DIYLAB-DE/RetroRadio/docs/hardware/README.md

# Gehäuse, Druckdateien und Befestigung

[RetroRadio](../../README.md) > [Dokumentation](../../README.md#dokumentation) > [Aufbau](../Aufbau.md) > Gehäuse, Druckdateien und Befestigung

Die Konstruktion besteht aus Gehäuse, Lautsprecherabdeckung, Lautsprechereinsätzen, einer Grundplatte für die Baugruppen und einem Aufsteller. Die Rev.2 verwendet Visaton BF 37 mit 4 Ohm. Für die frühere Rev.1 ist zusätzlich der Einsatz für Visaton SC 4.9 FL enthalten. Die Aufbauversion ist unabhängig von der Flashgröße des Displayboards.

## Dateien

| Bauteil | Druckprojekt | Bearbeitbares Austauschformat |
| --- | --- | --- |
| Gehäuse | [3MF](3d-druck/H2C_PETG_Case.3mf) | [STEP](cad/H2C_PETG_Case.step) |
| Lautsprecherabdeckung | [3MF](3d-druck/H2C_PETG_Speaker_Grille.3mf) | [STEP](cad/H2C_PETG_Speaker_Grille.step) |
| Lautsprechereinsatz BF 37, Rev.2 | [3MF](3d-druck/H2C_PETG_Speaker_Mounting_Insert_BF37.3mf) | [STEP](cad/H2C_PETG_Speaker_Mounting_Insert_BF37.step) |
| Lautsprechereinsatz SC 4.9 FL, Rev.1 | [3MF](3d-druck/H2C_PETG_Speaker_Mounting_Insert_SC_49_20FL.3mf) | [STEP](cad/H2C_PETG_Speaker_Mounting_Insert_SC_49_20FL.step) |
| Grundplatte für die Baugruppen | [3MF](3d-druck/H2C_PETG_Base_Plate.3mf) | [STEP](cad/H2C_PETG_Base_Plate.step) |
| Aufsteller | [3MF](3d-druck/H2C_PETG_Stand.3mf) | [STEP](cad/H2C_PETG_Stand.step) |

Die Lautsprechergitter hat **Frank alias Tubefan aus dem RBF (Radio-Bastler-Forum)** im CAD erstellt. Herzlichen Dank für diesen Beitrag!

## CAD-Dateien anpassen

Für eigene konstruktive Anpassungen an Gehäuse, Grundplatte oder Befestigungspunkten verwendest Du die bereitgestellten STEP-Dateien. CAD-Programme mit STEP-Import sind beispielsweise [SolidCraft](https://docs.solidcraft.io/guide/files.html) und [FreeCAD](https://github.com/FreeCAD/FreeCAD-documentation/blob/main/wiki/Part_Import.md). Nach dem Import arbeitest Du mit der vorhandenen Bauteilgeometrie weiter. Der ursprüngliche Konstruktionsverlauf ist in den STEP-Dateien nicht enthalten. Die 3MF-Dateien sind die vorbereiteten Druckprojekte für die gezeigten Teile.

Die Grundplatte und die zugehörigen 3MF- und STEP-Dateien sind für die Bestückung mit Adafruit-Audio-Modulen ausgelegt. Für das [alternative PCM5102A-Modul](../Aufbau.md#alternatives-pcm5102a-modul) müssen Befestigung und gegebenenfalls der Zugang zur Klinkenbuchse individuell angepasst werden. Eine dafür angepasste Druck- oder CAD-Datei ist noch nicht enthalten.

## Lizenz

Alle bereitgestellten 3MF-Druckprojekte und STEP-CAD-Dateien stehen unter **CC BY-NC-SA 4.0**. Teilen und Bearbeiten sind für nichtkommerzielle Zwecke erlaubt. Die Urheber müssen genannt und Bearbeitungen unter gleichen Lizenzbedingungen weitergegeben werden. Kommerzielle Nutzung ist nicht gestattet. Die [Zuordnung zu den Dateien und Urhebern](LIZENZ.txt) und der [vollständige Lizenztext](../lizenzen/CC-BY-NC-SA-4.0.txt) liegen bei. Diese Lizenz betrifft ausschließlich die CAD- und Druckdateien.

## Druckmaterial

Die Bauteile werden mit **funkelndem TINMORRY PETG Filament von Amazon** gedruckt. Die Druckprofile der 3MF-Projekte verwenden teilweise andere Materialbezeichnungen. Passe Temperatur und Kühlung an Dein Filament an und prüfe die Druckvorschau.

## Druckprojekte verwenden

Die 3MF-Dateien sind vollständige Druckprojekte mit Profilen für einen Bambu Lab H2C mit 0,4-mm-Düse. In den bereitgestellten Projekten sind 0,2 mm Schichthöhe eingestellt. Die Materialprofile umfassen PETG und bei den Lautsprechereinsätzen auch PETG-CF. Übernimm für Deinen Drucker dessen eigenes Drucker- und Materialprofil und prüfe die Druckvorschau. Die gespeicherten Profile sind kein universeller Druckauftrag für andere Maschinen.

Das Gehäuse benötigt den Bauraum eines H2C oder eines ähnlich großen Bambu-Druckers. Alle übrigen Teile passen auch auf kleinere Drucker. Alle sechs bereitgestellten Druckprojekte wurden für die gezeigten Bauteile verwendet.

| Bauteil | Wandlinien | Fülldichte | Stützmaterial im Projekt |
| --- | --- | --- | --- |
| Gehäuse | 3 | 15 % | aus |
| Lautsprecherabdeckung | 5 | 15 % | aus |
| Beide Lautsprechereinsätze | 4 | 20 % | aus |
| Grundplatte und Aufsteller | 2 | 15 % | aus |

Die Vorschauen stammen unmittelbar aus den mitgelieferten Druckprojekten:

| Gehäuse | Grundplatte | Aufsteller |
| --- | --- | --- |
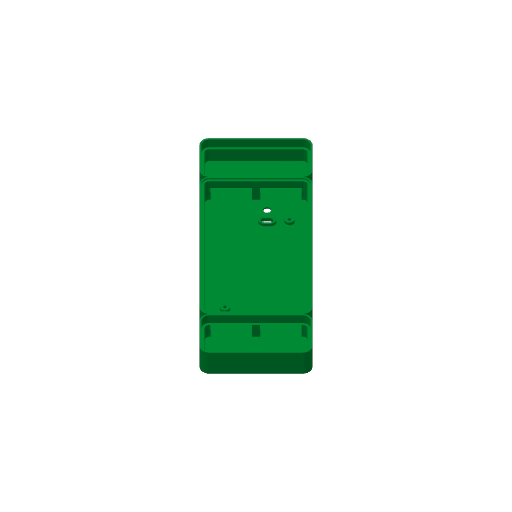
[picture p5: docs/bilder/aufbau/H2C_PETG_Case.png]
Gehäuse
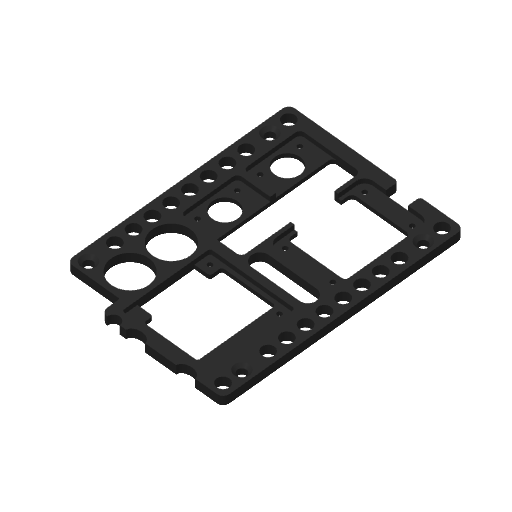
[picture p6: docs/bilder/aufbau/H2C_PETG_Base_Plate.png]
Grundplatte
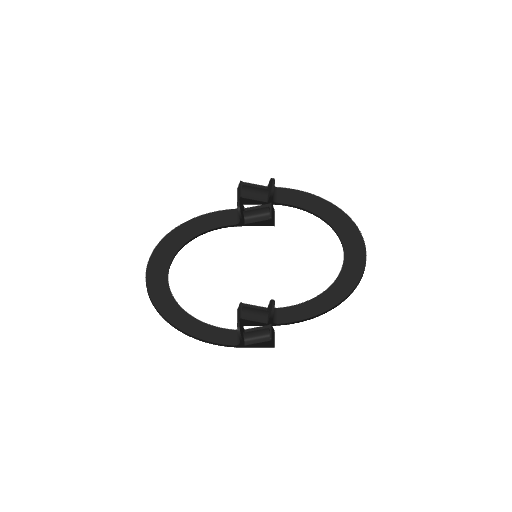
[picture p7: docs/bilder/aufbau/H2C_PETG_Stand.png]
Aufsteller
|  |  |  |

| Abdeckung | Einsatz BF 37 | Einsatz SC 4.9 FL |
| --- | --- | --- |
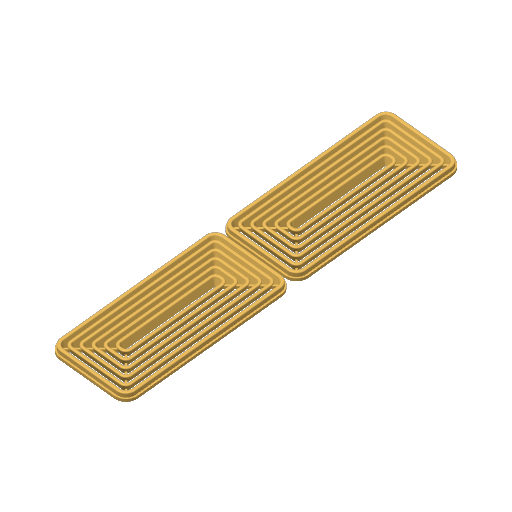
[picture p8: docs/bilder/aufbau/H2C_PETG_Speaker_Grille.png]
Abdeckung
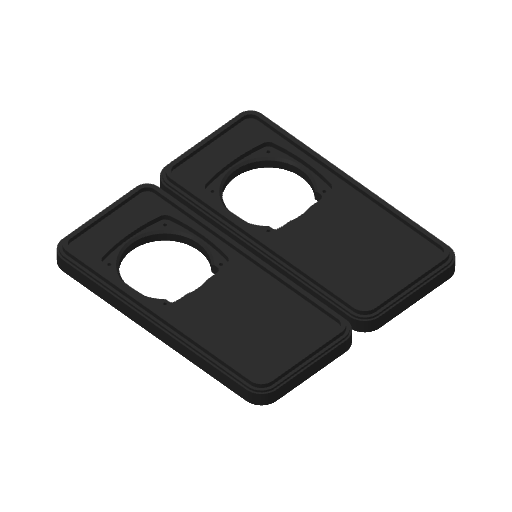
[picture p9: docs/bilder/aufbau/H2C_PETG_Speaker_Mounting_Insert_BF37.png]
Einsatz BF 37
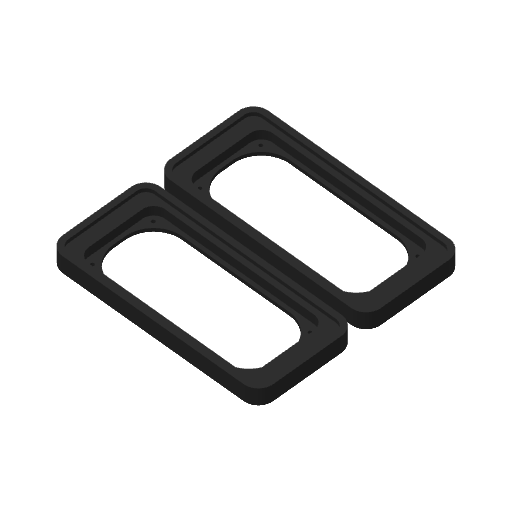
[picture p10: docs/bilder/aufbau/H2C_PETG_Speaker_Mounting_Insert_SC_49_20FL.png]
Einsatz SC 4.9 FL
|  |  |  |

## Befestigungsmittel

> **Display ohne Verklebung montieren:** Die beiden Befestigungsschrauben reichen zum sicheren Halt im Gehäuse aus. Die Abdeckfolie auf der Glasrückseite bleibt angebracht, nur ihre Abziehlasche wird abgeschnitten. Die beiden Schutzfolien der Vorderseite werden entfernt. Die genaue Zuordnung der Folien steht in der [Aufbauanleitung](../Aufbau.md#display-und-befestigungsbolzen).

Die kleinen Schrauben zur Befestigung von Verstärkern, RTC und DAC auf der Grundplatte stammen aus einem Sortiment mit der Bezeichnung **Black Zinc-Plated Carbon Steel Pan Flat Head Self Tapping Screws Metric**. Im Sortiment heißen sie **M2*5**. Es sind selbstschneidende Schrauben und keine metrischen M2-Maschinenschrauben. Die Sortimentsbezeichnung allein ist daher keine Gewindeangabe nach metrischer Norm.

Für die übrigen Verbindungen werden Schrauben in M2,5 und M3 aus dem Sortiment **Alloy Steel Grade 10.9 Button Flat Socket Head Screws** verwendet. Wähle Länge und Ausführung passend zum jeweiligen Bauteil und zur tatsächlich verfügbaren Einschraubtiefe. Die Sortimentskästen sind in den Aufbaufotos zu sehen und dienen der Zuordnung der verwendeten Teile.

Für die Befestigung brauchst Du außerdem **vier Bolzen mit M2,5-Gewinde und 4 mm langem Körper** sowie **zwei Bolzen mit M3-Gewinde und 15 mm langem Körper**.

> **Nur die außenliegenden Gewinde kürzen.** Die Bolzenkörper bleiben 4 mm beziehungsweise 15 mm lang. Zu lange Gewinde können bis an das Display reichen und es beschädigen. Prüfe die verfügbare Einschraubtiefe vor der Montage und gleiche die Gewindelänge mit der gezeigten gekürzten Ausführung ab. Die kurzen Bolzen halten die Grundplatte. Die zwei langen M3-Bolzen sitzen diagonal am Display an den konstruktiv vorgesehenen Punkten.

Die bearbeiteten Bolzen sind im Montagefoto links als Ausgangsteile und rechts mit gekürzten Außengewinden dargestellt. Die kurzen Bolzen können bei Bedarf direkt an der Platine festgelötet werden, falls die Gewinde im Display sie nicht halten.

| Selbstschneidende Schrauben | Metrische Schrauben | Bolzen mit gekürzten Außengewinden |
| --- | --- | --- |
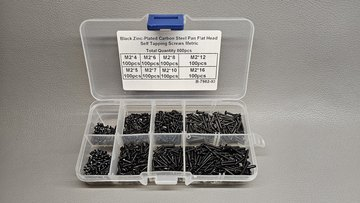
[picture p11: docs/bilder/aufbau/20260822_193423-klein.jpg]
Schraubensortiment
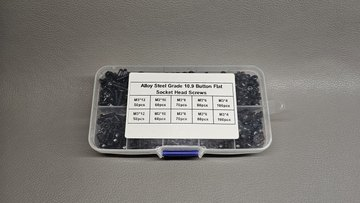
[picture p12: docs/bilder/aufbau/20260822_193522-klein.jpg]
Metrisches Sortiment
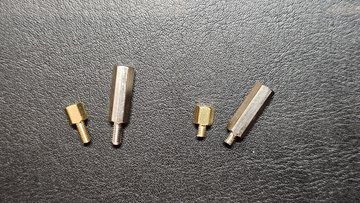
[picture p13: docs/bilder/aufbau/20261028_213523-klein.jpg]
Befestigungsbolzen
|  |  |  |

Weiter mit der [Aufbauanleitung](../Aufbau.md) oder der vollständigen [Fotogalerie](../Fotogalerie.md).

[RetroRadio](../../README.md) > [Dokumentation](../../README.md#dokumentation) > [Aufbau](../Aufbau.md) > Gehäuse, Druckdateien und Befestigung
