DIYLAB-DE/RetroRadio/docs/werkstatt/README.md

# Werkstatt

[RetroRadio](../../README.md) > [Dokumentation](../../README.md#dokumentation) > Werkstatt

38 Werkzeuge in sieben Kategorien. Im linken Menü nach oben oder unten wischen und das gewünschte Werkzeug antippen. Rechts stehen Inhalt und Eingaben, die Tasten am unteren Rand gehören zum gewählten Werkzeug. Die Taste ganz rechts verlässt die Werkstatt.

Die kleinen Vorschaubilder öffnen die vollständigen Screenshots mit 800 x 480 Pixeln. Jede Werkzeugseite erklärt Zweck und Bedienung. Die früheren Website-Links und ihre QR-Code-Tasten in den Werkzeugüberschriften entfallen seit v26.11.7. Ältere Werkzeugaufnahmen können diese Tasten noch zeigen.

## Werkzeuge

| Werkzeug | Vorschau |
| --- | --- |
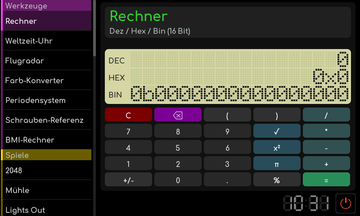
[picture p14: docs/bilder/werkstatt/werkstatt-calculator-klein.png]
Rechner
| [Rechner](calculator.md) | [](calculator.md) |
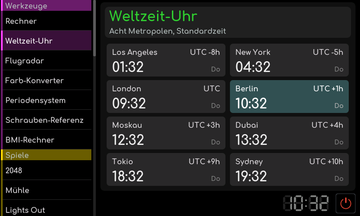
[picture p15: docs/bilder/werkstatt/werkstatt-world-clock-klein.png]
Weltzeit-Uhr
| [Weltzeit-Uhr](world-clock.md) | [](world-clock.md) |
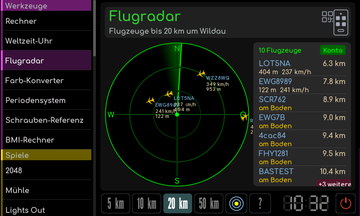
[picture p16: docs/bilder/werkstatt/werkstatt-flight-radar-klein.png]
Flugradar
| [Flugradar](flight-radar.md) | [](flight-radar.md) |
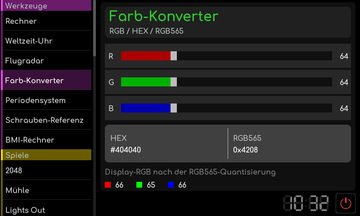
[picture p17: docs/bilder/werkstatt/werkstatt-color-converter-klein.png]
Farb-Konverter
| [Farb-Konverter](color-converter.md) | [](color-converter.md) |
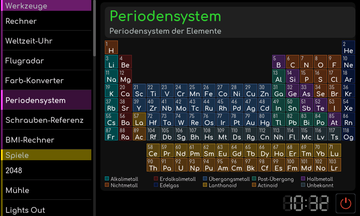
[picture p18: docs/bilder/werkstatt/werkstatt-periodic-table-klein.png]
Periodensystem
| [Periodensystem](periodic-table.md) | [](periodic-table.md) |
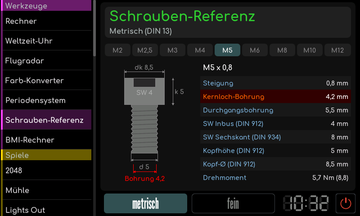
[picture p19: docs/bilder/werkstatt/werkstatt-screw-reference-klein.png]
Schrauben-Referenz
| [Schrauben-Referenz](screw-reference.md) | [](screw-reference.md) |
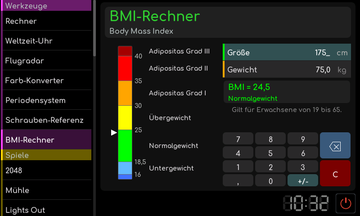
[picture p20: docs/bilder/werkstatt/werkstatt-bmi-calculator-klein.png]
BMI-Rechner
| [BMI-Rechner](bmi-calculator.md) | [](bmi-calculator.md) |

## Spiele

| Werkzeug | Vorschau |
| --- | --- |
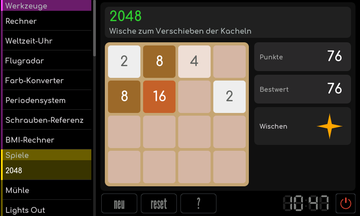
[picture p21: docs/bilder/werkstatt/werkstatt-game-2048-klein.png]
| [2048](game-2048.md) | [](game-2048.md) |
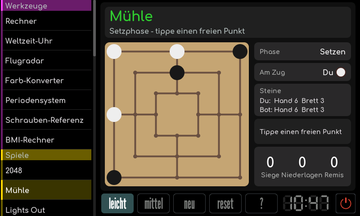
[picture p22: docs/bilder/werkstatt/werkstatt-mill-game-klein.png]
Mühle
| [Mühle](mill-game.md) | [](mill-game.md) |
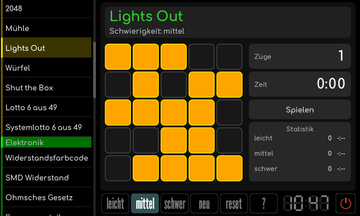
[picture p23: docs/bilder/werkstatt/werkstatt-lights-out-klein.png]
Lights Out
| [Lights Out](lights-out.md) | [](lights-out.md) |
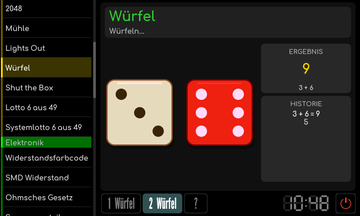
[picture p24: docs/bilder/werkstatt/werkstatt-dice-klein.png]
Würfel
| [Würfel](dice.md) | [](dice.md) |
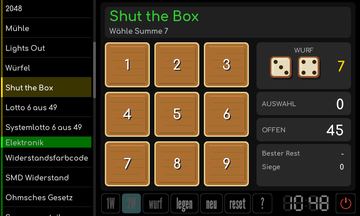
[picture p25: docs/bilder/werkstatt/werkstatt-shut-the-box-klein.png]
Shut the Box
| [Shut the Box](shut-the-box.md) | [](shut-the-box.md) |
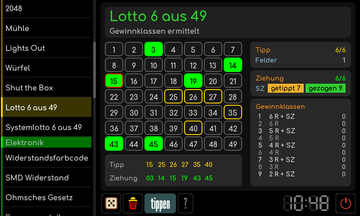
[picture p26: docs/bilder/werkstatt/werkstatt-lotto-normal-klein.png]
Lotto 6 aus 49
| [Lotto 6 aus 49](lotto-normal.md) | [](lotto-normal.md) |
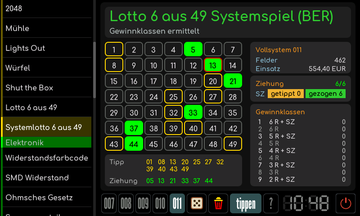
[picture p27: docs/bilder/werkstatt/werkstatt-lotto-system-klein.png]
Lotto-System
| [Lotto-System](lotto-system.md) | [](lotto-system.md) |

## Elektronik

| Werkzeug | Vorschau |
| --- | --- |
| [Widerstandsfarbcode](resistor-color-code.md) | [Widerstandsfarbcode](resistor-color-code.md) |
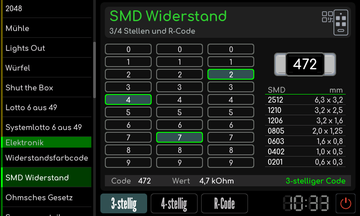
[picture p28: docs/bilder/werkstatt/werkstatt-smd-resistor-code-klein.png]
SMD-Widerstandscode
| [SMD-Widerstandscode](smd-resistor-code.md) | [](smd-resistor-code.md) |
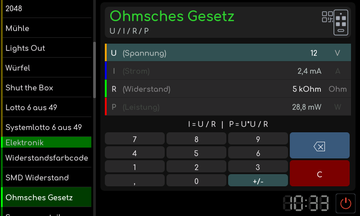
[picture p29: docs/bilder/werkstatt/werkstatt-ohm-calculator-klein.png]
Ohmsches Gesetz
| [Ohmsches Gesetz](ohm-calculator.md) | [](ohm-calculator.md) |
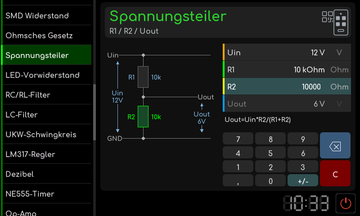
[picture p30: docs/bilder/werkstatt/werkstatt-voltage-divider-klein.png]
Spannungsteiler
| [Spannungsteiler](voltage-divider.md) | [](voltage-divider.md) |
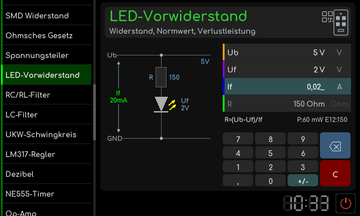
[picture p31: docs/bilder/werkstatt/werkstatt-led-resistor-calculator-klein.png]
LED-Vorwiderstand
| [LED-Vorwiderstand](led-resistor-calculator.md) | [](led-resistor-calculator.md) |
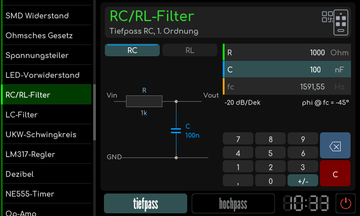
[picture p32: docs/bilder/werkstatt/werkstatt-rc-rl-filter-calculator-klein.png]
RC/RL-Filter
| [RC/RL-Filter](rc-rl-filter-calculator.md) | [](rc-rl-filter-calculator.md) |
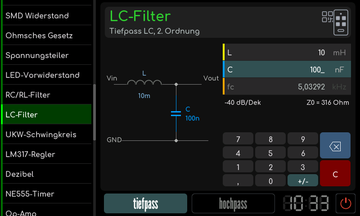
[picture p33: docs/bilder/werkstatt/werkstatt-lc-filter-calculator-klein.png]
LC-Filter
| [LC-Filter](lc-filter-calculator.md) | [](lc-filter-calculator.md) |
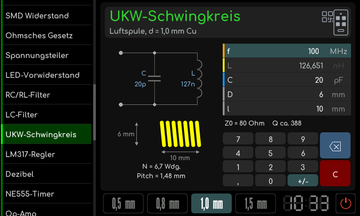
[picture p34: docs/bilder/werkstatt/werkstatt-ukw-resonator-klein.png]
UKW-Schwingkreis
| [UKW-Schwingkreis](ukw-resonator.md) | [](ukw-resonator.md) |
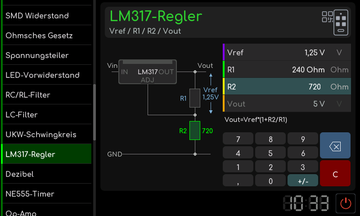
[picture p35: docs/bilder/werkstatt/werkstatt-lm317-calculator-klein.png]
LM317-Regler
| [LM317-Regler](lm317-calculator.md) | [](lm317-calculator.md) |
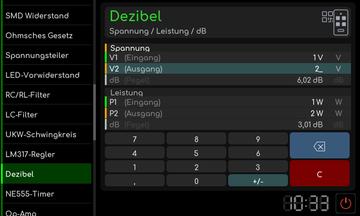
[picture p36: docs/bilder/werkstatt/werkstatt-decibel-calculator-klein.png]
Dezibel
| [Dezibel](decibel-calculator.md) | [](decibel-calculator.md) |
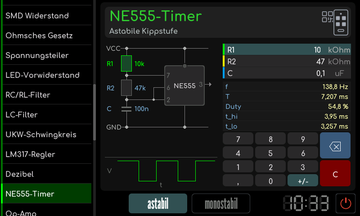
[picture p37: docs/bilder/werkstatt/werkstatt-ne555-calculator-klein.png]
NE555-Timer
| [NE555-Timer](ne555-calculator.md) | [](ne555-calculator.md) |
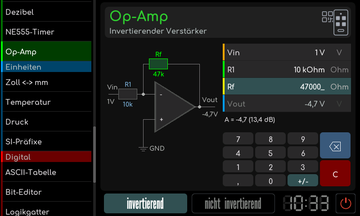
[picture p38: docs/bilder/werkstatt/werkstatt-opamp-calculator-klein.png]
Op-Amp
| [Op-Amp](opamp-calculator.md) | [](opamp-calculator.md) |

## Einheiten

| Werkzeug | Vorschau |
| --- | --- |
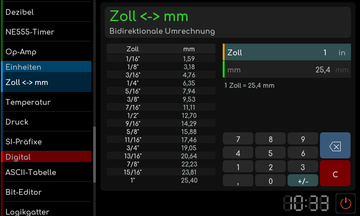
[picture p39: docs/bilder/werkstatt/werkstatt-inch-mm-calculator-klein.png]
Zoll und Millimeter
| [Zoll und Millimeter](inch-mm-calculator.md) | [](inch-mm-calculator.md) |
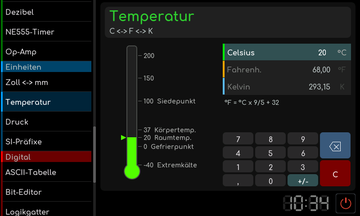
[picture p40: docs/bilder/werkstatt/werkstatt-temp-calculator-klein.png]
Temperatur
| [Temperatur](temp-calculator.md) | [](temp-calculator.md) |
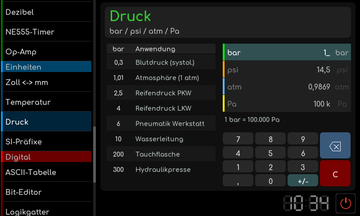
[picture p41: docs/bilder/werkstatt/werkstatt-pressure-calculator-klein.png]
Druck
| [Druck](pressure-calculator.md) | [](pressure-calculator.md) |
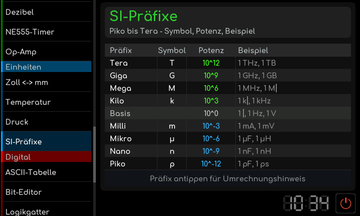
[picture p42: docs/bilder/werkstatt/werkstatt-si-prefixes-klein.png]
SI-Präfixe
| [SI-Präfixe](si-prefixes.md) | [](si-prefixes.md) |

## Digital

| Werkzeug | Vorschau |
| --- | --- |
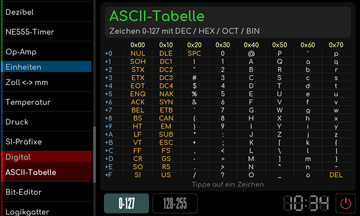
[picture p43: docs/bilder/werkstatt/werkstatt-ascii-table-klein.png]
ASCII-Tabelle
| [ASCII-Tabelle](ascii-table.md) | [](ascii-table.md) |
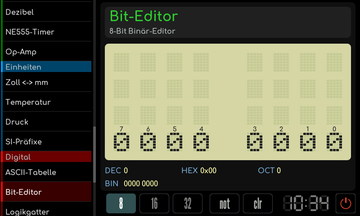
[picture p44: docs/bilder/werkstatt/werkstatt-bit-editor-klein.png]
Bit-Editor
| [Bit-Editor](bit-editor.md) | [](bit-editor.md) |
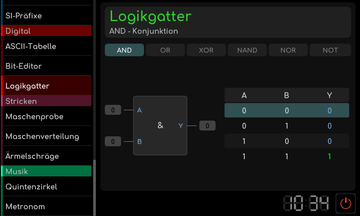
[picture p45: docs/bilder/werkstatt/werkstatt-logic-gate-sim-klein.png]
Logikgatter
| [Logikgatter](logic-gate-sim.md) | [](logic-gate-sim.md) |

## Stricken

| Werkzeug | Vorschau |
| --- | --- |
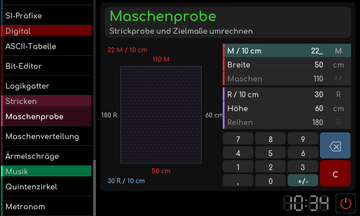
[picture p46: docs/bilder/werkstatt/werkstatt-stitch-gauge-klein.png]
Maschenprobe
| [Maschenprobe](stitch-gauge.md) | [](stitch-gauge.md) |
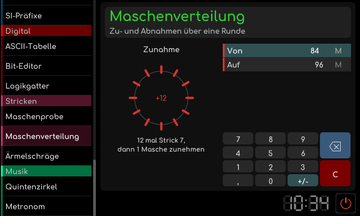
[picture p47: docs/bilder/werkstatt/werkstatt-stitch-distributor-klein.png]
Maschenverteilung
| [Maschenverteilung](stitch-distributor.md) | [](stitch-distributor.md) |
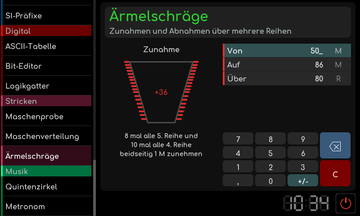
[picture p48: docs/bilder/werkstatt/werkstatt-sleeve-taper-klein.png]
Ärmelschräge
| [Ärmelschräge](sleeve-taper.md) | [](sleeve-taper.md) |

## Musik

| Werkzeug | Vorschau |
| --- | --- |
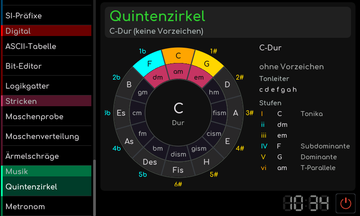
[picture p49: docs/bilder/werkstatt/werkstatt-circle-of-fifths-klein.png]
Quintenzirkel
| [Quintenzirkel](circle-of-fifths.md) | [](circle-of-fifths.md) |
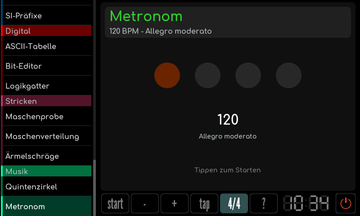
[picture p50: docs/bilder/werkstatt/werkstatt-metronome-klein.png]
Metronom
| [Metronom](metronome.md) | [](metronome.md) |

[Zur allgemeinen Bedienung](../Bedienung.md)

[RetroRadio](../../README.md) > [Dokumentation](../../README.md#dokumentation) > Werkstatt
