DIYLAB-DE/RetroRadio/docs/werkstatt/inch-mm-calculator.md

# Zoll und Millimeter

[RetroRadio](../../README.md) > [Dokumentation](../../README.md#dokumentation) > [Werkstatt](README.md) > [Einheiten](README.md#einheiten) > Zoll und Millimeter

Tippe das Zoll- oder Millimeterfeld an und gib einen Wert ein. Der andere Wert wird mit 1 Zoll = 25,4 mm umgerechnet. Die Bruchauswahl hilft bei üblichen Zollmaßen. Beispiel: 1/2 Zoll entspricht 12,7 mm.

Zoll und Millimeter

[RetroRadio](../../README.md) > [Dokumentation](../../README.md#dokumentation) > [Werkstatt](README.md) > [Einheiten](README.md#einheiten) > Zoll und Millimeter
