DIYLAB-DE/RetroRadio/docs/werkstatt/mill-game.md

# Mühle

[RetroRadio](../../README.md) > [Dokumentation](../../README.md#dokumentation) > [Werkstatt](README.md) > [Spiele](README.md#spiele) > Mühle

Du spielst mit neun Steinen gegen den Bot. Zunächst freie Punkte antippen und die Steine setzen. Danach einen eigenen Stein und ein freies Nachbarfeld wählen. Mit nur drei Steinen ist Springen erlaubt. Eine geschlossene Mühle erlaubt das Schlagen eines gegnerischen Steins. Unten Schwierigkeit und neue Partie wählen, Reset löscht nach Bestätigung die gespeicherte Bilanz.

Mühle

[RetroRadio](../../README.md) > [Dokumentation](../../README.md#dokumentation) > [Werkstatt](README.md) > [Spiele](README.md#spiele) > Mühle
