DIYLAB-DE/RetroRadio/docs/werkstatt/ohm-calculator.md

# Ohmsches Gesetz

[RetroRadio](../../README.md) > [Dokumentation](../../README.md#dokumentation) > [Werkstatt](README.md) > [Elektronik](README.md#elektronik) > Ohmsches Gesetz

Wähle zwei bekannte Größen aus Spannung U, Strom I, Widerstand R und Leistung P und gib sie mit passender Einheit ein. Die übrigen Werte werden daraus berechnet. Beispiel: 12 V und 5 kOhm ergeben 2,4 mA und 28,8 mW. Das Werkzeug zeigt die zusammengehörigen Größen gemeinsam an.

Ohmsches Gesetz

[RetroRadio](../../README.md) > [Dokumentation](../../README.md#dokumentation) > [Werkstatt](README.md) > [Elektronik](README.md#elektronik) > Ohmsches Gesetz
