DIYLAB-DE/RetroRadio/docs/werkstatt/pressure-calculator.md

# Druck

[RetroRadio](../../README.md) > [Dokumentation](../../README.md#dokumentation) > [Werkstatt](README.md) > [Einheiten](README.md#einheiten) > Druck

Wähle bar, psi, atm oder Pa und gib den Druck ein. Die Anzeige rechnet die übrigen Einheiten um. Die Tabelle daneben enthält typische Größenordnungen zur Einordnung. Beispiel: 1 bar entspricht 100.000 Pa. Die Einheit atm bezeichnet die Standardatmosphäre.

Druck

[RetroRadio](../../README.md) > [Dokumentation](../../README.md#dokumentation) > [Werkstatt](README.md) > [Einheiten](README.md#einheiten) > Druck
