DIYLAB-DE/RetroRadio/docs/werkstatt/rc-rl-filter-calculator.md

# RC/RL-Filter

[RetroRadio](../../README.md) > [Dokumentation](../../README.md#dokumentation) > [Werkstatt](README.md) > [Elektronik](README.md#elektronik) > RC/RL-Filter

Wähle RC oder RL sowie tiefpass oder hochpass. Gib die angezeigten Bauteilwerte ein. Das Werkzeug zeigt Grenzfrequenz, Schaltung und Frequenzgang eines Filters erster Ordnung. Bei einem Wechsel der Schaltung die Einheiten des Kondensators beziehungsweise der Spule beachten.

RC/RL-Filter

**RC-Hochpass**

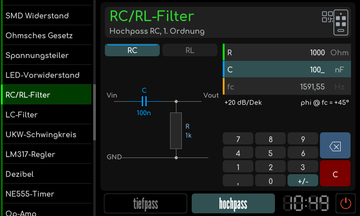
[picture p56: docs/bilder/werkstatt/werkstatt-rc-rl-filter-calculator-rc-hochpass-klein.png]
RC-Hochpass


**RL-Hochpass**

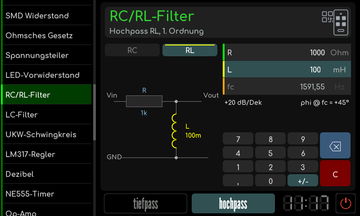
[picture p57: docs/bilder/werkstatt/werkstatt-rc-rl-filter-calculator-rl-hochpass-klein.png]
RL-Hochpass


**RL-Tiefpass**

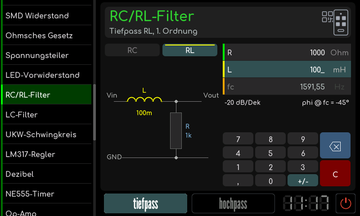
[picture p58: docs/bilder/werkstatt/werkstatt-rc-rl-filter-calculator-rl-tiefpass-klein.png]
RL-Tiefpass


[RetroRadio](../../README.md) > [Dokumentation](../../README.md#dokumentation) > [Werkstatt](README.md) > [Elektronik](README.md#elektronik) > RC/RL-Filter
