DIYLAB-DE/RetroRadio/docs/werkstatt/screw-reference.md

# Schrauben-Referenz

[RetroRadio](../../README.md) > [Dokumentation](../../README.md#dokumentation) > [Werkstatt](README.md) > [Werkzeuge](README.md#werkzeuge) > Schrauben-Referenz

Wähle einen metrischen Gewindedurchmesser. Die Referenz zeigt Steigung, Kernloch- und Durchgangsbohrung sowie Kopf- und Schlüsselmaße. Die Tasten unten wechseln zwischen metrischem Regelgewinde und Feingewinde. Die angezeigten DIN-Bezüge und die jeweilige Schraubenart gehören zur Angabe, Werte nicht auf beliebige andere Schraubenköpfe übertragen.

Schrauben-Referenz

**Feingewinde**

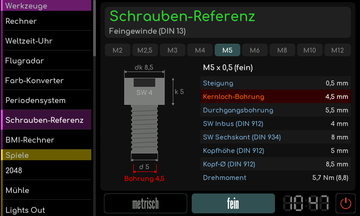
[picture p60: docs/bilder/werkstatt/werkstatt-screw-reference-feingewinde-klein.png]
Feingewinde


[RetroRadio](../../README.md) > [Dokumentation](../../README.md#dokumentation) > [Werkstatt](README.md) > [Werkzeuge](README.md#werkzeuge) > Schrauben-Referenz
