DIYLAB-DE/RetroRadio/docs/werkstatt/stitch-distributor.md

# Maschenverteilung

[RetroRadio](../../README.md) > [Dokumentation](../../README.md#dokumentation) > [Werkstatt](README.md) > [Stricken](README.md#stricken) > Maschenverteilung

Trage die bisherige Maschenzahl unter Von und die gewünschte Zahl unter Auf ein. Das Werkzeug verteilt Zu- oder Abnahmen auf eine Runde und formuliert die einzelnen Strickabschnitte. Bei gleichen Werten wird keine Änderung benötigt, eine für eine Runde zu große Differenz wird angezeigt.

Maschenverteilung

[RetroRadio](../../README.md) > [Dokumentation](../../README.md#dokumentation) > [Werkstatt](README.md) > [Stricken](README.md#stricken) > Maschenverteilung
