DIYLAB-DE/RetroRadio/docs/werkstatt/temp-calculator.md

# Temperatur

[RetroRadio](../../README.md) > [Dokumentation](../../README.md#dokumentation) > [Werkstatt](README.md) > [Einheiten](README.md#einheiten) > Temperatur

Wähle Celsius, Fahrenheit oder Kelvin als Eingabefeld und gib den Wert ein. Die übrigen Einheiten werden umgerechnet. Beispiel: 20 °C entsprechen 68 °F und 293,15 K. Die Referenzwerte und Formeln stehen daneben.

Temperatur

[RetroRadio](../../README.md) > [Dokumentation](../../README.md#dokumentation) > [Werkstatt](README.md) > [Einheiten](README.md#einheiten) > Temperatur
