DIYLAB-DE/RetroRadio/docs/werkstatt/ukw-resonator.md

# UKW-Schwingkreis

[RetroRadio](../../README.md) > [Dokumentation](../../README.md#dokumentation) > [Werkstatt](README.md) > [Elektronik](README.md#elektronik) > UKW-Schwingkreis

Gib die im Werkzeug angebotenen Spulen- und Kondensatorwerte ein und wähle den Drahtdurchmesser. Die Anzeige berechnet den Schwingkreis und zeigt eine Skizze der Luftspule. Warnungen zu überlappenden Windungen oder Werten außerhalb des Bereichs beachten. Die angezeigte Güte ist als Näherung gekennzeichnet.

UKW-Schwingkreis

**Drahtdurchmesser 0,8 mm**

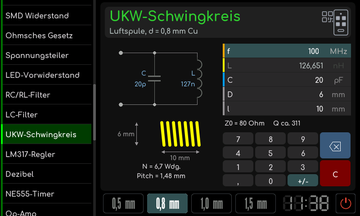
[picture p63: docs/bilder/werkstatt/werkstatt-ukw-resonator-draht-08-klein.png]
Drahtdurchmesser 0,8 mm


**Drahtdurchmesser 1,0 mm**

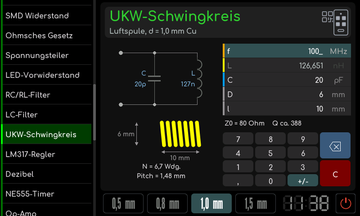
[picture p64: docs/bilder/werkstatt/werkstatt-ukw-resonator-draht-10-klein.png]
Drahtdurchmesser 1,0 mm


**Drahtdurchmesser 1,5 mm mit Überlappungswarnung**

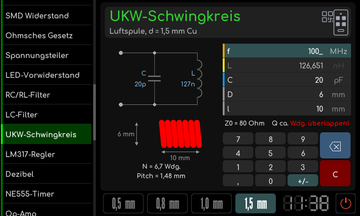
[picture p65: docs/bilder/werkstatt/werkstatt-ukw-resonator-draht-15-klein.png]
Drahtdurchmesser 1,5 mm mit Überlappungswarnung


[RetroRadio](../../README.md) > [Dokumentation](../../README.md#dokumentation) > [Werkstatt](README.md) > [Elektronik](README.md#elektronik) > UKW-Schwingkreis
