DIYLAB-DE/RetroRadio/docs/werkstatt/voltage-divider.md

# Spannungsteiler

[RetroRadio](../../README.md) > [Dokumentation](../../README.md#dokumentation) > [Werkstatt](README.md) > [Elektronik](README.md#elektronik) > Spannungsteiler

Gib die bekannten Werte des Spannungsteilers in die zugehörigen Felder ein und beachte die Einheitenauswahl. Die Schaltskizze ordnet R1, R2 sowie Ein- und Ausgangsspannung zu. Die Berechnung beschreibt den angezeigten Widerstandsteiler, eine angeschlossene Last ist bei der tatsächlichen Schaltung zusätzlich zu berücksichtigen.

Spannungsteiler

[RetroRadio](../../README.md) > [Dokumentation](../../README.md#dokumentation) > [Werkstatt](README.md) > [Elektronik](README.md#elektronik) > Spannungsteiler
