DIYLAB-DE/RetroRadio/docs/Bedienung.md

# RetroRadio bedienen

[RetroRadio](../README.md) > [Dokumentation](../README.md#dokumentation) > RetroRadio bedienen

Nach der [Erstinstallation](RetroRadio-Ersteinrichtung.md) öffnet das Hauptmenü die Anwendungen über die großen Symbole rechts. Die Uhr und die Netzwerkangaben stehen links. Das Haus unten rechts führt zurück ins Hauptmenü. Bei Radio und SD-Player öffnet es zuerst den Sleep-Timer: Tippe dort erneut auf das Haus, um die Wiedergabe sofort zu beenden und ins Hauptmenü zu wechseln.

Der Sekundenzeiger der großen Uhr läuft standardmäßig schleichend. Unter **Einstellungen -> Zeit & Zeitserver -> Sekundenzeiger** kannst Du auf **Sekundenschritte** umschalten. Die Wahl wirkt sofort, wird automatisch gespeichert und bleibt nach einem Neustart erhalten. Derselbe Schalter steht in der [Weboberfläche](Weboberfläche.md#systemeinstellungen). Nach Werkseinstellungen gilt wieder **schleichend**.

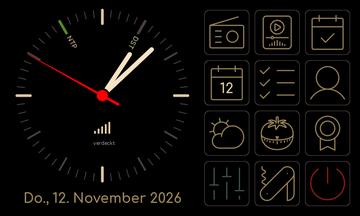
[picture p69: docs/bilder/bedienung/hauptmenue-klein.png]
Hauptmenü


| Zeile | Links | Mitte | Rechts |
| --- | --- | --- | --- |
| 1 | Internetradio | SD-Player | Tagesansicht |
| 2 | Kalender | Aufgaben | Kontakte |
| 3 | Wetter | Pomodoro / Timer | Auszeit |
| 4 | Einstellungen | Werkstatt | Ausschalten |

Ein kurzer Tipp wählt eine Taste oder ein Feld. Listen lassen sich mit dem Finger verschieben. Ein längerer Druck oder Wischen hat nur an den jeweils beschriebenen Stellen eine Zusatzfunktion. Eingabedialoge besitzen eigene Bestätigungs- und Abbruchmöglichkeiten. Beim Bearbeiten von Einstellungen auf die angezeigte Speichern-Taste achten, das Verlassen kann bei ungespeicherten Änderungen eine Rückfrage auslösen.

## Radio, SD-Player und Werkstatt

- [Radio und Musik](Radio-und-Musik.md): Sender, Favoriten, Klang, alle acht Visualisierungen, vier magische Augen, Dateiauswahl, Cover und Kassetten.
- [Werkstatt mit 38 Werkzeugen](werkstatt/README.md): nach Kategorien geordnete Übersicht mit einzelnen Werkzeugseiten und anklickbaren Vorschaubildern.
- [Weboberfläche](Weboberfläche.md): Bedienung und Verwaltung im Browser, einschließlich Senderpflege, Sortieren der 70 Senderplätze und SD-Dateien.

## Tagesansicht

Die Tagesansicht verbindet Uhr, Datum, Wetter, kommende Termine, Aufgaben und Geburtstage. Am unteren Rand liegen die Radio- und SD-Bedienelemente. Favoriten und Senderwechsel sind links angeordnet, daneben folgen die Lautstärke-Tasten und die SD-Aktionen. Die kleine Anzeige zwischen Minus und Plus zeigt die Lautstärke. Die Laufzeile darüber zeigt Nachrichten beziehungsweise Informationen zur Wiedergabe.

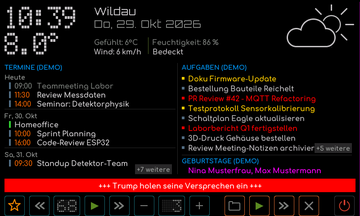
[picture p70: docs/bilder/bedienung/tagesansicht-demo-klein.png]
Tagesansicht mit Demodaten


Radio-Favoriten öffnen die Senderauswahl. Die Pfeile wechseln den Sender, die Wiedergabetaste startet beziehungsweise unterbricht die entsprechende Audioquelle. Über das Ordnersymbol lassen sich SD-Titel auswählen. Die SD-Gruppe bietet außerdem Wiedergabe, nächsten Titel und das Leeren der Liste. Die beiden Audioquellen werden nicht gleichzeitig abgespielt.

Kalender und Aufgaben verwenden die in der [Google-Anbindung](dienste/google/README.md) gespeicherten Adressen. Ohne die jeweilige Verbindung erscheint eine als **DEMO** gekennzeichnete Auswahl. Das Wetter verwendet den eingestellten Wetterstandort. Die Abbildung zeigt die eingebauten Demodaten.

## Kalender

Links steht die Liste der kommenden Termine, rechts stehen der aktuelle und der nächste Monat. Der heutige Tag ist hervorgehoben, Markierungen kennzeichnen Tage mit Terminen. Wische in der Terminliste, um weitere Einträge zu sehen. Ganztägige Einträge und Termine mit Uhrzeit werden unterschiedlich dargestellt.

| Übersicht | Weitere Termine |
| --- | --- |
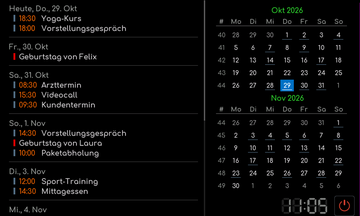
[picture p71: docs/bilder/bedienung/kalender-demo-klein.png]
Kalenderübersicht
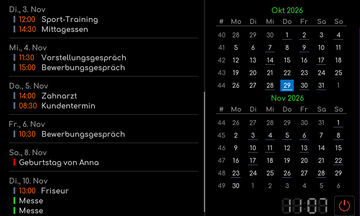
[picture p72: docs/bilder/bedienung/kalender-demo-termine-klein.png]
Terminliste
|  |  |

Termine werden in Google Kalender gepflegt. Die Geräteansicht zeigt sie an, sie ist kein Editor zum Anlegen neuer Termine. Die zugehörige Web-App und die eingebundenen Kalender werden in der [Google-Anleitung](dienste/google/README.md) eingerichtet. Die Abbildungen zeigen die eingebauten Demotermine.

## Aufgaben

Links stehen Aufgaben nach Listen gegliedert. Die Datumsfarbe kennzeichnet unter anderem heute fällige und überfällige Einträge. Rechts zeigt die Statistik die Gesamtzahl, offene, heute fällige und überfällige Aufgaben. Der Schalter **Erledigte** blendet abgeschlossene Einträge ein oder aus. **Aktualisieren** ruft die Liste erneut ab.

| Aufgabenliste | Nur offene Aufgaben | Bestätigung |
| --- | --- | --- |
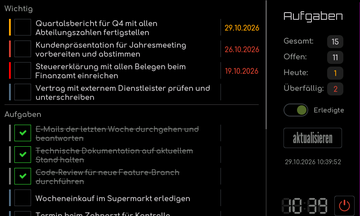
[picture p73: docs/bilder/bedienung/aufgaben-demo-klein.png]
Aufgaben
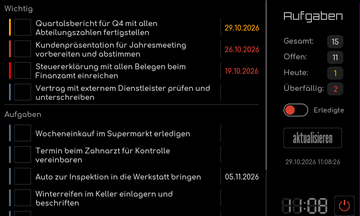
[picture p74: docs/bilder/bedienung/aufgaben-demo-offene-klein.png]
Offene Aufgaben
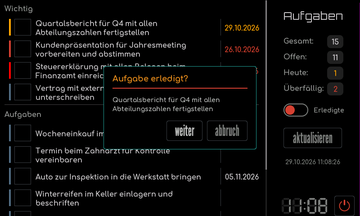
[picture p75: docs/bilder/bedienung/aufgaben-demo-bestaetigung-klein.png]
Aufgabe bestätigen
|  |  |  |

Tippe das Kästchen vor einer Aufgabe an. Der Dialog nennt die betroffene Aufgabe und fragt vor der Änderung nach. Bei eingerichteter Google-Verbindung wird die bestätigte Änderung auch in Google Tasks übernommen. Ein erledigter Eintrag kann entsprechend wieder geöffnet werden. Im Demomodus werden keine Google-Aufgaben geändert. Neue Aufgaben und Notizen pflegst Du in Google Tasks.

## Kontakte

Die linke Liste zeigt die Kontakte. Die Buchstabenleiste springt zum jeweiligen Anfangsbuchstaben, Wischen bewegt die Liste. Ein Tipp auf einen Namen zeigt rechts Telefonnummern, E-Mail, Adresse, Organisation und Geburtstag, soweit diese Angaben vorhanden sind.

| Kontakt und Details | Suche | Suchergebnis |
| --- | --- | --- |
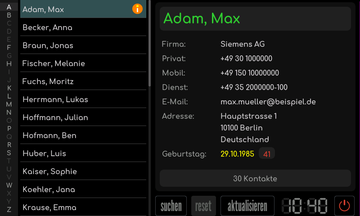
[picture p76: docs/bilder/bedienung/kontakte-demo-klein.png]
Kontaktdetails
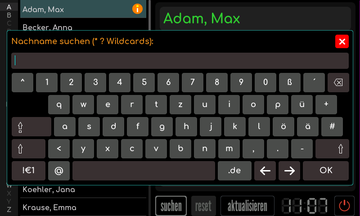
[picture p77: docs/bilder/bedienung/kontakte-demo-suche-klein.png]
Kontaktsuche
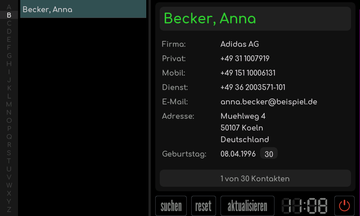
[picture p78: docs/bilder/bedienung/kontakte-demo-suchergebnis-klein.png]
Gefilterte Kontakte
|  |  |  |

**Suchen** öffnet die Bildschirmtastatur für die Nachnamensuche. Der Dialog unterstützt die angegebenen Platzhalter **\*** und **?**. **Reset** hebt die Suche auf, **Aktualisieren** lädt die Kontakte neu. Die Kontaktpflege erfolgt in Google Kontakte, nicht in der Geräteanzeige. Die Bilder zeigen ausschließlich eingebaute Demokontakte.

## Wetter

Die Wetterseite zeigt den Ort, den Zeitpunkt der Daten sowie Temperatur, gefühlte Temperatur, Wind und Luftfeuchtigkeit. Darunter steht die Vorhersage für fünf Tage mit Wetterbild, Temperaturbereich und Niederschlagswahrscheinlichkeit.

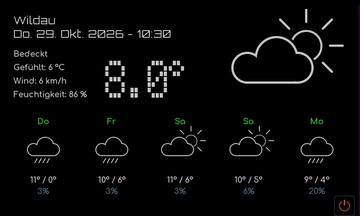
[picture p79: docs/bilder/bedienung/wetter-uebersicht-klein.png]
Wettervorhersage


Den Ort unter **Einstellungen -> Wetter** über die deutsche Postleitzahl einstellen. Die Ortssuche benötigt WLAN. Ein persönlicher Wetter-API-Schlüssel wird nicht eingetragen. Das Wettermodul und die Tagesansicht verwenden denselben gespeicherten Standort. Datenquelle: [Open-Meteo](https://open-meteo.com/).

## Pomodoro und Kurzzeitmesser

Im Pomodoro-Modus startet **Start** einen Arbeitsabschnitt. Während des Laufs wird daraus die Pausenfunktion, ein weiterer Druck setzt den Abschnitt fort. **Stop** bricht ihn ab. Der Kreis und die Restzeit zeigen den Fortschritt. Rechts stehen die Sitzung innerhalb des Viererblocks und die heute abgeschlossenen Pomodoros.

| Bereit | Laufend | Unterbrochen |
| --- | --- | --- |
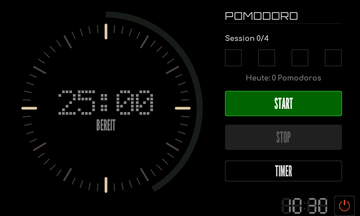
[picture p80: docs/bilder/bedienung/pomodoro-uebersicht-klein.png]
Pomodoro bereit
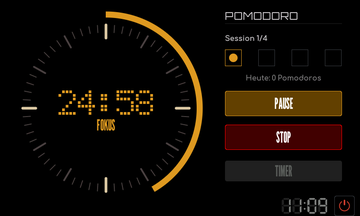
[picture p81: docs/bilder/bedienung/pomodoro-laufend-klein.png]
Pomodoro läuft
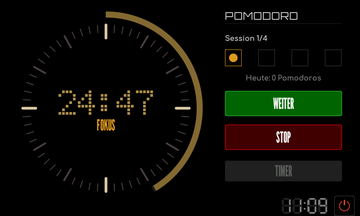
[picture p82: docs/bilder/bedienung/pomodoro-pausiert-klein.png]
Pomodoro pausiert
|  |  |  |

Die Taste **Timer** wechselt im angehaltenen Ausgangszustand zum einfachen Kurzzeitmesser. Dort mit Minus und Plus eine der angebotenen Dauern wählen und starten. Mit der Modustaste wieder zu Pomodoro zurückwechseln. Während eines laufenden Abschnitts ist der Moduswechsel gesperrt.

| Timer einstellen | Timer läuft |
| --- | --- |
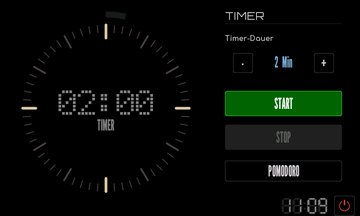
[picture p83: docs/bilder/bedienung/pomodoro-timer-klein.png]
Timer
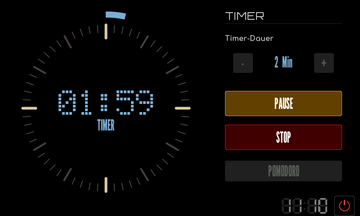
[picture p84: docs/bilder/bedienung/pomodoro-timer-laufend-klein.png]
Timer läuft
|  |  |

## Auszeit

Die Auswahl bietet sechs kurze Programme: **Bin angespannt**, **Bin müde**, **Bin zappelig**, **Augen-Pause**, **Quadratatmung** und **Atemberuhigung**. Tippe die passende Kachel an. Die jeweilige Dauer steht bereits in der Auswahl.

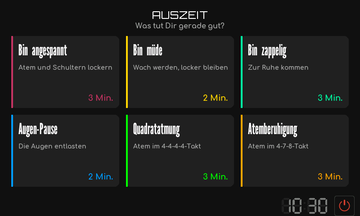
[picture p85: docs/bilder/bedienung/atempause-uebersicht-klein.png]
Auszeit auswählen


Folge den eingeblendeten Schritten beziehungsweise dem angezeigten Atemrhythmus. Unten führen **Zurück** zur Auswahl, **Pause/Weiter** zum Unterbrechen und Fortsetzen und die weitere Schritttaste zum nächsten Abschnitt. Die Taste ganz rechts verlässt die Anwendung.

| Anspannung | Müdigkeit | Unruhe |
| --- | --- | --- |
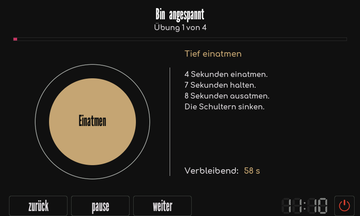
[picture p86: docs/bilder/bedienung/auszeit-angespannt-klein.png]
Anspannung
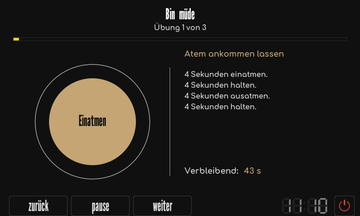
[picture p87: docs/bilder/bedienung/auszeit-muede-klein.png]
Müdigkeit
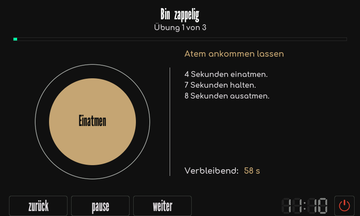
[picture p88: docs/bilder/bedienung/auszeit-zappelig-klein.png]
Unruhe
|  |  |  |

| Augen-Pause | Quadratatmung | Atemberuhigung |
| --- | --- | --- |
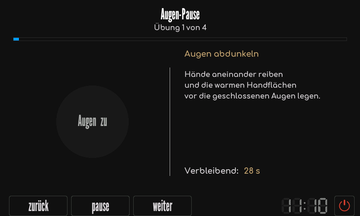
[picture p89: docs/bilder/bedienung/auszeit-augen-klein.png]
Augen-Pause
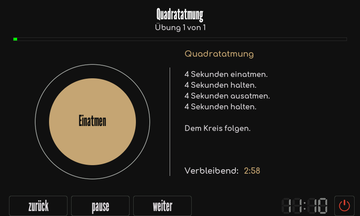
[picture p90: docs/bilder/bedienung/auszeit-quadratatmung-klein.png]
Quadratatmung
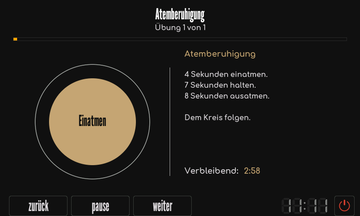
[picture p91: docs/bilder/bedienung/auszeit-atemberuhigung-klein.png]
Atemberuhigung
|  |  |  |

## Einstellungen

Links den Einstellbereich auswählen, rechts dessen Felder bearbeiten. Längere Texte werden über eine Bildschirmtastatur eingegeben, Zahlen über die angezeigten Zahlentasten. Persönliche Netzwerkangaben sind in den Beispielbildern absichtlich unscharf.

| Bereich | Bedienung | Beispiel |
| --- | --- | --- |
| WLAN | Profile einzeln aktivieren, Netze suchen, Passwort eingeben, Verbindung testen und Netzwerknamen ändern. | WLAN |
| Zeit & Zeitserver | Zeitzone, Zeitserver und Synchronisation einstellen, bei Bedarf Uhrzeit manuell setzen und die Gangart des Sekundenzeigers wählen. | Zeit |
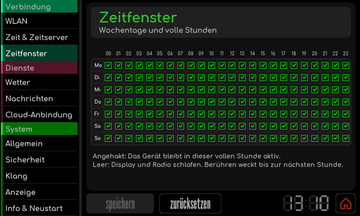
[picture p92: docs/bilder/bedienung/einstellungen-zeitfenster-klein.png]
Zeitfenster
| Zeitfenster | Betriebszeiten des Displays über die angebotene Wochenübersicht festlegen. |  |
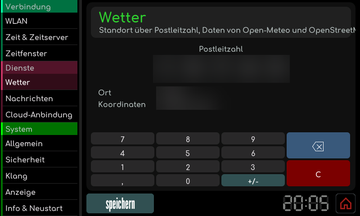
[picture p93: docs/bilder/bedienung/einstellungen-wetter-klein.png]
Wetter einstellen
| Wetter | Deutsche Postleitzahl eingeben, Ort und Koordinaten werden ermittelt. |  |
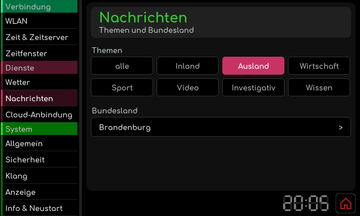
[picture p94: docs/bilder/bedienung/einstellungen-nachrichten-klein.png]
Nachrichten
| Nachrichten | Gewünschtes Nachrichtenressort für die Laufzeile auswählen. |  |
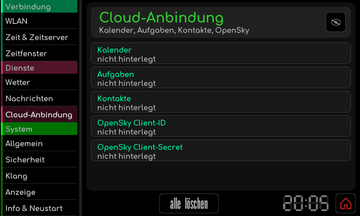
[picture p95: docs/bilder/bedienung/einstellungen-cloud-klein.png]
Cloud-Anbindung
| Cloud-Anbindung | Eigene Google-Web-App-Adressen und OpenSky-Zugang eintragen, [Dienste einrichten](dienste/README.md). |  |
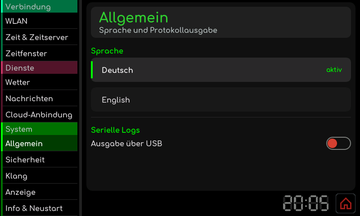
[picture p96: docs/bilder/bedienung/einstellungen-allgemein-klein.png]
Allgemein
| Allgemein | Deutsch oder Englisch auswählen und die serielle Protokollausgabe über USB ein- oder ausschalten. |  |
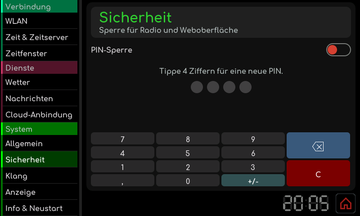
[picture p97: docs/bilder/bedienung/einstellungen-sicherheit-klein.png]
Sicherheit
| Sicherheit | PIN-Sperre für Radio und Weboberfläche ein- oder ausschalten und den vierstelligen Code ändern. |  |
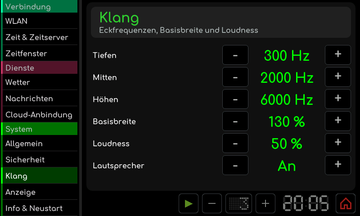
[picture p98: docs/bilder/bedienung/einstellungen-klang-klein.png]
Klang
| Klang | Lautstärke, Balance, Tiefen, Mitten, Höhen und Lautsprecherfreigabe einstellen. |  |
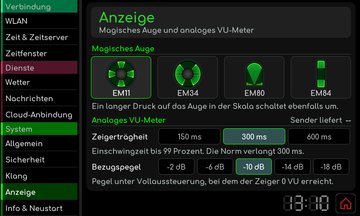
[picture p99: docs/bilder/bedienung/einstellungen-anzeige-klein.png]
Anzeige
| Anzeige | Die angebotenen Darstellungs- und Anzeigeoptionen wählen. |  |
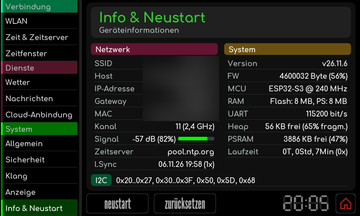
[picture p100: docs/bilder/bedienung/einstellungen-info-klein.png]
Informationen
| Info & Neustart | Netzwerk- und Geräteinformationen lesen, Neustart oder Zurücksetzen gezielt auslösen. |  |

Unter **Allgemein -> Serielle Logs** schaltet **Ausgabe über USB** die Diagnosemeldungen für den seriellen Monitor ein oder aus. Die Änderung wirkt sofort, wird automatisch gespeichert und bleibt nach einem Neustart erhalten. Ab Werk und nach dem Zurücksetzen auf Werkseinstellungen ist die Ausgabe ausgeschaltet. Die Sprachauswahl steht darüber im selben Bereich.

Unter **Klang -> Lautsprecher** schaltet Minus die beiden eingebauten Lautsprecher aus, Plus schaltet sie ein. Die Änderung wirkt sofort. **Speichern** übernimmt sie dauerhaft, beim Verwerfen wird der gespeicherte Zustand wiederhergestellt. Der Stereo-Line-Out bleibt bei abgeschalteten Lautsprechern aktiv. Diese Funktion ist unabhängig von Mute und von der gewählten Wiedergabelautstärke.

**Alle löschen** im Cloud-Bereich betrifft sämtliche dortigen Werte, einschließlich OpenSky. Für den Demomodus einzelner Google-Anwendungen nur die zugehörigen Adressen leeren. **Zurücksetzen** und **Werkseinstellungen** sind keine normalen Beenden-Tasten, sie verändern gespeicherte Einstellungen.

## Sperren und Ausschalten

Das Hauptmenü bietet den Ausschaltknopf unten rechts. QR-Code und Projektadresse im Ausschaltbildschirm führen zum [RetroRadio-Projekt auf GitHub](https://github.com/DIYLAB-DE/RetroRadio). Ab Werk ist die **PIN-Sperre** eingeschaltet, die Start-PIN lautet **`0000`**. Unter **Einstellungen -> Sicherheit** kannst Du den Code ändern oder die Sperre ausschalten. Tippe dafür auf den Schalter und gib einmal Deine aktuelle PIN ein. Das Radio öffnet beim Start und Aufwecken direkt das Hauptmenü. Auch die Weboberfläche öffnet sich ohne PIN. Der Schalter wirkt sofort. Beim Wiedereinschalten gilt wieder Deine bisherige PIN. Die Netzwerkverbindung des Geräts und die Weboberfläche sind getrennt vom sichtbaren Display zu betrachten, Details zu deren Zugriff stehen in der [Webanleitung](Weboberfläche.md).

| Gesperrt | Code eingeben |
| --- | --- |
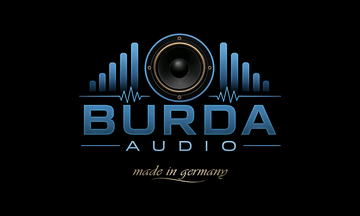
[picture p101: docs/bilder/bedienung/geraet-sperrbildschirm-klein.png]
Sperrbildschirm
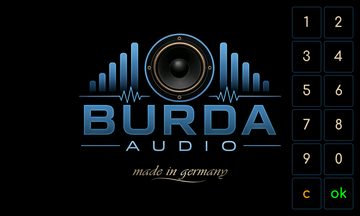
[picture p102: docs/bilder/bedienung/geraet-sperrcode-klein.png]
Sperrcode
|  |  |

Bei unerwartetem Verhalten hilft die [Fehlerhilfe](Fehlerhilfe.md). Aufbau und Firmwareauswahl stehen in der [Hardwareanleitung](Aufbau.md) und der [Erstinstallation](RetroRadio-Ersteinrichtung.md).

[RetroRadio](../README.md) > [Dokumentation](../README.md#dokumentation) > RetroRadio bedienen
