DIYLAB-DE/RetroRadio/docs/Fotogalerie.md

# Aufbaufotos

[RetroRadio](../README.md) > [Dokumentation](../README.md#dokumentation) > Aufbaufotos

Die Vorschaubilder öffnen beim Anklicken das große Foto. Hauptvariante ist Rev.2 mit Visaton BF 37, als Rev.1 bezeichnete Bilder zeigen den früheren Aufbau. Die Flashgrößen 8 und 16 MB sind davon unabhängig.

Die Originale bleiben privat erhalten. Diese Veröffentlichungskopien sind richtig ausgerichtet, auf höchstens 2400 Pixel verkleinert und ohne Standortdaten oder eingebettete Kommentare gespeichert. Sichtbare Netzwerkangaben sind unscharf gemacht. Bildinhalte wurden nicht ergänzt.

| Foto | Vorschau | Beschreibung |
| --- | --- | --- |
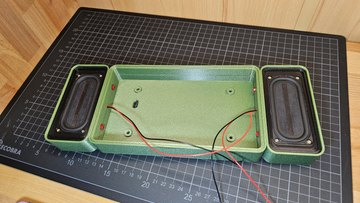
[picture p151: docs/bilder/aufbau/20260529_212016-klein.jpg]
Frühere Rev.1 mit Visaton SC 4.9 FL und 8 Ohm.
| F01 |  | Frühere Rev.1 mit Visaton SC 4.9 FL und 8 Ohm. |
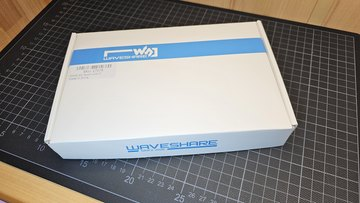
[picture p152: docs/bilder/aufbau/20260529_212156-klein.jpg]
Verpackung des Waveshare ESP32-S3-Touch-LCD-7.
| F02 |  | Verpackung des Waveshare ESP32-S3-Touch-LCD-7. |
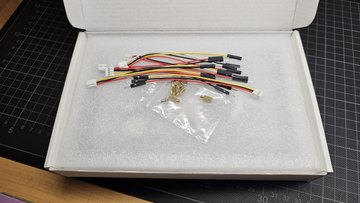
[picture p153: docs/bilder/aufbau/20260529_212209-klein.jpg]
Mitgelieferte Kabel und Abstandshalter.
| F03 |  | Mitgelieferte Kabel und Abstandshalter. |
| F04 | Displayeinheit mit Platine auf der Rückseite. | Displayeinheit mit Platine auf der Rückseite. |
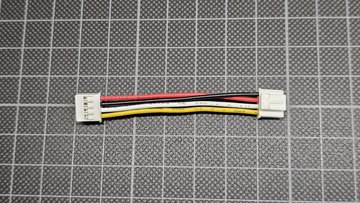
[picture p154: docs/bilder/aufbau/20260530_205745-klein.jpg]
I2C-Kabel zur RTC: Die Adern müssen wie gezeigt umgesetzt werden, damit Versorgung und Masse stimmen.
| F05 |  | I2C-Kabel zur RTC: Die Adern müssen wie gezeigt umgesetzt werden, damit Versorgung und Masse stimmen. |
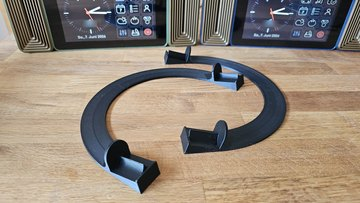
[picture p155: docs/bilder/aufbau/20260607_141526-klein.jpg]
Gedruckte Aufsteller.
| F06 |  | Gedruckte Aufsteller. |
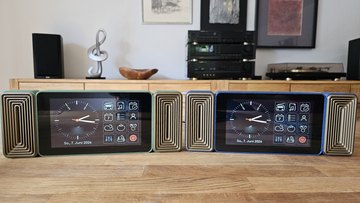
[picture p156: docs/bilder/gerät/20260607_141617-klein.jpg]
Zwei fertige RetroRadios. Beide Aufbauversionen haben dieselbe Frontansicht, fotografiert ist Rev.1.
| F07 |  | Zwei fertige RetroRadios. Beide Aufbauversionen haben dieselbe Frontansicht, fotografiert ist Rev.1. |
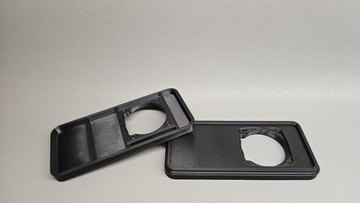
[picture p157: docs/bilder/aufbau/20260822_135305-klein.jpg]
Lautsprechereinsätze für Visaton BF 37 in Rev.2.
| F08 |  | Lautsprechereinsätze für Visaton BF 37 in Rev.2. |
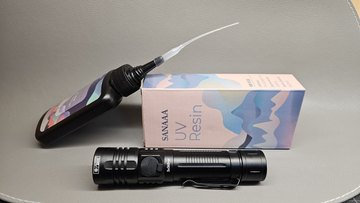
[picture p158: docs/bilder/aufbau/20260822_140909-klein.jpg]
UV-Resin und UV-Lampe für die Verklebung der Einsätze.
| F09 |  | UV-Resin und UV-Lampe für die Verklebung der Einsätze. |
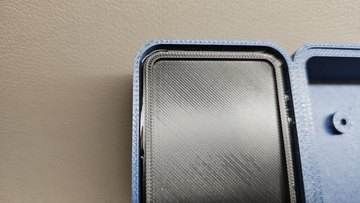
[picture p159: docs/bilder/aufbau/20260822_141135-klein.jpg]
Ausgehärtete Klebenaht am Lautsprechereinsatz.
| F10 |  | Ausgehärtete Klebenaht am Lautsprechereinsatz. |
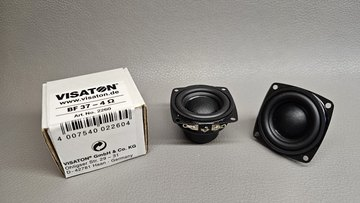
[picture p160: docs/bilder/aufbau/20260822_185122-klein.jpg]
Visaton BF 37 mit 4 Ohm für Rev.2.
| F11 |  | Visaton BF 37 mit 4 Ohm für Rev.2. |
| F12 | Sortiment mit selbstschneidenden Schrauben für die Baugruppen. | Sortiment mit selbstschneidenden Schrauben für die Baugruppen. |
| F13 | Sortiment mit metrischen Schrauben M2,5 und M3. | Sortiment mit metrischen Schrauben M2,5 und M3. |
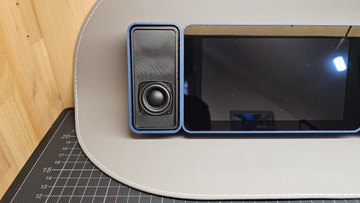
[picture p161: docs/bilder/aufbau/20260822_193828-klein.jpg]
Lautsprecher und Einsatz im Gehäuse der Rev.2.
| F14 |  | Lautsprecher und Einsatz im Gehäuse der Rev.2. |
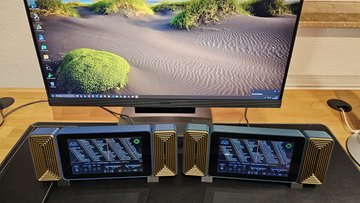
[picture p162: docs/bilder/gerät/20260822_211320-klein.jpg]
Frühere Rev.1 am Arbeitsplatz, Gehäuse aus PETG-CF.
| F15 |  | Frühere Rev.1 am Arbeitsplatz, Gehäuse aus PETG-CF. |
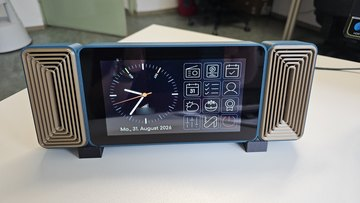
[picture p163: docs/bilder/gerät/20260831_093542-klein.jpg]
Frontansicht eines fertigen RetroRadios der Rev.1.
| F16 |  | Frontansicht eines fertigen RetroRadios der Rev.1. |
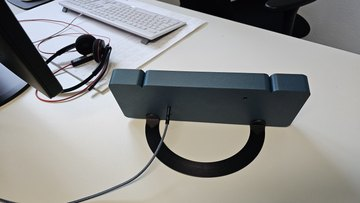
[picture p164: docs/bilder/gerät/20260831_093652-klein.jpg]
Rückansicht der früheren Rev.1 mit Aufsteller.
| F17 |  | Rückansicht der früheren Rev.1 mit Aufsteller. |
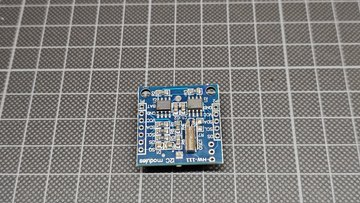
[picture p165: docs/bilder/aufbau/20260923_114835-klein.jpg]
Tiny-RTC-Modul HW-111 im Zwischenstand: D1 bereits entfernt, U3 noch bestückt.
| F18 |  | Tiny-RTC-Modul HW-111 im Zwischenstand: D1 bereits entfernt, U3 noch bestückt. |
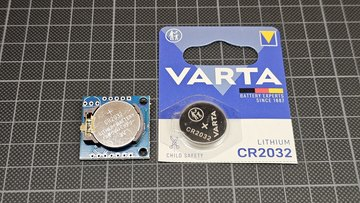
[picture p166: docs/bilder/aufbau/20260923_114943-klein.jpg]
CR2032 als Batterie für die RTC.
| F19 |  | CR2032 als Batterie für die RTC. |
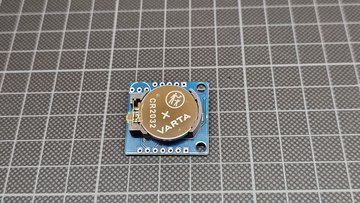
[picture p167: docs/bilder/aufbau/20260923_120530-klein.jpg]
Batterieseite der RTC mit eingesetzter CR2032.
| F20 |  | Batterieseite der RTC mit eingesetzter CR2032. |
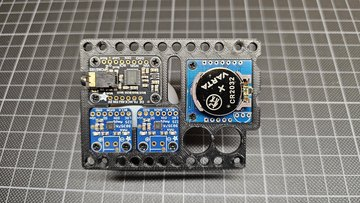
[picture p168: docs/bilder/aufbau/20260923_120917-klein.jpg]
Anordnung von DAC, zwei Verstärkern und RTC auf der Grundplatte.
| F21 |  | Anordnung von DAC, zwei Verstärkern und RTC auf der Grundplatte. |
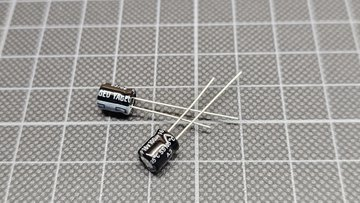
[picture p169: docs/bilder/aufbau/20260923_122918-klein.jpg]
Zwei Elkos mit 100 µF und 25 V für die Verstärkerversorgung.
| F22 |  | Zwei Elkos mit 100 µF und 25 V für die Verstärkerversorgung. |
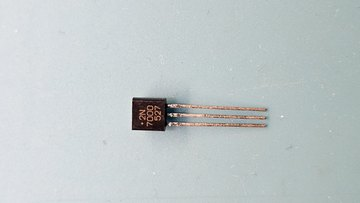
[picture p170: docs/bilder/aufbau/20260923_135827-klein.jpg]
2N7000 als fotografierte Variante der Lautsprecherabschaltung.
| F23 |  | 2N7000 als fotografierte Variante der Lautsprecherabschaltung. |
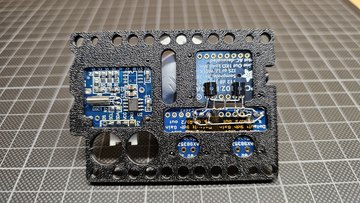
[picture p171: docs/bilder/aufbau/20260923_143153-klein.jpg]
Eingebaute FETs der Variante mit 2N7000.
| F24 |  | Eingebaute FETs der Variante mit 2N7000. |
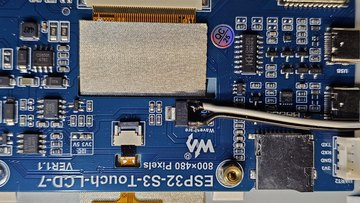
[picture p172: docs/bilder/aufbau/20260923_191638-klein.jpg]
Abgriff der 5-V-Versorgung am Spannungsregler der Displayplatine.
| F25 |  | Abgriff der 5-V-Versorgung am Spannungsregler der Displayplatine. |
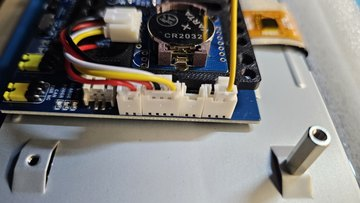
[picture p173: docs/bilder/aufbau/20260924_121947-klein.jpg]
Rechte Steckverbinder am bestückten Display.
| F26 |  | Rechte Steckverbinder am bestückten Display. |
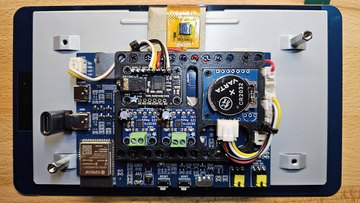
[picture p174: docs/bilder/aufbau/20260925_202741-klein.jpg]
Vollständige Verdrahtung der Rev.2.
| F27 |  | Vollständige Verdrahtung der Rev.2. |
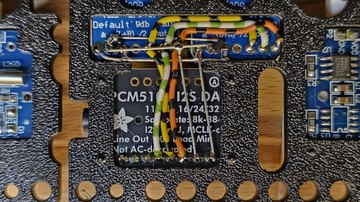
[picture p175: docs/bilder/aufbau/20260929_124701-klein.jpg]
Ausführung der Lautsprecherabschaltung mit AO3400.
| F28 |  | Ausführung der Lautsprecherabschaltung mit AO3400. |
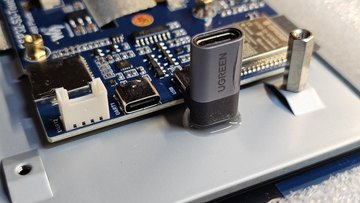
[picture p176: docs/bilder/aufbau/20261001_193314-klein.jpg]
USB-C-Adapter mit Abstützung aus UV-Resin.
| F29 |  | USB-C-Adapter mit Abstützung aus UV-Resin. |
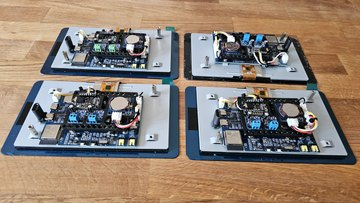
[picture p177: docs/bilder/aufbau/20261003_133322-klein.jpg]
Vier bestückte Displayeinheiten der Rev.2.
| F30 |  | Vier bestückte Displayeinheiten der Rev.2. |
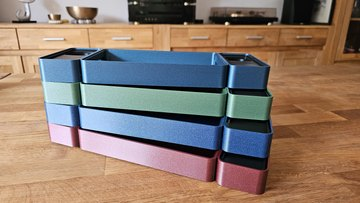
[picture p178: docs/bilder/aufbau/20261003_133907-klein.jpg]
Gehäusevarianten der Rev.2 von der Seite.
| F31 |  | Gehäusevarianten der Rev.2 von der Seite. |
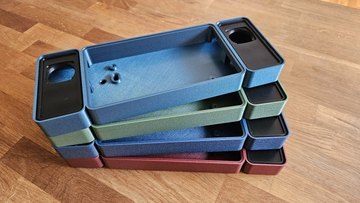
[picture p179: docs/bilder/aufbau/20261003_134104-klein.jpg]
Gehäusevarianten der Rev.2 von oben.
| F32 |  | Gehäusevarianten der Rev.2 von oben. |
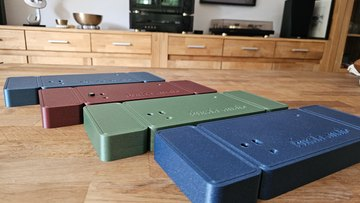
[picture p180: docs/bilder/aufbau/20261003_134301-klein.jpg]
Gehäusevarianten der Rev.2 von hinten.
| F33 |  | Gehäusevarianten der Rev.2 von hinten. |
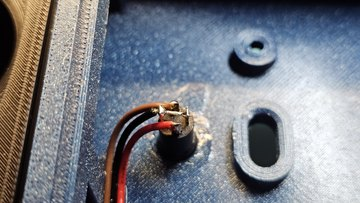
[picture p181: docs/bilder/aufbau/20261007_200803-klein.jpg]
Herausgeführte 3,5-mm-Buchse für den Line-Out.
| F34 |  | Herausgeführte 3,5-mm-Buchse für den Line-Out. |
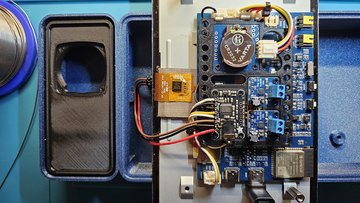
[picture p182: docs/bilder/aufbau/20261007_202331-klein.jpg]
Verdrahtung der Line-Out-Buchse im offenen Aufbau.
| F35 |  | Verdrahtung der Line-Out-Buchse im offenen Aufbau. |
| F36 | Befestigungsbolzen: links original, rechts gekürzte Außengewinde. Die Bolzenkörper bleiben 4 mm beziehungsweise 15 mm lang. | Befestigungsbolzen: links original, rechts gekürzte Außengewinde. Die Bolzenkörper bleiben 4 mm beziehungsweise 15 mm lang. |

[RetroRadio](../README.md) > [Dokumentation](../README.md#dokumentation) > Aufbaufotos
