DIYLAB-DE/RetroRadio/docs/werkstatt/ascii-table.md

# ASCII-Tabelle

[RetroRadio](../../README.md) > [Dokumentation](../../README.md#dokumentation) > [Werkstatt](README.md) > [Digital](README.md#digital) > ASCII-Tabelle

Tippe ein Zeichen an. Die Detailanzeige zeigt seine Zahlenwerte in Dezimal-, Hexadezimal-, Oktal- und Binärdarstellung. Zwischen dem Grundbereich und dem erweiterten Bereich 128 bis 255 wechseln. Die erweiterten Zeichen gehören zur dargestellten Zeichentabelle und sind keine allgemeine Unicode-Liste.

ASCII-Tabelle

**Erweiterte Zeichentabelle**

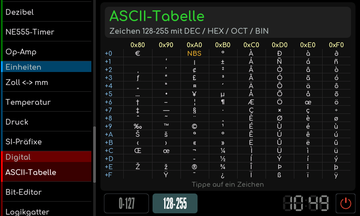
[picture p183: docs/bilder/werkstatt/werkstatt-ascii-table-erweitert-klein.png]
Erweiterte Zeichentabelle


**Zeichendetails**

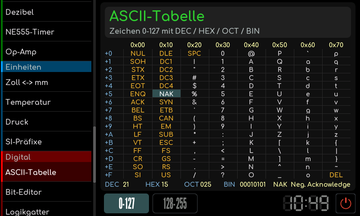
[picture p184: docs/bilder/werkstatt/werkstatt-ascii-table-zeichen-klein.png]
Zeichendetails


[RetroRadio](../../README.md) > [Dokumentation](../../README.md#dokumentation) > [Werkstatt](README.md) > [Digital](README.md#digital) > ASCII-Tabelle
