DIYLAB-DE/RetroRadio/docs/werkstatt/bit-editor.md

# Bit-Editor

[RetroRadio](../../README.md) > [Dokumentation](../../README.md#dokumentation) > [Werkstatt](README.md) > [Digital](README.md#digital) > Bit-Editor

Wähle 8, 16 oder 32 Bit. Tippe einzelne Bits an, um sie umzuschalten, und beobachte die zugehörigen Zahlendarstellungen. Das Werkzeug eignet sich zum Zusammensetzen und Prüfen von Bitmustern. Die gewählte Breite bestimmt, wie viele Bitpositionen angezeigt werden.

Bit-Editor

**16-Bit-Darstellung**

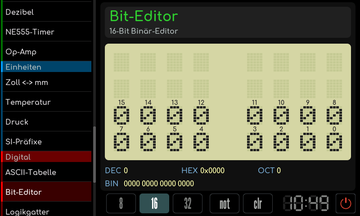
[picture p185: docs/bilder/werkstatt/werkstatt-bit-editor-16-bit-klein.png]
16-Bit-Darstellung


**32-Bit-Darstellung**

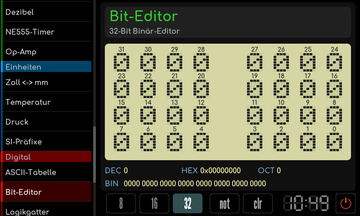
[picture p186: docs/bilder/werkstatt/werkstatt-bit-editor-32-bit-klein.png]
32-Bit-Darstellung


**Invertiertes Bitmuster**

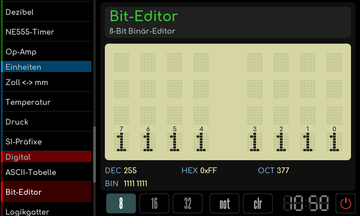
[picture p187: docs/bilder/werkstatt/werkstatt-bit-editor-invertiert-klein.png]
Invertiertes Bitmuster


[RetroRadio](../../README.md) > [Dokumentation](../../README.md#dokumentation) > [Werkstatt](README.md) > [Digital](README.md#digital) > Bit-Editor
