DIYLAB-DE/RetroRadio/docs/werkstatt/calculator.md

# Rechner

[RetroRadio](../../README.md) > [Dokumentation](../../README.md#dokumentation) > [Werkstatt](README.md) > [Werkzeuge](README.md#werkzeuge) > Rechner

Der Taschenrechner zeigt Dezimal-, Hexadezimal- und Binärdarstellung gleichzeitig. Gib den Ausdruck über die Bildschirmtasten ein und bestätige mit =. C löscht die Eingabe, die Rücktaste entfernt das letzte Zeichen. Klammern, Vorzeichen, Quadrat, Wurzel, Potenz und Prozent stehen direkt auf der Tastatur. Die Binäranzeige arbeitet mit 16 Bit.

Rechner

[RetroRadio](../../README.md) > [Dokumentation](../../README.md#dokumentation) > [Werkstatt](README.md) > [Werkzeuge](README.md#werkzeuge) > Rechner
