DIYLAB-DE/RetroRadio/docs/werkstatt/circle-of-fifths.md

# Quintenzirkel

[RetroRadio](../../README.md) > [Dokumentation](../../README.md#dokumentation) > [Werkstatt](README.md) > [Musik](README.md#musik) > Quintenzirkel

Wähle eine Tonart am Kreis. Die Anzeige zeigt Vorzeichen, Tonleiter und Stufenharmonik der gewählten Dur-Tonart. Tonika, Subdominante, Dominante und Tonikaparallele sind zugeordnet. So lassen sich benachbarte Tonarten und ihre Vorzeichen vergleichen.

Quintenzirkel

**G-Dur**

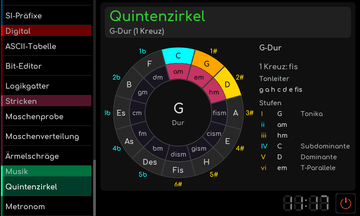
[picture p188: docs/bilder/werkstatt/werkstatt-circle-of-fifths-tonart-klein.png]
G-Dur


[RetroRadio](../../README.md) > [Dokumentation](../../README.md#dokumentation) > [Werkstatt](README.md) > [Musik](README.md#musik) > Quintenzirkel
