DIYLAB-DE/RetroRadio/docs/werkstatt/color-converter.md

# Farb-Konverter

[RetroRadio](../../README.md) > [Dokumentation](../../README.md#dokumentation) > [Werkstatt](README.md) > [Werkzeuge](README.md#werkzeuge) > Farb-Konverter

Wähle ein Eingabefeld und gib den Farbwert ein. Das Werkzeug rechnet zwischen RGB, HEX und dem 16-Bit-Displayformat RGB565 um und zeigt die Farbe als Fläche. Das angezeigte Display-RGB berücksichtigt die RGB565-Quantisierung, deshalb muss es nicht mit jedem ursprünglichen RGB-Kanalwert identisch sein.

Farb-Konverter

[RetroRadio](../../README.md) > [Dokumentation](../../README.md#dokumentation) > [Werkstatt](README.md) > [Werkzeuge](README.md#werkzeuge) > Farb-Konverter
