DIYLAB-DE/RetroRadio/docs/werkstatt/decibel-calculator.md

# Dezibel

[RetroRadio](../../README.md) > [Dokumentation](../../README.md#dokumentation) > [Werkstatt](README.md) > [Elektronik](README.md#elektronik) > Dezibel

Die beiden Bereiche rechnen Spannungs- und Leistungsverhältnisse getrennt. Gib die bekannten Eingangs-, Ausgangs- oder Pegelwerte in den passenden Bereich ein. Die Anzeige führt Verhältnis und dB-Wert zusammen. Spannungs- und Leistungsverhältnis verwenden unterschiedliche logarithmische Faktoren.

Dezibel

[RetroRadio](../../README.md) > [Dokumentation](../../README.md#dokumentation) > [Werkstatt](README.md) > [Elektronik](README.md#elektronik) > Dezibel
