DIYLAB-DE/RetroRadio/docs/werkstatt/dice.md

# Würfel

[RetroRadio](../../README.md) > [Dokumentation](../../README.md#dokumentation) > [Werkstatt](README.md) > [Spiele](README.md#spiele) > Würfel

Tippe auf den Würfel, um zu werfen. Die Tasten unten wechseln zwischen einem und zwei Würfeln. Bei zwei Würfeln zeigt die Ergebniskarte auch die Summe. Rechts stehen die letzten zehn Würfe. Die Historie wird nicht gespeichert. Die Hilfe lässt sich über die entsprechende Taste öffnen.

Würfel

[RetroRadio](../../README.md) > [Dokumentation](../../README.md#dokumentation) > [Werkstatt](README.md) > [Spiele](README.md#spiele) > Würfel
