DIYLAB-DE/RetroRadio/docs/werkstatt/flight-radar.md

# Flugradar

[RetroRadio](../../README.md) > [Dokumentation](../../README.md#dokumentation) > [Werkstatt](README.md) > [Werkzeuge](README.md#werkzeuge) > Flugradar

Das Radar zeigt Flugzeuge im Umkreis des eingestellten Wetterstandorts. Unten den Suchradius wählen. Die Ringtaste wechselt zwischen Kennung mit Höhe und Tempo, nur Kennung und nur Symbol. Ein Tipp auf eine Zeile der Flugzeugliste öffnet die Details. Der Balken am rechten Rand zeigt die Zeit bis zum nächsten Abruf. Standort und OpenSky-Zugang werden in den [Dienste-Einstellungen](../dienste/Flugradar.md) eingerichtet.

Flugradar

**Flugzeugdetails**

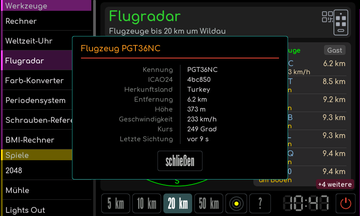
[picture p189: docs/bilder/werkstatt/werkstatt-flight-radar-details-klein.png]
Flugzeugdetails


**Nur Kennungen**

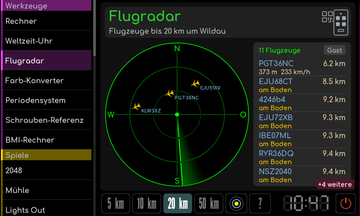
[picture p190: docs/bilder/werkstatt/werkstatt-flight-radar-nur-kennung-klein.png]
Nur Kennungen


**Nur Flugzeugsymbole**

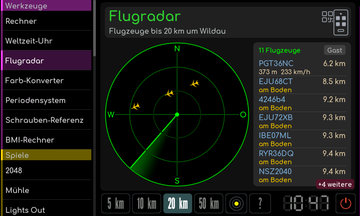
[picture p191: docs/bilder/werkstatt/werkstatt-flight-radar-symbole-klein.png]
Nur Flugzeugsymbole


[RetroRadio](../../README.md) > [Dokumentation](../../README.md#dokumentation) > [Werkstatt](README.md) > [Werkzeuge](README.md#werkzeuge) > Flugradar
