DIYLAB-DE/RetroRadio/docs/werkstatt/lights-out.md

# Lights Out

[RetroRadio](../../README.md) > [Dokumentation](../../README.md#dokumentation) > [Werkstatt](README.md) > [Spiele](README.md#spiele) > Lights Out

Schalte alle 25 Lichter aus. Ein Tipp schaltet das gewählte Feld und seine direkten Nachbarn um, diagonale Nachbarn bleiben unverändert. Leicht, mittel und schwer wählen die Zahl der Mischschritte. Neu startet ein neues lösbares Brett. Züge und Zeit werden angezeigt, gelöste Partien und Bestzeiten je Stufe gespeichert. Reset fragt vor dem Löschen der Statistik nach.

Lights Out

[RetroRadio](../../README.md) > [Dokumentation](../../README.md#dokumentation) > [Werkstatt](README.md) > [Spiele](README.md#spiele) > Lights Out
