DIYLAB-DE/RetroRadio/docs/werkstatt/logic-gate-sim.md

# Logikgatter

[RetroRadio](../../README.md) > [Dokumentation](../../README.md#dokumentation) > [Werkstatt](README.md) > [Digital](README.md#digital) > Logikgatter

Wähle AND, OR, XOR, NAND, NOR oder NOT und schalte die Eingänge um. Das Gatterbild und der Ausgang zeigen das Ergebnis. Die Wahrheitstabelle ordnet die möglichen Eingangskombinationen zu. NOT besitzt nur einen Eingang.

Logikgatter

**AND**

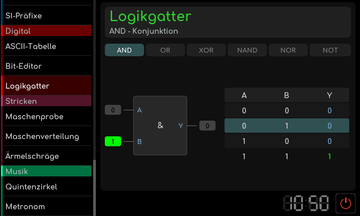
[picture p192: docs/bilder/werkstatt/werkstatt-logic-gate-sim-and-klein.png]
AND


**NAND**

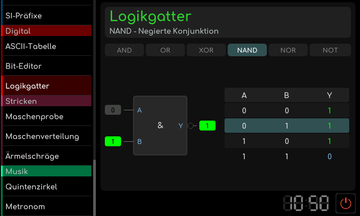
[picture p193: docs/bilder/werkstatt/werkstatt-logic-gate-sim-nand-klein.png]
NAND


**NOR**

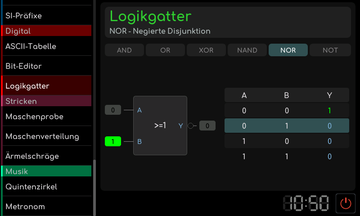
[picture p194: docs/bilder/werkstatt/werkstatt-logic-gate-sim-nor-klein.png]
NOR


**NOT**

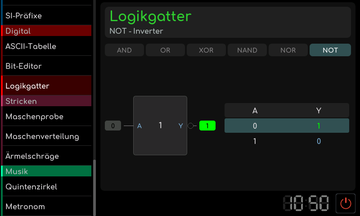
[picture p195: docs/bilder/werkstatt/werkstatt-logic-gate-sim-not-klein.png]
NOT


**OR**

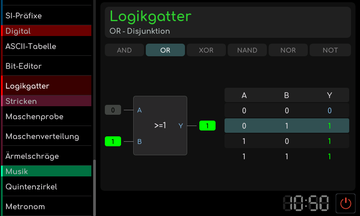
[picture p196: docs/bilder/werkstatt/werkstatt-logic-gate-sim-or-klein.png]
OR


**XOR**

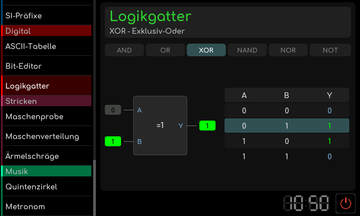
[picture p197: docs/bilder/werkstatt/werkstatt-logic-gate-sim-xor-klein.png]
XOR


[RetroRadio](../../README.md) > [Dokumentation](../../README.md#dokumentation) > [Werkstatt](README.md) > [Digital](README.md#digital) > Logikgatter
