DIYLAB-DE/RetroRadio/docs/werkstatt/metronome.md

# Metronom

[RetroRadio](../../README.md) > [Dokumentation](../../README.md#dokumentation) > [Werkstatt](README.md) > [Musik](README.md#musik) > Metronom

Mit - und + das Tempo ändern oder mit tap mehrfach im gewünschten Tempo tippen. Die Taktwahl wechselt zwischen 2/4, 3/4, 4/4 und 6/8. Start beziehungsweise Stop schaltet den Lauf um, auch ein Tipp auf die große Anzeige startet und stoppt. Die Punkte zeigen die Schläge, der erste Schlag ist hervorgehoben. In der Mitte stehen Tempo und italienische Tempobezeichnung.

Metronom

**Laufendes Metronom**

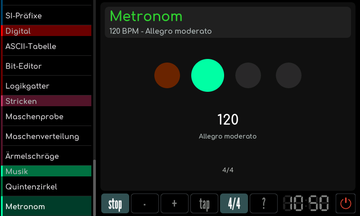
[picture p198: docs/bilder/werkstatt/werkstatt-metronome-laufend-klein.png]
Laufendes Metronom


**Taktart 6/8**

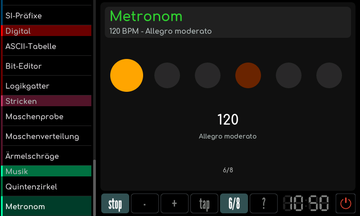
[picture p199: docs/bilder/werkstatt/werkstatt-metronome-weiterer-takt-klein.png]
Taktart 6/8


[RetroRadio](../../README.md) > [Dokumentation](../../README.md#dokumentation) > [Werkstatt](README.md) > [Musik](README.md#musik) > Metronom
