DIYLAB-DE/RetroRadio/docs/werkstatt/opamp-calculator.md

# Op-Amp

[RetroRadio](../../README.md) > [Dokumentation](../../README.md#dokumentation) > [Werkstatt](README.md) > [Elektronik](README.md#elektronik) > Op-Amp

Wähle invertierend oder nicht invertierend. Bearbeite die Eingangs- und Rückkopplungswerte in den angezeigten Feldern. Schaltskizze und Ergebnis passen sich dem Modus an. Die Rechnung beschreibt die angezeigte ideale Verstärkerschaltung, tatsächliche Ausgangsgrenzen hängen vom eingesetzten Operationsverstärker und seiner Versorgung ab.

Op-Amp

**Nicht invertierender Verstärker**

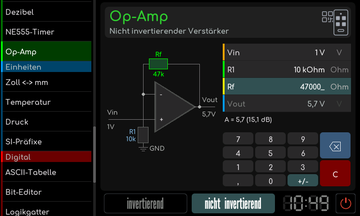
[picture p200: docs/bilder/werkstatt/werkstatt-opamp-calculator-nicht-invertierend-klein.png]
Nicht invertierender Verstärker


[RetroRadio](../../README.md) > [Dokumentation](../../README.md#dokumentation) > [Werkstatt](README.md) > [Elektronik](README.md#elektronik) > Op-Amp
