DIYLAB-DE/RetroRadio/docs/werkstatt/periodic-table.md

# Periodensystem

[RetroRadio](../../README.md) > [Dokumentation](../../README.md#dokumentation) > [Werkstatt](README.md) > [Werkzeuge](README.md#werkzeuge) > Periodensystem

Die Übersicht ordnet die chemischen Elemente nach Gruppen und Perioden. Tippe ein Element an, um dessen Detailkarte mit Atommasse, Kategorie, Zustand und Angaben zur Entdeckung zu öffnen. Die Farben unterscheiden die Elementgruppen. Schließe die Detailkarte, um zur Tabelle zurückzukehren.

Periodensystem

**Elementdetails**

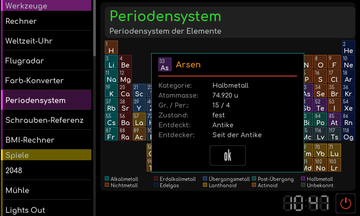
[picture p201: docs/bilder/werkstatt/werkstatt-periodic-table-element-klein.png]
Elementdetails


[RetroRadio](../../README.md) > [Dokumentation](../../README.md#dokumentation) > [Werkstatt](README.md) > [Werkzeuge](README.md#werkzeuge) > Periodensystem
