DIYLAB-DE/RetroRadio/docs/werkstatt/shut-the-box.md

# Shut the Box

[RetroRadio](../../README.md) > [Dokumentation](../../README.md#dokumentation) > [Werkstatt](README.md) > [Spiele](README.md#spiele) > Shut the Box

Würfle durch Antippen der Wurfkarte oder der Wurf-Taste. Wähle offene Zahlen, deren Summe dem Wurf entspricht, und bestätige mit legen. Sobald 7, 8 und 9 geschlossen sind, kannst Du vor dem nächsten Wurf zwischen einem und zwei Würfeln wählen. Wenn keine Kombination passt, endet die Runde. Je kleiner die Restsumme, desto besser, alle geschlossenen Klappen ergeben einen Sieg.

Shut the Box

[RetroRadio](../../README.md) > [Dokumentation](../../README.md#dokumentation) > [Werkstatt](README.md) > [Spiele](README.md#spiele) > Shut the Box
