DIYLAB-DE/RetroRadio/docs/werkstatt/si-prefixes.md

# SI-Präfixe

[RetroRadio](../../README.md) > [Dokumentation](../../README.md#dokumentation) > [Werkstatt](README.md) > [Einheiten](README.md#einheiten) > SI-Präfixe

Die Tabelle zeigt Vorsatz, Symbol, Zehnerpotenz und Beispiel. Tippe eine Zeile für den zugehörigen Umrechnungshinweis an. Die im Werkzeug enthaltene Auswahl reicht von Tera bis Piko. Groß- und Kleinschreibung der Symbole unterscheiden, etwa M für Mega und m für Milli.

SI-Präfixe

**Umrechnungshinweis**

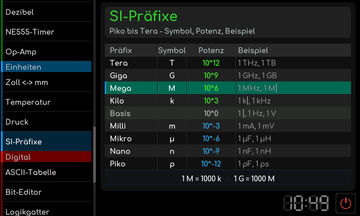
[picture p202: docs/bilder/werkstatt/werkstatt-si-prefixes-umrechnung-klein.png]
Umrechnungshinweis


[RetroRadio](../../README.md) > [Dokumentation](../../README.md#dokumentation) > [Werkstatt](README.md) > [Einheiten](README.md#einheiten) > SI-Präfixe
