DIYLAB-DE/RetroRadio/docs/werkstatt/stitch-gauge.md

# Maschenprobe

[RetroRadio](../../README.md) > [Dokumentation](../../README.md#dokumentation) > [Werkstatt](README.md) > [Stricken](README.md#stricken) > Maschenprobe

Gib Maschen beziehungsweise Reihen je 10 cm und die gewünschte Breite beziehungsweise Höhe ein. Das Werkzeug berechnet die benötigte Maschen- und Reihenzahl und stellt den Zusammenhang grafisch dar. Verwende die Werte Deiner tatsächlich gestrickten Maschenprobe.

Maschenprobe

[RetroRadio](../../README.md) > [Dokumentation](../../README.md#dokumentation) > [Werkstatt](README.md) > [Stricken](README.md#stricken) > Maschenprobe
