DIYLAB-DE/RetroRadio/docs/hardware/pläne/RetroRadio-PCM5102A-Alternative.png

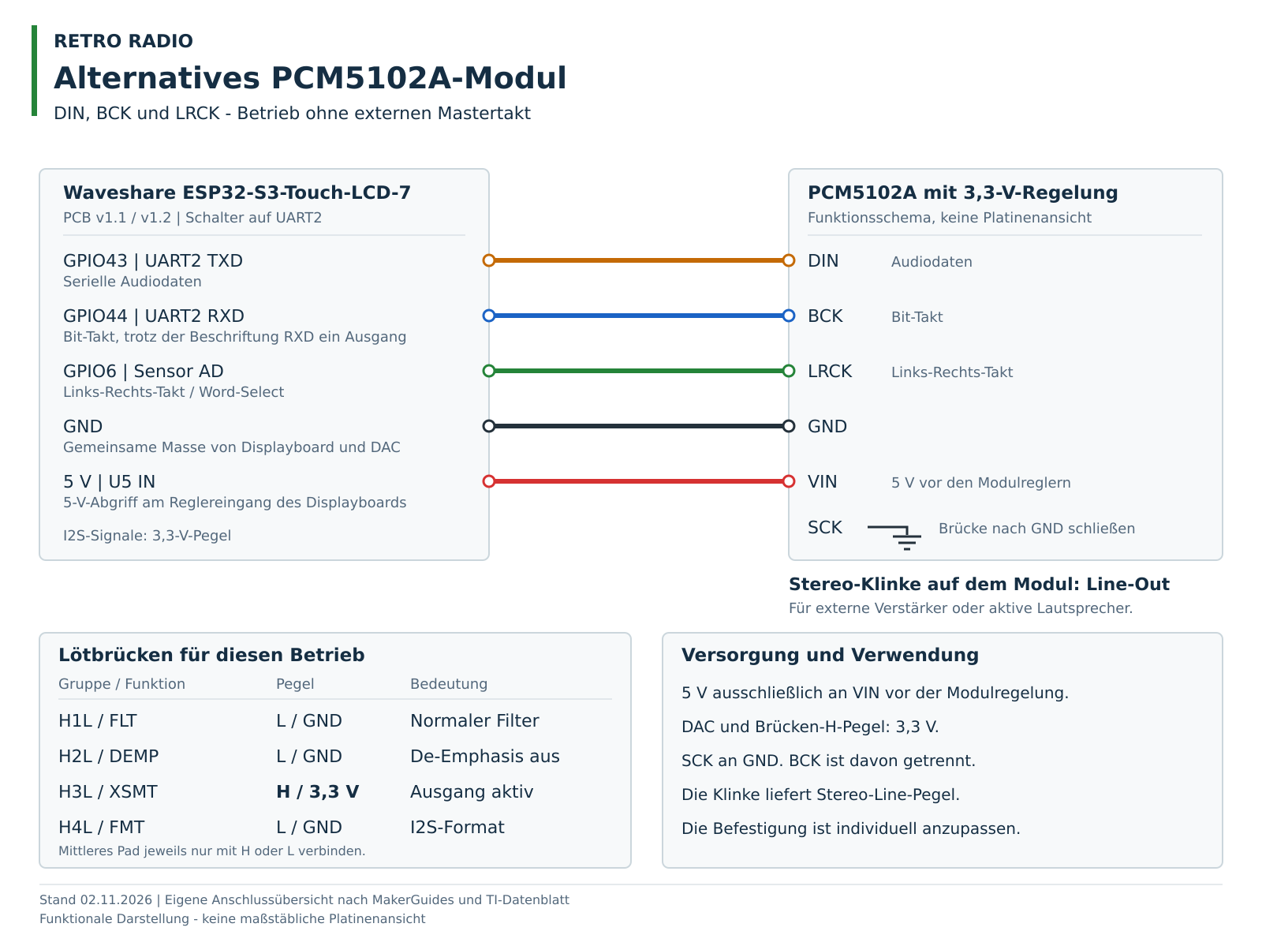
docs/hardware/pläne/RetroRadio-PCM5102A-Alternative.png
