DIYLAB-DE/RetroRadio/docs/hardware/3d-druck/H2C_PETG_Speaker_Grille.3mf

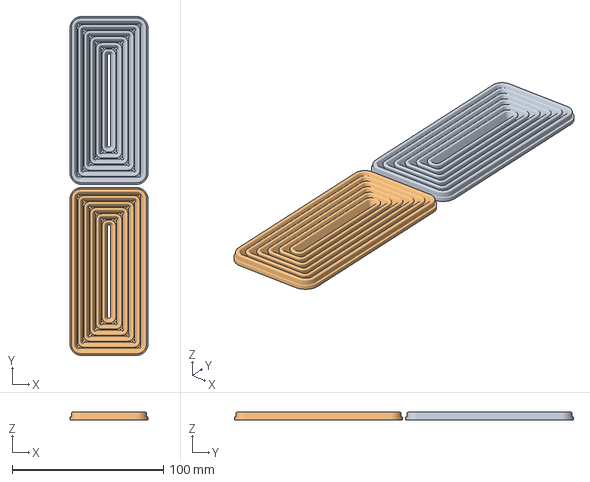
[picture p204: CAD file, 2026-10-29]
docs/hardware/3d-druck/H2C_PETG_Speaker_Grille.3mf
51.8 x 223.9 x 5.00 mm
Importiert__01 2
Importiert__01 5
