DIYLAB-DE/RetroRadio/docs/hardware/cad/H2C_PETG_Speaker_Mounting_Insert_SC_49_20FL.step

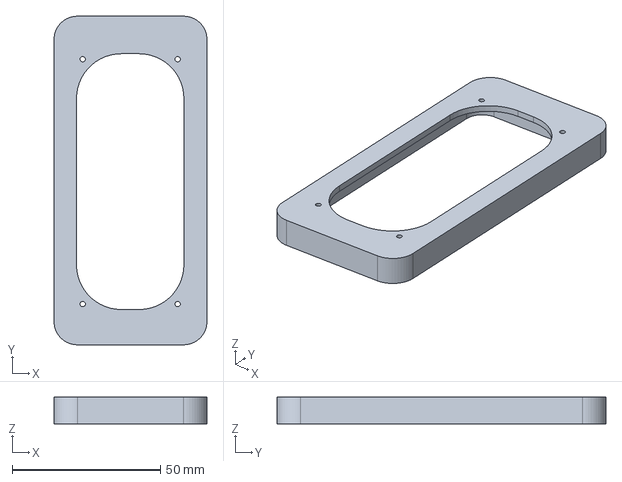
[picture p205: CAD file, 2026-10-29]
docs/hardware/cad/H2C_PETG_Speaker_Mounting_Insert_SC_49_20FL.step
51.6 x 110.8 x 9.00 mm
