DIYLAB-DE/RetroRadio/docs/hardware/3d-druck/H2C_PETG_Stand.3mf

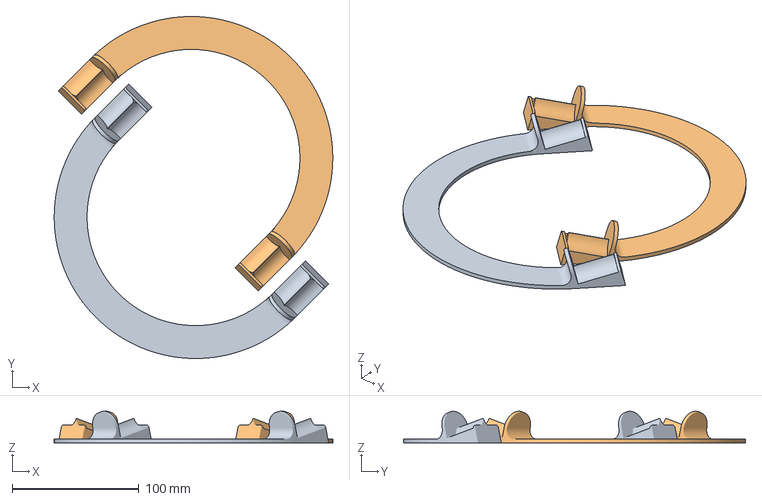
[picture p206: CAD file, 2026-10-29]
docs/hardware/3d-druck/H2C_PETG_Stand.3mf
219.7 x 269.8 x 24.9 mm
St_nder x 2
