DIYLAB-DE/RetroRadio/docs/hardware/cad/H2C_PETG_Speaker_Grille.step

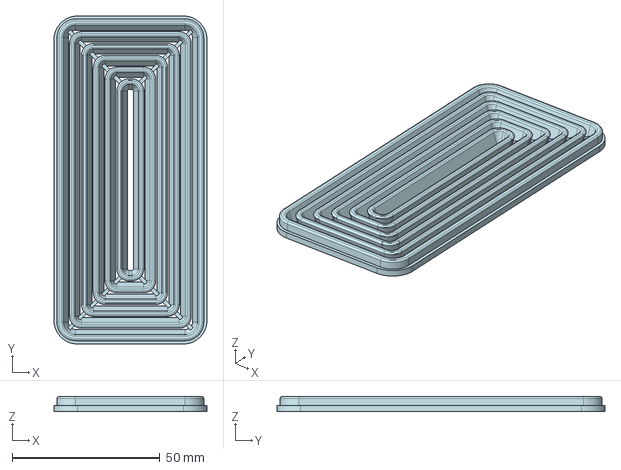
[picture p207: CAD file, 2026-10-29]
docs/hardware/cad/H2C_PETG_Speaker_Grille.step
51.8 x 111.0 x 5.00 mm
