DIYLAB-DE/RetroRadio/docs/hardware/3d-druck/H2C_PETG_Case.3mf

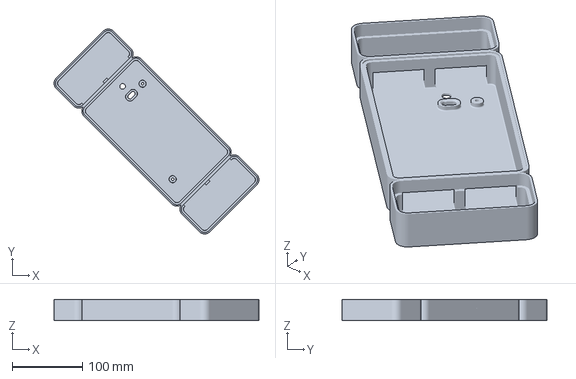
[picture p208: CAD file, 2026-10-29]
docs/hardware/3d-druck/H2C_PETG_Case.3mf
291.3 x 291.3 x 30.4 mm
