DIYLAB-DE/RetroRadio/docs/hardware/cad/H2C_PETG_Case.step

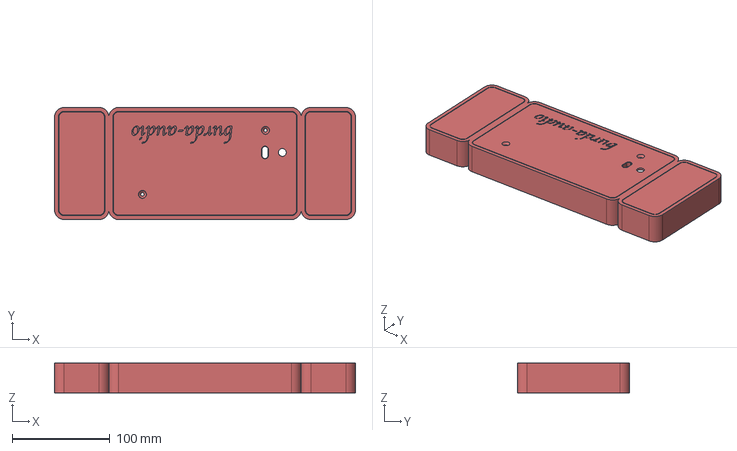
[picture p209: CAD file, 2026-10-29]
docs/hardware/cad/H2C_PETG_Case.step
308.7 x 115.0 x 30.4 mm
