DIYLAB-DE/RetroRadio/docs/hardware/3d-druck/H2C_PETG_Speaker_Mounting_Insert_SC_49_20FL.3mf

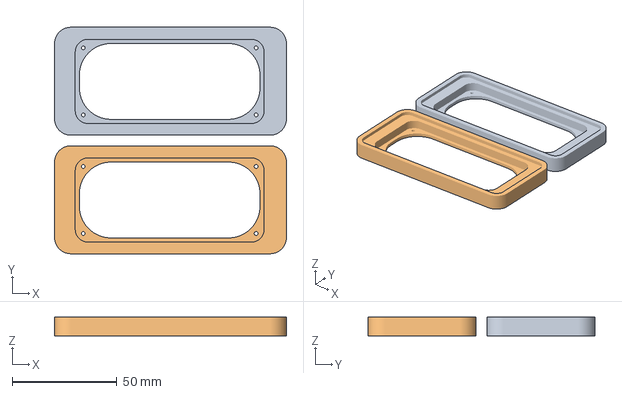
[picture p210: CAD file, 2026-10-29]
docs/hardware/3d-druck/H2C_PETG_Speaker_Mounting_Insert_SC_49_20FL.3mf
110.8 x 108.2 x 9.00 mm
Laustprecher_Einsatz_rechts x 2
