DIYLAB-DE/RetroRadio/docs/hardware/cad/H2C_PETG_Stand.step

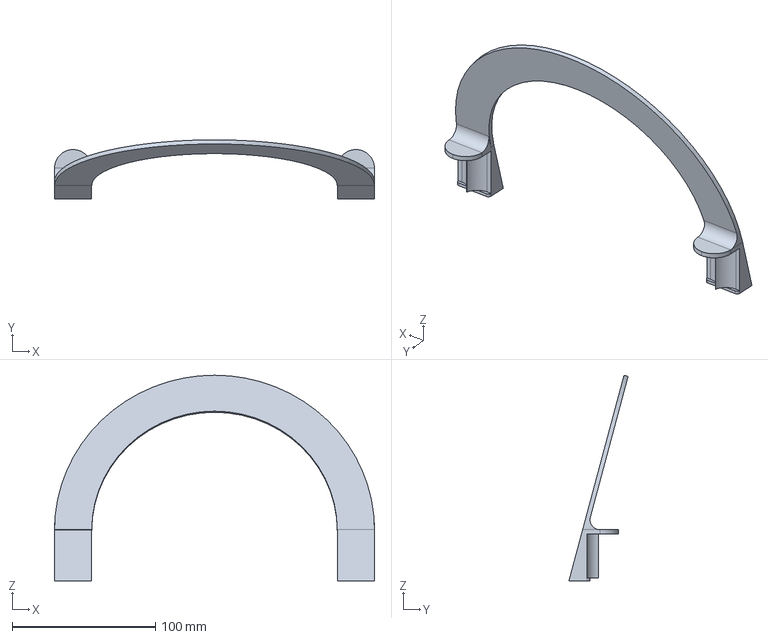
[picture p211: CAD file, 2026-10-29]
docs/hardware/cad/H2C_PETG_Stand.step
223.1 x 41.3 x 143.4 mm
