DIYLAB-DE/RetroRadio/docs/hardware/3d-druck/H2C_PETG_Speaker_Mounting_Insert_BF37.3mf

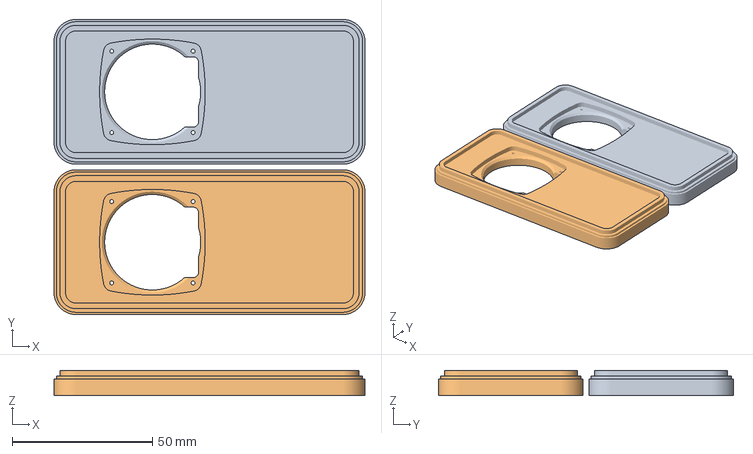
[picture p212: CAD file, 2026-10-29]
docs/hardware/3d-druck/H2C_PETG_Speaker_Mounting_Insert_BF37.3mf
110.8 x 105.1 x 9.00 mm
Lautsprecher_Einsatz_BF37 x 2
