DIYLAB-DE/RetroRadio/docs/hardware/3d-druck/H2C_PETG_Base_Plate.3mf

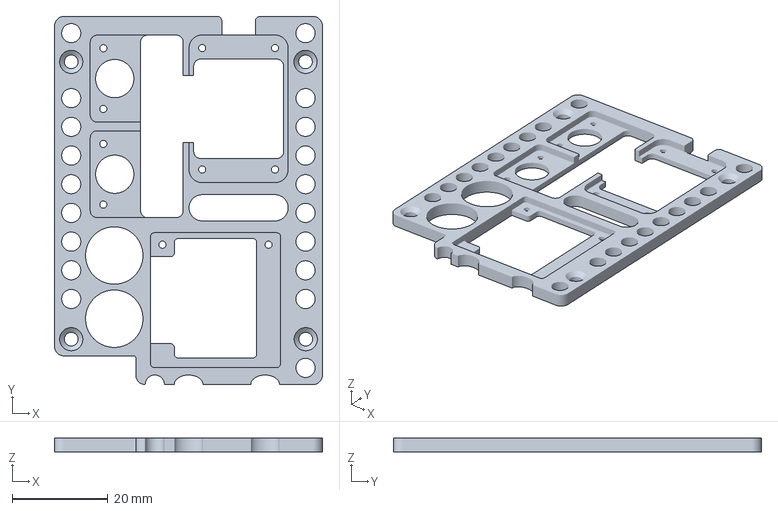
[picture p214: CAD file, 2026-10-29]
docs/hardware/3d-druck/H2C_PETG_Base_Plate.3mf
56.0 x 77.0 x 3.00 mm
