DIYLAB-DE/RetroRadio/(list of files, cad)

Other CAD files:
docs/hardware/cad/H2C_PETG_Base_Plate.step
