DIYLAB-DE/RetroRadio/docs/bilder/aufbau/20260923_114835.jpg

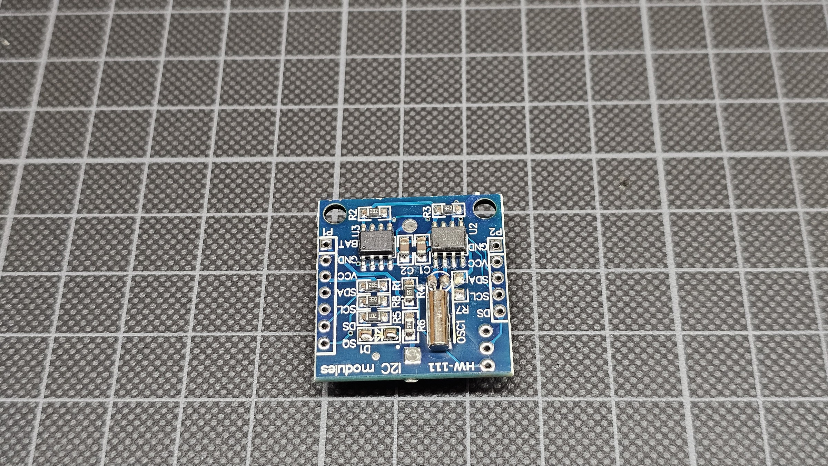
docs/bilder/aufbau/20260923_114835.jpg
