DIYLAB-DE/RetroRadio/docs/hardware/pläne/RetroRadio-Verdrahtungsplan.pdf

# Verdrahtung im Überblick

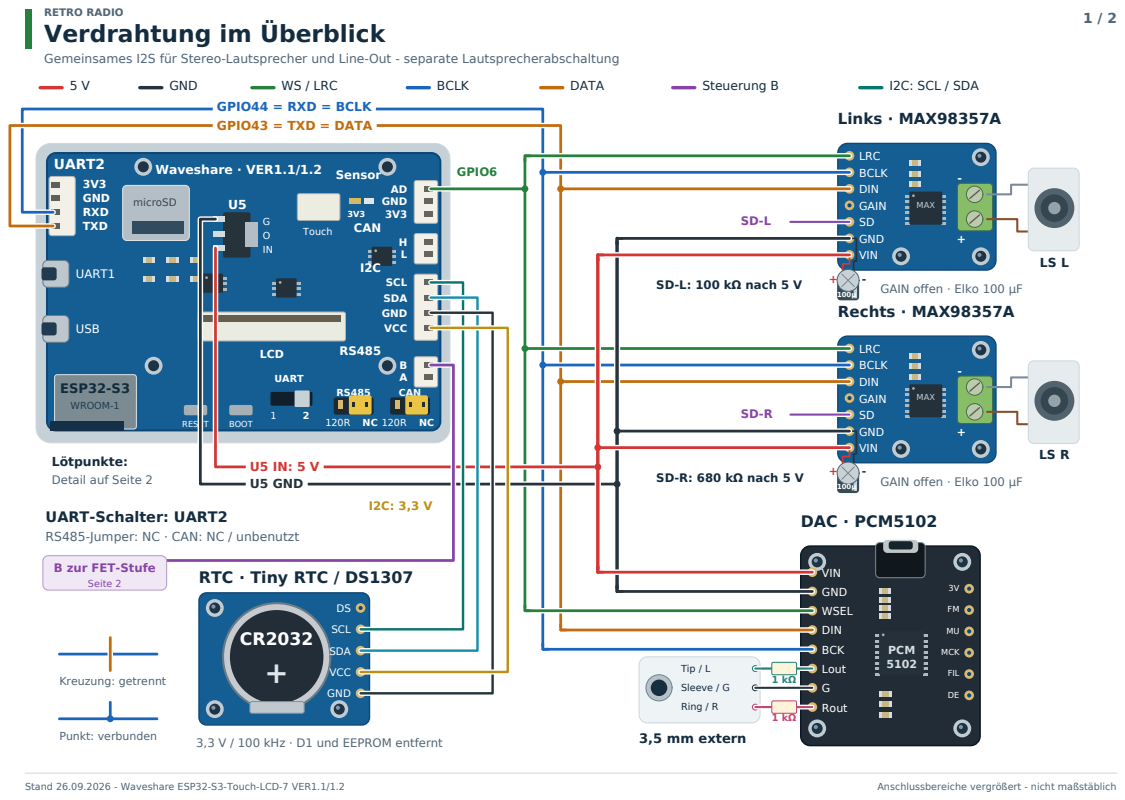
[picture p219: page 1]
RETRO RADIO; GND; WS / LRC; BCLK; DATA; Steuerung B; I2C: SCL / SDA; 3V3 GND RXD TXD; UART2; microSD; UART1; USB; ESP32-S3; WROOM-1; Waveshare · VER1.1/1.2; Touch; LCD; AD GND 3V3; Sensor; CAN; SCL SDA GND VCC; RESET; BOOT; UART; Links · MAX98357A; LRC; DIN; GAIN; VIN; MAX; GAIN offen · Elko 100 µF; Rechts · MAX98357A; SCL; SDA; VCC; DAC · PCM5102; WSEL; BCK; Lout; Rout; PCM 5102; MCK; FIL; GPIO44 = RXD = BCLK; GPIO43 = TXD = DATA; GPIO6; U5 IN: 5 V U5 GND; Seite 2; 3,5 mm extern; Tip / L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

Gemeinsames I2S für Stereo-Lautsprecher und Line-Out - separate Lautsprecherabschaltung

SD-L: 100 kΩ nach 5 V

Lötpunkte:
Detail auf Seite 2
I2C: 3,3 V UART-Schalter: UART2

SD-R: 680 kΩ nach 5 V

RS485-Jumper: NC · CAN: NC / unbenutzt

B zur FET-Stufe

RTC · Tiny RTC / DS1307

3,3 V / 100 kHz · D1 und EEPROM entfernt

RETRO RADIO

# Lötpunkte, Abschaltung und Details

Diese Seite ergänzt die Gesamtverdrahtung. SD-L und SD-R sind getrennte Netze. Die beiden Gates sind miteinander verbunden.

2 / 2

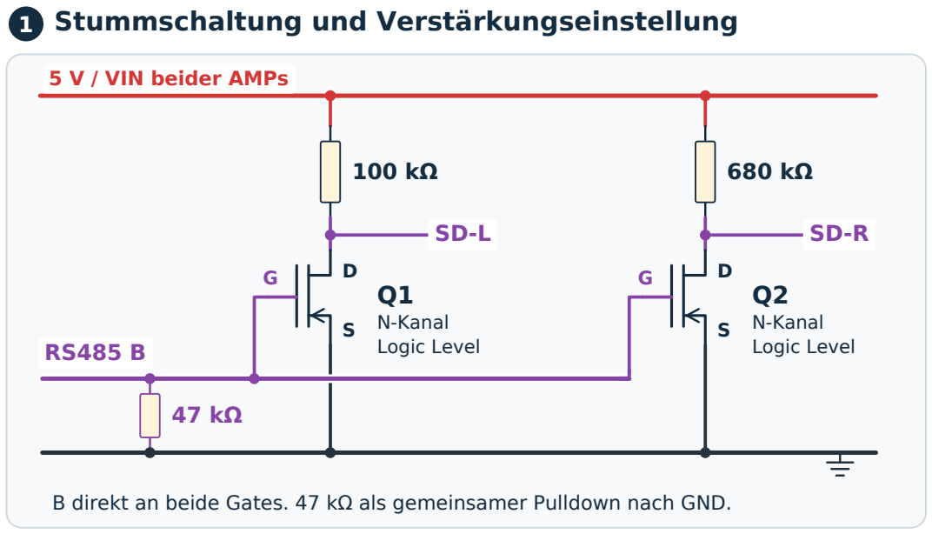
[picture p220: figure]
5 V / VIN beider AMPs; N-Kanal Logic Level; N-Kanal; Logic Level
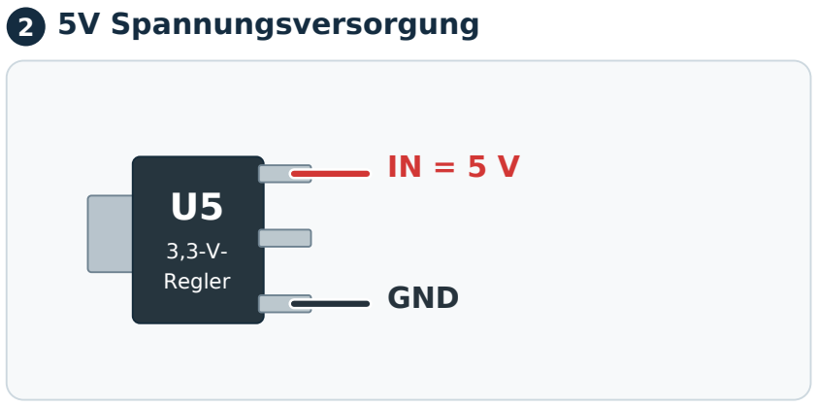
[picture p221: figure]
3,3-V- Regler; GND

1 Stummschaltung und Verstärkungseinstellung | 2 5V Spannungsversorgung

B direkt an beide Gates. 47 kΩ als gemeinsamer Pulldown nach GND.

B ca. 0,05 V: Lautsprecher an. B ca. 4,95 V: Lautsprecher aus.

D/S/G am verwendeten MOSFET prüfen. Die Zeichnung ist keine Gehäuse-Pinbelegung.

Die 5-V-Versorgung der Audio-Module wird am Eingang IN des Reglers U5 abgegriffen. GND ist die gemeinsame Masse.

An jedem AMP: 100 µF direkt zwischen VIN und GND

VIN / 5 V | + | 100 µF | GND

GAIN bleibt offen (9 dB). 100 kΩ / 680 kΩ an SD der Verstärker.

3 Schalter und Jumper | 4 RTC am I2C-Anschluss | 5 Externer Line-Out

UART: Schieber auf UART2

UART1 | UART2

RS485

120R NC

RS485: Brücke Mitte + NC.
CAN: ebenfalls NC, Anschluss unbenutzt.

Der 120-Ω-Abschluss an RS485 muss aus sein. A bleibt frei und ist kein unabhängiger Steuerausgang.

I2C-Spannungswahl auf 3V3 belassen.

SCL | GPIO9 / SCL
SDA | GPIO8 / SDA
VCC | 3,3 V
GND | GND

DS bleibt frei. I2C-Takt: 100 kHz.

D1 ausgelötet · EEPROM U3 ausgelötet

Der Betrieb an 3,3 V liegt außerhalb der DS1307-Spezifikation. Der spezifizierte Versorgungsbereich beträgt 4,5 bis 5,5 V.

Lout -> 1 kΩ -> Tip / Spitze

Rout -> 1 kΩ -> Ring

G -> Sleeve / Schaft

Line-Level, keine Kopfhörerausgabe.

Waveshare-Schaltplan V1.2 (Referenz) (https://files.waveshare.com/wiki/ESP32-S3-Touch-LCD-7/ESP32-S3-Touch-LCD-7-Sch.pdf) | Adafruit MAX98357A (https://learn.adafruit.com/adafruit-max98357-i2s-class-d-mono-amp/pinouts) | Adafruit PCM510x (https://learn.adafruit.com/adafruit-pcm510x-i2s-dac/pinouts) | DS1307-Datenblatt (https://www.analog.com/media/en/technical-documentation/data-sheets/DS1307.pdf)
Stand 26.09.2026 - Waveshare ESP32-S3-Touch-LCD-7 VER1.1/1.2 | Anschlussbereiche vergrößert - nicht maßstäblich
