DIYLAB-DE/RetroRadio/src/Settings.cpp

#include "Settings.h"
#include "main.h"

#include <esp_system.h>
#include <esp_heap_caps.h>
#include <esp_mac.h>
#include <esp_ota_ops.h>
#include <WiFi.h>

#include "hal/usb_serial_jtag_ll.h"
#include "soc/usb_serial_jtag_reg.h"

#include <cctype>
#include <cstring>
#include <ctime>

#include "AppState.h"
#include "Clocks.h"
#include "DS1307_RTC.h"
#include "HttpService.h"
#include "I18n.h"
#include "Keyboard.h"
#include "MessageBox.h"
#include "Strings_common.h"
#include "SystemStats.h"
#include "Theme.h"
#include "RetroRadio.h" // Maße, Farben und Aufzählung der Abstimmröhren

#include "WifiList.h"

#include <ArduinoJson.h>

#include "fonts/ComfortaaBold10.h"
#include "fonts/ComfortaaBold14.h"
#include "fonts/ComfortaaBold16.h"
#include "fonts/ComfortaaBold30.h"
#include "fonts/LeagueGothicCond34.h"

// ===================================================================
// Layout- und Farbkonstanten
// ===================================================================

namespace
{
    // Bildschirm und Grobaufteilung
    constexpr int SCREEN_W = 800;                   ///< Display-Breite
    constexpr int SCREEN_H = 480;                   ///< Display-Höhe
    constexpr int FOOTER_H = 56;                    ///< Höhe der Fußzeile
    constexpr int VIEWPORT_H = SCREEN_H - FOOTER_H; ///< Höhe über der Fußzeile
    constexpr int FOOTER_Y = VIEWPORT_H;            ///< Obere Kante der Fußzeile

    // Menü (links)
    constexpr int MENU_X = 2;                      ///< Linke Kante der Menüliste
    constexpr int MENU_W = 170;                    ///< Breite der Menüliste
    constexpr int MENU_SPRITE_H = SCREEN_H;        ///< Höhe des Menü-Sprites (volle Displayhöhe)
    constexpr int SECTION_ROW_H = 28;              ///< Zeilenhöhe einer Sektionsüberschrift
    constexpr int ITEM_ROW_H = 36;                 ///< Zeilenhöhe eines Panel-Eintrags; drei Sektionsköpfe und elf Einträge müssen zusammen in MENU_SPRITE_H passen
    constexpr int ITEM_ACCENT_W = 4;               ///< Breite des Kategorie-Farbstreifens
    constexpr int ITEM_TEXT_X = ITEM_ACCENT_W + 6; ///< Texteinzug nach dem Akzent-Balken

    // Scrollbar (zwischen Menü und Arbeitsbereich)
    constexpr int SCROLLBAR_X = MENU_X + MENU_W + 4;     ///< Linke Kante der Scrollbar (4 px Abstand nach Menü)
    constexpr int SCROLLBAR_W = 6;                       ///< Breite der Scrollbar
    constexpr int DIVIDER_X = SCROLLBAR_X + SCROLLBAR_W; ///< Grenze Menübereich Arbeitsbereich

    // Arbeitsbereich (rechts)
    constexpr int WORK_X = SCROLLBAR_X + SCROLLBAR_W + 10; ///< Linke Kante des Arbeitsbereichs (10 px Abstand nach Scrollbar)
    constexpr int WORK_Y = 5;                              ///< Obere Kante des Arbeitsbereichs
    constexpr int WORK_W = SCREEN_W - WORK_X - 10;         ///< Breite des Arbeitsbereichs
    constexpr int WORK_H = VIEWPORT_H - WORK_Y;            ///< Höhe des Arbeitsbereichs
    constexpr int WORK_R = 12;                             ///< Eckradius des Arbeitsbereichs

    // Titelbox im Arbeitsbereich (sprite-relativ)
    constexpr int TITLE_BOX_X = 10;          ///< Linke Kante der Titelbox
    constexpr int TITLE_BOX_Y = 10;          ///< Obere Kante der Titelbox
    constexpr int TITLE_BOX_W = WORK_W - 20; ///< Breite der Titelbox
    constexpr int TITLE_BOX_H = 69;          ///< Höhe der Titelbox
    constexpr int TITLE_BOX_R = 10;          ///< Eckradius der Titelbox
    constexpr int TITLE_TEXT_X = 28;         ///< X-Einzug von Titel und Untertitel
    constexpr int TITLE_TEXT_Y = 18;         ///< Y-Position des Titels
    constexpr int SUB_TEXT_Y = 50;           ///< Y-Position des Untertitels

    // Inhaltsbereich unterhalb der Titelbox (sprite-relativ)
    constexpr int CONTENT_X = TITLE_BOX_X;                    ///< Linke Kante des Inhalts
    constexpr int CONTENT_Y = TITLE_BOX_Y + TITLE_BOX_H + 12; ///< Obere Kante des Inhalts
    constexpr int CONTENT_W = WORK_W - 2 * TITLE_BOX_X;       ///< Breite des Inhalts
    constexpr int CONTENT_H = WORK_H - CONTENT_Y - 10;        ///< Höhe des Inhalts

    // WLAN-Profilzeilen
    constexpr int WIFI_ROW_H = 46;   ///< Höhe einer Profilzeile
    constexpr int WIFI_ROW_GAP = 8;  ///< Abstand zwischen Profilzeilen
    constexpr int WIFI_ACT_H = 44;   ///< Höhe der Aktionsknöpfe
    constexpr int WIFI_ACT_GAP = 10; ///< Abstand zwischen Aktionsknöpfen

    // Geräte-Netzwerkname (Feld am unteren Rand des Arbeitsbereichs)
    constexpr int HOSTNAME_FIELD_H = 64;     ///< Höhe des Netzwerknamen-Feldes
    constexpr int HOSTNAME_BOTTOM_GAP = 10;  ///< Abstand der Feld-Unterkante zur Unterkante des Arbeitsbereichs
    constexpr int HOSTNAME_PAD_X = 14;       ///< Innenabstand links/rechts im Feld
    constexpr int HOSTNAME_LINE_GAP = 4;     ///< Vertikaler Abstand zwischen Beschriftung und Name
    constexpr int HOSTNAME_EDIT_BTN_W = 130; ///< Breite des ändern-Knopfes im Feld
    constexpr int HOSTNAME_EDIT_BTN_H = 44;  ///< Höhe des ändern-Knopfes im Feld

    // Umschalter mit Rahmen, dunkler Füllung und Statusfarbe
    constexpr int TOGGLE_W = 55;      ///< Breite des Umschalters
    constexpr int TOGGLE_H = 29;      ///< Höhe des Umschalters
    constexpr int TOGGLE_MARGIN = 14; ///< Abstand des Umschalters vom rechten Zeilenrand
    constexpr int TOGGLE_INSET = 2;   ///< Randbreite des Gehäuses
    constexpr int TOGGLE_KNOB_R = 10; ///< Radius des Schaltknopfes

    // Rubriken im Allgemein-Panel
    constexpr int GENERAL_HEADING_H = 32; ///< Höhe einer Rubriküberschrift
    constexpr int GENERAL_SECTION_GAP = 24; ///< Abstand zwischen den Rubriken

    // Sprachzeilen
    constexpr int LANG_ROW_H = 54;   ///< Höhe einer Sprachzeile
    constexpr int LANG_ROW_GAP = 12; ///< Abstand zwischen Sprachzeilen
    constexpr int LANG_ROWS_Y = CONTENT_Y + GENERAL_HEADING_H; ///< Beginn der Sprachauswahl
    constexpr int LOGS_HEADING_Y = LANG_ROWS_Y + 2 * LANG_ROW_H + LANG_ROW_GAP + GENERAL_SECTION_GAP; ///< Beginn der Log-Rubrik

    // Info-Knöpfe
    constexpr int FOOTER_ACTION_BTN_MIN_W = 120;  ///< Mindestbreite eines Textknopfes im Footer
    constexpr int FOOTER_ACTION_BTN_PAD_X = 24;   ///< Horizontaler Innenabstand eines Textknopfes im Footer
    constexpr int FOOTER_ACTION_BTN_GAP = 12;     ///< Abstand zwischen Textknöpfen im Footer
    constexpr int FOOTER_ACTION_BTN_X0 = WORK_X;  ///< Linker Anfang des Textknopf-Blocks im Footer
    constexpr int FOOTER_ACTION_CLOCK_GAP = 16;   ///< Mindestabstand zwischen Textknöpfen und Uhr

    // PIN-Eingabe
    constexpr int PIN_HINT_Y = CONTENT_Y + TOGGLE_H + 32; ///< Höhe der Textmitte unter dem PIN-Schalter
    constexpr int PIN_DOTS_Y = PIN_HINT_Y + 36;           ///< Höhe der Punktmitten
    constexpr int PIN_DOT_R = 13;                         ///< Radius eines PIN-Punktes
    constexpr int PIN_DOT_GAP = 36;                       ///< Abstand zwischen zwei Punktmitten

    // Fußzeile und Buttons
    constexpr int FOOTER_CY = FOOTER_Y + FOOTER_H / 2;   ///< Vertikale Mitte der Fußzeile
    constexpr int BTN_H = 44;                            ///< Standard-Button-Höhe
    constexpr int BTN_R = 6;                             ///< Standard-Button-Eckradius
    constexpr int SAVE_BTN_W = 150;                      ///< Breite des Speichern-Knopfes
    constexpr int SAVE_BTN_CX = WORK_X + SAVE_BTN_W / 2; ///< X-Mitte des Speichern-Knopfes

    constexpr int EXIT_BTN_SIZE = 44;                              ///< Kantenlänge des Exit-Knopfes
    constexpr int EXIT_BTN_CX = SCREEN_W - EXIT_BTN_SIZE / 2 - 10; ///< X-Mitte (10 px vom rechten Rand)
    constexpr int EXIT_BTN_CY = FOOTER_CY;                         ///< Y-Mitte des Exit-Knopfes

    constexpr int CLOCK_W = 104;                                                 ///< Uhr-Sprite-Breite
    constexpr int CLOCK_H = 45;                                                  ///< Uhr-Sprite-Höhe
    constexpr int CLOCK_PUSH_X = EXIT_BTN_CX - EXIT_BTN_SIZE / 2 - 14 - CLOCK_W; ///< X-Startposition der Uhr (14 px Abstand zum Exit)
    constexpr int CLOCK_PUSH_Y = FOOTER_Y + (FOOTER_H - CLOCK_H) / 2 + 1;        ///< Y-Startposition der Uhr

    // Farben
    constexpr uint16_t C_BG = Theme::ColorMainBackGround; ///< Hintergrundfarbe
    constexpr uint16_t C_WORK_BG = 0x1082;                ///< Hintergrund des Arbeitsbereichs
    constexpr uint16_t C_TITLE_BG = 0x2104;               ///< Hintergrund der Titelbox
    constexpr uint16_t C_TEXT = 0xDEDB;                   ///< Standardtext
    constexpr uint16_t C_TEXT_BRIGHT = 0xFFFF;            ///< Heller Text für gewählten Eintrag
    constexpr uint16_t C_SUB = 0xB5F7;                    ///< Untertitel und Hilfetext
    constexpr uint16_t C_SEC_HDR_TXT = 0xB5F7;            ///< Sektionskopf-Text
    constexpr uint16_t C_SEP_LINE = 0x2945;               ///< Trennlinie zwischen Listeneinträgen
    constexpr uint16_t C_ROW_BG = 0x18C3;                 ///< Hintergrund einer Zeile
    constexpr uint16_t C_ROW_SEL_BG = 0x2945;             ///< Hintergrund der gewählten Zeile
    constexpr uint16_t C_DOT_EMPTY = 0x4208;              ///< Leerer PIN-Punkt

    // Scrollbar (zwischen Menü und Arbeitsbereich)
    constexpr uint16_t C_SCROLLBAR_TRACK = 0x2104;  ///< Scrollbar-Track
    constexpr uint16_t C_SCROLLBAR_NORMAL = 0x5ACB; ///< Scrollbar-Thumb

    // Sektionsfarben
    constexpr uint16_t C_SEC_CONNECTION = 0x07F4; ///< Petrol
    constexpr uint16_t C_SEC_SERVICES = 0xC1AC;   ///< Pflaume
    constexpr uint16_t C_SEC_SYSTEM = 0x07E0;     ///< Grün

    // Status-Farben (WLAN-Profilzeile)
    constexpr uint16_t C_ST_INACTIVE = 0x8410; ///< Status: inaktiv
    constexpr uint16_t C_ST_EMPTY = 0x6B4D;    ///< Status: kein Netz

    // Button-Farben mit dunkler Füllung und heller Kontur
    constexpr uint16_t BTN_OUTLINE = 0x39E8;     ///< Rahmen im Normalzustand
    constexpr uint16_t BTN_FILL = 0x0000;        ///< Füllung im Normalzustand
    constexpr uint16_t BTN_TEXT = 0xAD75;        ///< Text im Normalzustand
    constexpr uint16_t BTN_ACTIVE_FILL = 0x328A; ///< Füllung im aktiven Zustand
    constexpr uint16_t BTN_ACTIVE_TEXT = 0xFFFF; ///< Text im aktiven Zustand

    // Die Firmware-Kennung wird über das Build-Flag FW_VERSION eingespeist.
#ifndef FW_VERSION
#define FW_VERSION "1.0"
#endif

    // Wetter-Panel: PLZ-Eingabe (5 große Ziffernfelder)
    constexpr int PLZ_BOX_W = 50;   ///< Breite einer Ziffer-Box
    constexpr int PLZ_BOX_H = 56;   ///< Höhe einer Ziffer-Box
    constexpr int PLZ_BOX_GAP = 12; ///< Abstand zwischen zwei Ziffer-Boxen
    constexpr int PLZ_DIGITS = 5;   ///< Anzahl Ziffern der Postleitzahl

    // Cloud-Panel: fünf tappbare Zeilen mit Label und Wert, plus Lösch-Knopf
    constexpr int CLOUD_TOP_GAP = 10;      ///< Abstand zwischen Titelbox und erster Cloud-Zeile
    constexpr int CLOUD_ROW_H = 48;        ///< Höhe einer Cloud-Zeile (zwei Textzeilen)
    constexpr int CLOUD_ROW_GAP = 6;       ///< Abstand zwischen Zeilen
    constexpr int CLOUD_ROW_PAD_X = 14;    ///< Innenabstand der URL-Zeile links/rechts
    constexpr int CLOUD_ROW_LABEL_Y = 5;   ///< Y der Beschriftung relativ zum Zeilen-Anfang
    constexpr int CLOUD_ROW_VALUE_Y = 25;  ///< Y der Wertanzeige relativ zum Zeilen-Anfang
    constexpr int CLOUD_VIS_BTN_SIZE = 44; ///< Größe des Sichtbarkeits-Knopfes
    constexpr int CLOUD_VIS_BTN_MARGIN = 12; ///< Abstand des Sichtbarkeits-Knopfes zum Titelbox-Rand
    constexpr int CLOUD_ROW_COUNT = 5;     ///< Fünf Cloud-Werte

    // Zeit-Panel: drei Wahl-Zeilen, manuelle Zeit und Sekundenzeiger-Schalter
    constexpr int TIME_FIELD_H = 50;       ///< Höhe einer Wahl-Zeile
    constexpr int TIME_FIELD_GAP = 6;      ///< Abstand zwischen Wahl-Zeilen
    constexpr int TIME_FIELD_PAD_X = 14;   ///< Innenabstand der Wahl-Zeile links/rechts
    constexpr int TIME_FIELD_LABEL_Y = 6;  ///< Y der Beschriftung relativ zum Zeilen-Anfang
    constexpr int TIME_FIELD_VALUE_Y = 26; ///< Y des Wertes relativ zum Zeilen-Anfang
    constexpr int TIME_FIELD_COUNT = 3;    ///< Zeitzone, NTP-Server, Sync-Intervall

    constexpr int TIME_STEPPER_COL_W = 70;  ///< Breite einer Stepper-Spalte
    constexpr int TIME_STEPPER_COL_GAP = 6; ///< Abstand zwischen Stepper-Spalten
    constexpr int TIME_STEPPER_TOTAL_W = 5 * TIME_STEPPER_COL_W + 4 * TIME_STEPPER_COL_GAP;
    constexpr int TIME_STEPPER_BTN_H = 26; ///< Höhe eines Stepper-Knopfes (oben/unten)
    constexpr int TIME_STEPPER_VAL_H = 32; ///< Höhe der Wert-Anzeige in der Mitte
    constexpr int TIME_STEPPER_TOTAL_H = TIME_STEPPER_BTN_H * 2 + TIME_STEPPER_VAL_H + 4;
    constexpr int TIME_SET_BTN_H = 45;  ///< Höhe des Zeit-setzen-Knopfes
    constexpr int TIME_SET_BTN_W = 160; ///< Breite des Zeit-setzen-Knopfes
    constexpr int TIME_SECOND_Y = CONTENT_H - TIME_FIELD_H; ///< Obere Kante der Sekundenzeiger-Zeile relativ zum Inhalt
    constexpr int TIME_STEPPER_BLOCK_Y = (TIME_FIELD_COUNT * (TIME_FIELD_H + TIME_FIELD_GAP) - TIME_FIELD_GAP + TIME_SECOND_Y - TIME_STEPPER_TOTAL_H) / 2; ///< Schrittgeber zwischen Auswahlzeilen und Sekundenzeiger-Zeile

    static_assert(TIME_STEPPER_BLOCK_Y >= TIME_FIELD_COUNT * (TIME_FIELD_H + TIME_FIELD_GAP), "Zeitfelder und Schrittgeber überlappen");
    static_assert(TIME_STEPPER_BLOCK_Y + TIME_STEPPER_TOTAL_H + TIME_FIELD_GAP <= TIME_SECOND_Y, "Schrittgeber und Sekundenzeiger-Zeile überlappen");
    static_assert(TIME_STEPPER_TOTAL_W + TIME_FIELD_GAP + TIME_SET_BTN_W <= CONTENT_W, "Zeit-setzen-Knopf passt nicht neben die Schrittgeber");

    // Zeitfenster-Panel: 7 Wochentage x 24 volle Stunden
    constexpr int TIME_WINDOW_DAYS = AppState::TIME_WINDOW_DAY_COUNT;   ///< Anzahl Wochentage
    constexpr int TIME_WINDOW_HOURS = AppState::TIME_WINDOW_HOUR_COUNT; ///< Anzahl voller Stunden
    constexpr int TIME_WINDOW_DAY_LABEL_W = 28; ///< Breite der Wochentags-Spalte
    constexpr int TIME_WINDOW_GRID_W = CONTENT_W - TIME_WINDOW_DAY_LABEL_W; ///< Breite der Stunden-Spalten
    constexpr int TIME_WINDOW_CELL_H = 27;     ///< Höhe einer Wochentags-Zeile
    constexpr int TIME_WINDOW_CHECK_SIZE = 15; ///< Kantenlänge einer Checkbox
    constexpr int TIME_WINDOW_HEADER_H = 26;   ///< Höhe der Stunden-Kopfzeile
    constexpr int TIME_WINDOW_TOP = CONTENT_Y + 10; ///< Obere Kante der Matrix
    constexpr int TIME_WINDOW_DAY_TEXT_X = 8;  ///< Texteinzug der Wochentagskürzel
    constexpr int TIME_WINDOW_HOUR_LABEL_BUF = 3; ///< Puffergröße für zweistellige Stunden
    constexpr int TIME_WINDOW_FRAME_R = 6;     ///< Eckradius des Matrix-Rahmens
    constexpr int TIME_WINDOW_INNER_R = 5;     ///< Eckradius der Innenfläche
    constexpr int TIME_WINDOW_FRAME_INSET = 1; ///< Innenversatz der Matrix-Füllung
    constexpr int TIME_WINDOW_FRAME_PAD_Y = 2; ///< Vertikaler Außenabstand des Matrix-Rahmens
    constexpr float TIME_WINDOW_TICK_R = 0.8f; ///< Radius des Hakenstrichs
    constexpr int TIME_WINDOW_HINT_GAP_Y = 16; ///< Abstand der Erklärung unter der Matrix
    constexpr int TIME_WINDOW_HINT_LINE_H = 19; ///< Zeilenhöhe der Erklärung
    constexpr int TIME_WINDOW_HINT_X = CONTENT_X + 4; ///< Linke Textkante der Erklärung
    constexpr uint32_t TIME_WINDOW_FULL_MASK = 0x00FFFFFFUL; ///< Alle 24 Stunden aktiv

    // Klang-Panel: fünf Klangwerte und Lautsprecher-Freigabe, je Label links, dann Minus, Wert, Plus
    constexpr int AUDIO_ROW_COUNT = 5;       ///< Tiefen, Mitten, Höhen, Basisbreite, Loudness
    constexpr int AUDIO_WIDTH_ROW = 3;       ///< Zeile für die Basisbreite
    constexpr int AUDIO_ROW_H = 44;          ///< Höhe einer Klang-Zeile
    constexpr int AUDIO_ROW_GAP = 5;         ///< Abstand zwischen den Zeilen
    constexpr int AUDIO_ROW_FIRST_Y = 4;     ///< Y der ersten Zeile relativ zum Inhalt
    constexpr int AUDIO_STEP_BTN_W = 58;     ///< Breite eines Plus/Minus-Knopfes
    constexpr int AUDIO_STEP_VAL_W = 150;    ///< Breite der Wert-Anzeige in der Mitte
    constexpr int AUDIO_STEP_GAP = 10;       ///< Abstand zwischen Knopf und Wert
    constexpr int AUDIO_FREQ_STEP_HZ = 100;  ///< Schrittweite eines Tastendrucks in Hz
    constexpr int AUDIO_WIDTH_STEP_PCT = 10; ///< Schrittweite der Basisbreite in Prozent
    constexpr int AUDIO_LOUDNESS_STEP_PCT = 10; ///< Schrittweite der Loudness in Prozent

    // Eckfrequenz-Grenzen je Band in Hz (konservativ)
    constexpr uint16_t AUDIO_LOW_MIN = 100; // 100 statt 200: erlaubt einen echten Bass-Shelf, der Stimmen unangetastet lässt
    constexpr uint16_t AUDIO_LOW_MAX = 800;
    constexpr uint16_t AUDIO_PEAK_MIN = 1500;
    constexpr uint16_t AUDIO_PEAK_MAX = 6000;
    constexpr uint16_t AUDIO_HIGH_MIN = 4000;
    constexpr uint16_t AUDIO_HIGH_MAX = 12000;
    constexpr uint16_t AUDIO_WIDTH_MIN = 0;
    constexpr uint16_t AUDIO_WIDTH_MAX = 200;
    constexpr uint16_t AUDIO_LOUDNESS_MIN = 0;
    constexpr uint16_t AUDIO_LOUDNESS_MAX = 100;

    // Klang-Footer: Hörprobe-Knopf und Lautstärke (Play, Minus, DotMatrix, Plus)
    constexpr int AUDIO_FT_BTN_SIZE = 44;    ///< Quadratische Footer-Knöpfe
    constexpr int AUDIO_FT_BTN_R = 6;        ///< Eckradius der Footer-Knöpfe
    constexpr int AUDIO_FT_GAP = 8;          ///< Abstand zwischen den Footer-Elementen
    constexpr int AUDIO_FT_VOL_STEP = 5;     ///< Schrittweite der Lautstärke pro Tastendruck
    constexpr int AUDIO_FT_DOT_W = 3;        ///< DotMatrix Punktbreite
    constexpr int AUDIO_FT_DOT_H = 3;        ///< DotMatrix Punkthöhe
    constexpr int AUDIO_FT_DOT_SPACE = 1;    ///< Abstand zwischen Punkten
    constexpr int AUDIO_FT_CHAR_SPACE = 5;   ///< Abstand zwischen Ziffern
    constexpr int AUDIO_FT_CHAR_W = 5 * AUDIO_FT_DOT_W + 4 * AUDIO_FT_DOT_SPACE; ///< Breite einer Ziffer
    constexpr int AUDIO_FT_DISP_W = 2 * AUDIO_FT_CHAR_W + AUDIO_FT_CHAR_SPACE;   ///< Breite der Zahl (zweistellig)
    constexpr int AUDIO_FT_DISP_H = 7 * AUDIO_FT_DOT_H + 6 * AUDIO_FT_DOT_SPACE; ///< Höhe der Zahl
    constexpr int AUDIO_FT_FRAME_PAD = 8;    ///< Innenabstand im Zahlenrahmen
    constexpr int AUDIO_FT_FRAME_W = AUDIO_FT_DISP_W + 2 * AUDIO_FT_FRAME_PAD;   ///< Breite des Zahlenrahmens

    // Klang-Footer: Block aus Play, Vol-, Zahl, Vol+ rechtsbündig vor der Uhr
    constexpr int AUDIO_FT_BLOCK_W = AUDIO_FT_BTN_SIZE * 3 + AUDIO_FT_FRAME_W + AUDIO_FT_GAP * 3; ///< Gesamtbreite des Blocks
    constexpr int AUDIO_FT_BLOCK_RIGHT = CLOCK_PUSH_X - 16;                  ///< Rechte Kante des Blocks (16 px vor der Uhr)
    constexpr int AUDIO_FT_PLAY_CX = AUDIO_FT_BLOCK_RIGHT - AUDIO_FT_BLOCK_W + AUDIO_FT_BTN_SIZE / 2; ///< Play-Knopf-Mitte
    constexpr int AUDIO_FT_VDOWN_CX = AUDIO_FT_PLAY_CX + AUDIO_FT_BTN_SIZE + AUDIO_FT_GAP;            ///< Vol-Minus-Mitte
    constexpr int AUDIO_FT_FRAME_X = AUDIO_FT_VDOWN_CX + AUDIO_FT_BTN_SIZE / 2 + AUDIO_FT_GAP;        ///< Zahlenrahmen linke Kante
    constexpr int AUDIO_FT_DISP_X = AUDIO_FT_FRAME_X + AUDIO_FT_FRAME_PAD;                            ///< DotMatrix linke Kante
    constexpr int AUDIO_FT_VUP_CX = AUDIO_FT_FRAME_X + AUDIO_FT_FRAME_W + AUDIO_FT_GAP + AUDIO_FT_BTN_SIZE / 2; ///< Vol-Plus-Mitte

    // Anzeige-Panel: eine Zeile mit Label links, dann Minus, Wert-Text, Plus
    // Anzeige-Panel: zwei Abschnitte, oben die Röhrenwahl mit Vorschau, unten das VU-Meter.
    // Alle Y-Werte sind Abstände zur Oberkante des Inhaltsbereichs.
    constexpr int APPEARANCE_HINT_H = 23;       ///< Zeilenhöhe von ComfortaaBold16: Aufstrich 18, Unterlänge 5
    constexpr int APPEARANCE_SEC_LINE_DY = 24;  ///< Trennlinie unter dem Text der Überschrift
    constexpr int APPEARANCE_SEC1_Y = 0;        ///< Überschrift des ersten Abschnitts
    constexpr int APPEARANCE_TILE_Y = 29;       ///< Obere Kante der Röhrenkacheln
    constexpr int APPEARANCE_TILE_W = 134;      ///< Breite einer Röhrenkachel
    constexpr int APPEARANCE_TILE_H = 94;       ///< Höhe einer Röhrenkachel
    constexpr int APPEARANCE_TILE_GAP = 14;     ///< Abstand zwischen den Kacheln
    constexpr int APPEARANCE_EYE_BOX = 70;      ///< Kantenlänge der Röhrendarstellung, wie im Radio
    constexpr int APPEARANCE_HINT1_Y = 128;     ///< Hinweiszeile des ersten Abschnitts
    constexpr int APPEARANCE_SEC2_Y = 159;      ///< Überschrift des zweiten Abschnitts
    constexpr int APPEARANCE_ROW1_Y = 189;      ///< Zeile der Zeigerträgheit
    constexpr int APPEARANCE_ROW2_Y = 256;      ///< Zeile des Bezugspegels
    constexpr int APPEARANCE_ROW_H = 36;        ///< Höhe einer Wahlzeile
    constexpr int APPEARANCE_HINT_DY = 39;      ///< Abstand der Hinweiszeile unter ihrer Wahlzeile

    // Der Inhaltsbereich endet ohnehin 10 Bildpunkte über der Panelkante. Endet die letzte
    // Hinweiszeile genau auf seiner Unterkante, stimmt dieser Abstand; der Rest verteilt sich
    // auf die Lücken darüber. Wer eine Zeile verschiebt, muss die Rechnung wieder aufgehen lassen.
    static_assert(APPEARANCE_ROW2_Y + APPEARANCE_HINT_DY + APPEARANCE_HINT_H == CONTENT_H,
                  "Die letzte Hinweiszeile muss genau auf der Unterkante des Inhalts enden");
    constexpr int APPEARANCE_LABEL_W = 150;     ///< Breite der Beschriftung links neben den Segmenten
    constexpr int APPEARANCE_SEG_GAP = 6;       ///< Abstand zwischen zwei Segmenten
    constexpr int APPEARANCE_LEVEL_W = 220;     ///< Breite der Pegelanzeige rechts in der Abschnittszeile
    constexpr unsigned long APPEARANCE_LEVEL_MS = 1000; ///< Auffrischung der Pegelanzeige
    constexpr float APPEARANCE_LEVEL_SMOOTH = 0.05f;    ///< Glättung je Durchlauf, ergibt rund eine Sekunde
    constexpr uint8_t APPEARANCE_EYE_MIN = 0;   ///< Kleinster Stilwert des magischen Auges (EM11)
    constexpr uint8_t APPEARANCE_EYE_MAX = 3;   ///< Größter Stilwert des magischen Auges (EM84), muss zur Aufzählung MagicEyeStyle in include/RetroRadio.h passen
    constexpr uint8_t APPEARANCE_VU_MIN = 0;    ///< Kleinste Trägheit
    constexpr uint8_t APPEARANCE_VU_MAX = 2;    ///< Größte Trägheit, muss zur Aufzählung VuBallistics in include/Visualizer.h passen
    constexpr uint8_t APPEARANCE_SENS_MIN = 0;  ///< Kleinster Bezugspegel
    constexpr uint8_t APPEARANCE_SENS_MAX = 4;  ///< Größter Bezugspegel, muss zur Tabelle VU_ALIGNMENT_DB in src/Visualizer.cpp passen

    /**
     * @brief Zeitzonen-Tabelle: Region-Bezeichner -> POSIX-Zeichenkette.
     *
     * Die Region-Namen folgen der IANA-Schreibweise und gelten sprachübergreifend gleichermaßen. POSIX-Strings codieren den UTC-Versatz und gegebenenfalls die Sommerzeitregeln, sodass die Zeitumstellung ohne weiteren Umschalter korrekt funktioniert.
     */
    struct TimezoneEntry
    {
        const char *region;
        const char *posix;
    };

    const TimezoneEntry TIMEZONES[] = {
        {"Europe/Berlin", "CET-1CEST,M3.5.0,M10.5.0/3"},
        {"Europe/Vienna", "CET-1CEST,M3.5.0,M10.5.0/3"},
        {"Europe/Zurich", "CET-1CEST,M3.5.0,M10.5.0/3"},
        {"Europe/Amsterdam", "CET-1CEST,M3.5.0,M10.5.0/3"},
        {"Europe/Brussels", "CET-1CEST,M3.5.0,M10.5.0/3"},
        {"Europe/Paris", "CET-1CEST,M3.5.0,M10.5.0/3"},
        {"Europe/Rome", "CET-1CEST,M3.5.0,M10.5.0/3"},
        {"Europe/Madrid", "CET-1CEST,M3.5.0,M10.5.0/3"},
        {"Europe/London", "GMT0BST,M3.5.0/1,M10.5.0"},
        {"Europe/Dublin", "IST-1GMT0,M10.5.0,M3.5.0/1"},
        {"Europe/Lisbon", "WET0WEST,M3.5.0/1,M10.5.0"},
        {"Europe/Athens", "EET-2EEST,M3.5.0/3,M10.5.0/4"},
        {"Europe/Helsinki", "EET-2EEST,M3.5.0/3,M10.5.0/4"},
        {"Europe/Stockholm", "CET-1CEST,M3.5.0,M10.5.0/3"},
        {"Europe/Oslo", "CET-1CEST,M3.5.0,M10.5.0/3"},
        {"Europe/Copenhagen", "CET-1CEST,M3.5.0,M10.5.0/3"},
        {"Europe/Warsaw", "CET-1CEST,M3.5.0,M10.5.0/3"},
        {"Europe/Prague", "CET-1CEST,M3.5.0,M10.5.0/3"},
        {"Europe/Budapest", "CET-1CEST,M3.5.0,M10.5.0/3"},
        {"Europe/Moscow", "MSK-3"},
        {"Europe/Kiev", "EET-2EEST,M3.5.0/3,M10.5.0/4"},
        {"Europe/Istanbul", "TRT-3"},
        {"America/New_York", "EST5EDT,M3.2.0,M11.1.0"},
        {"America/Chicago", "CST6CDT,M3.2.0,M11.1.0"},
        {"America/Denver", "MST7MDT,M3.2.0,M11.1.0"},
        {"America/Los_Angeles", "PST8PDT,M3.2.0,M11.1.0"},
        {"America/Anchorage", "AKST9AKDT,M3.2.0,M11.1.0"},
        {"America/Phoenix", "MST7"},
        {"America/Toronto", "EST5EDT,M3.2.0,M11.1.0"},
        {"America/Vancouver", "PST8PDT,M3.2.0,M11.1.0"},
        {"America/Mexico_City", "CST6"},
        {"America/Sao_Paulo", "<-03>3"},
        {"America/Buenos_Aires", "<-03>3"},
        {"Asia/Tokyo", "JST-9"},
        {"Asia/Seoul", "KST-9"},
        {"Asia/Shanghai", "CST-8"},
        {"Asia/Hong_Kong", "HKT-8"},
        {"Asia/Singapore", "SGT-8"},
        {"Asia/Bangkok", "ICT-7"},
        {"Asia/Dubai", "GST-4"},
        {"Asia/Kolkata", "IST-5:30"},
        {"Asia/Jakarta", "WIB-7"},
        {"Australia/Sydney", "AEST-10AEDT,M10.1.0,M4.1.0/3"},
        {"Australia/Melbourne", "AEST-10AEDT,M10.1.0,M4.1.0/3"},
        {"Australia/Perth", "AWST-8"},
        {"Pacific/Auckland", "NZST-12NZDT,M9.5.0,M4.1.0/3"},
        {"Pacific/Honolulu", "HST10"},
        {"Africa/Cairo", "EET-2EEST,M4.5.5/0,M10.5.4/24"},
        {"Africa/Johannesburg", "SAST-2"},
        {"UTC", "UTC0"},
    };

    constexpr int TIMEZONES_COUNT = sizeof(TIMEZONES) / sizeof(TIMEZONES[0]);

    /**
     * @brief Sync-Intervall-Stufen: Millisekunden und i18n-Label-Schlüssel.
     *
     * Reihenfolge von lang nach kurz, damit die Standardwahl oben liegt und die kurzen Werte am Ende warnend stehen.
     */
    struct SyncIntervalEntry
    {
        unsigned long ms;
        SettingsKey labelKey;
    };

    const SyncIntervalEntry SYNC_INTERVALS[] = {
        {86400000UL, SettingsKey::SETTINGS_TIME_SYNC_24H},
        {43200000UL, SettingsKey::SETTINGS_TIME_SYNC_12H},
        {21600000UL, SettingsKey::SETTINGS_TIME_SYNC_6H},
        {10800000UL, SettingsKey::SETTINGS_TIME_SYNC_3H},
        {3600000UL, SettingsKey::SETTINGS_TIME_SYNC_1H},
        {1800000UL, SettingsKey::SETTINGS_TIME_SYNC_30M},
        {600000UL, SettingsKey::SETTINGS_TIME_SYNC_10M},
        {60000UL, SettingsKey::SETTINGS_TIME_SYNC_1M},
    };

    constexpr int SYNC_INTERVALS_COUNT = sizeof(SYNC_INTERVALS) / sizeof(SYNC_INTERVALS[0]);

    /**
     * @brief Sucht den Index eines POSIX-Zeitzonen-Strings in TIMEZONES.
     * @return -1 wenn nicht gefunden
     */
    int findTimezoneIndex(const char *region)
    {
        if (!region || !*region)
            return -1;
        for (int i = 0; i < TIMEZONES_COUNT; ++i)
        {
            if (strcmp(region, TIMEZONES[i].region) == 0)
                return i;
        }
        return -1;
    }

    /**
     * @brief Sucht den Index eines Sync-Intervalls in SYNC_INTERVALS.
     * @return Index der nächstliegenden Stufe; mindestens 0, höchstens letzte Position
     */
    int findSyncIntervalIndex(unsigned long ms)
    {
        for (int i = 0; i < SYNC_INTERVALS_COUNT; ++i)
        {
            if (SYNC_INTERVALS[i].ms == ms)
                return i;
        }
        return 4; // Default: 1 Stunde
    }

    /**
     * @brief Liefert die Anzahl Tage in einem Monat (gregorianisch, mit Schaltjahr).
     */
    int daysInMonth(int year, int month)
    {
        switch (month)
        {
        case 1:
        case 3:
        case 5:
        case 7:
        case 8:
        case 10:
        case 12:
            return 31;
        case 4:
        case 6:
        case 9:
        case 11:
            return 30;
        case 2:
        {
            const bool leap = (year % 4 == 0 && year % 100 != 0) || (year % 400 == 0);
            return leap ? 29 : 28;
        }
        default:
            return 30;
        }
    }

    // Felder im Schrittgeberblock. Die Reihenfolge in der Spalte ist sprachabhängig: Deutsch zeigt Tag-Monat-Jahr, Englisch zeigt Jahr-Monat-Tag.
    constexpr int FIELD_YEAR = 0;
    constexpr int FIELD_MONTH = 1;
    constexpr int FIELD_DAY = 2;
    constexpr int FIELD_HOUR = 3;
    constexpr int FIELD_MINUTE = 4;
    constexpr int FIELD_COUNT = 5;

    /**
     * @brief Liefert das Feld, das in einer Spalte angezeigt wird.
     *
     * Die ersten drei Spalten (Datum) folgen der Sprache: DE = Tag/Monat/Jahr, EN = Jahr/Monat/Tag. Stunde und Minute bleiben in beiden Sprachen rechts.
     */
    int stepperColToField(int col)
    {
        const bool german = (I18n::currentLang() == LangIndex::DE);
        if (german)
        {
            switch (col)
            {
            case 0:
                return FIELD_DAY;
            case 1:
                return FIELD_MONTH;
            case 2:
                return FIELD_YEAR;
            case 3:
                return FIELD_HOUR;
            case 4:
                return FIELD_MINUTE;
            }
        }
        else
        {
            switch (col)
            {
            case 0:
                return FIELD_YEAR;
            case 1:
                return FIELD_MONTH;
            case 2:
                return FIELD_DAY;
            case 3:
                return FIELD_HOUR;
            case 4:
                return FIELD_MINUTE;
            }
        }
        return FIELD_YEAR;
    }

    // Geocoding (Nominatim/OpenStreetMap) für die PLZ-Auflösung
    constexpr int GEOCODE_CITY_BUF = 64;         ///< Puffergröße für den Ortsnamen
    constexpr int GEOCODE_URL_BUF = 192;         ///< Puffergröße für die Such-URL
    constexpr int GEOCODE_JSON_DOC_BYTES = 8192; ///< Größe des JSON-Dokuments
    constexpr double DE_BBOX_LAT_MIN = 47.2;     ///< Untere Breite der Deutschland-Box
    constexpr double DE_BBOX_LAT_MAX = 55.1;     ///< Obere Breite der Deutschland-Box
    constexpr double DE_BBOX_LON_MIN = 5.8;      ///< Westliche Länge der Deutschland-Box
    constexpr double DE_BBOX_LON_MAX = 15.1;     ///< Östliche Länge der Deutschland-Box

    /**
     * @brief Tabelle: Bundesland-Name aus der Nominatim-Antwort -> Region-ID (1..16).
     *
     * Enthält die Primärnamen sowie die Varianten, die Nominatim häufig liefert ("Land X", "Freistaat X", Schreibweisen ohne Bindestrich). Die Zuordnung muss mit der Weboberfläche übereinstimmen.
     */
    struct StateRegionEntry
    {
        const char *name;
        int region;
    };

    const StateRegionEntry STATE_REGION_MAP[] = {
        // Primärnamen
        {"Baden-Württemberg", 1},
        {"Bayern", 2},
        {"Berlin", 3},
        {"Brandenburg", 4},
        {"Bremen", 5},
        {"Hamburg", 6},
        {"Hessen", 7},
        {"Mecklenburg-Vorpommern", 8},
        {"Niedersachsen", 9},
        {"Nordrhein-Westfalen", 10},
        {"Rheinland-Pfalz", 11},
        {"Saarland", 12},
        {"Sachsen", 13},
        {"Sachsen-Anhalt", 14},
        {"Schleswig-Holstein", 15},
        {"Thüringen", 16},
        // Nominatim-Varianten
        {"Land Berlin", 3},
        {"Land Brandenburg", 4},
        {"Freistaat Bayern", 2},
        {"Freistaat Sachsen", 13},
        {"Freistaat Thüringen", 16},
        {"Hansestadt Hamburg", 6},
        {"Freie Hansestadt Bremen", 5},
        {"Nordrhein Westfalen", 10},
        {"Rheinland Pfalz", 11},
    };

    /**
     * @brief Liefert die Nachrichten-Region (1..16) zu einem Bundesland-Namen.
     * @return 0, wenn der Name nicht in der Mapping-Tabelle steht.
     */
    int stateNameToRegion(const char *name)
    {
        if (!name || !*name)
            return 0;
        for (const auto &e : STATE_REGION_MAP)
        {
            if (strcmp(name, e.name) == 0)
                return e.region;
        }
        return 0;
    }

    // News-Panel: Layout der Ressort-Chips und des Bundesland-Selektors
    constexpr int NEWS_CHIP_H = 40;       ///< Höhe eines Ressort-Chips
    constexpr int NEWS_CHIP_GAP_X = 8;    ///< Horizontaler Abstand zwischen Chips
    constexpr int NEWS_CHIP_GAP_Y = 8;    ///< Vertikaler Abstand zwischen Chip-Reihen
    constexpr int NEWS_CHIPS_PER_ROW = 4; ///< Chips pro Reihe
    constexpr int NEWS_RESSORT_COUNT = 8; ///< Anzahl Ressort-Chips
    constexpr int NEWS_SELECTOR_H = 44;   ///< Höhe des Bundesland-Wahlknopfes

    // Listen-Picker (Modal, zentriert über dem Hauptlayout)
    constexpr int PICK_W = 460; ///< Breite des Picker-Rahmens
    constexpr int PICK_H = 400; ///< Höhe des Picker-Rahmens
    constexpr int PICK_X = (SCREEN_W - PICK_W) / 2;
    constexpr int PICK_Y = (SCREEN_H - PICK_H) / 2;
    constexpr int PICK_R = 12;                   ///< Eckradius des Rahmens
    constexpr int PICK_PADDING = 16;             ///< Innenabstand
    constexpr int PICK_TITLE_H = 36;             ///< Höhe der Titelzeile
    constexpr int PICK_CANCEL_H = 44;            ///< Höhe des Abbruch-Knopfes
    constexpr int PICK_ITEM_H = 36;              ///< Höhe eines Listeneintrags
    constexpr int PICK_ITEM_GAP = 2;             ///< Abstand zwischen Listeneinträgen
    constexpr int PICK_DRAG_THRESH = 5;          ///< Pixel-Schwelle: Tipp vs. Wisch
    constexpr uint16_t C_PICK_BG = 0x18C3;       ///< Hintergrund des Pickers
    constexpr uint16_t C_PICK_BORDER = 0x39E8;   ///< Rahmen des Pickers
    constexpr uint16_t C_PICK_ITEM_BG = 0x0000;  ///< Eintrag im Normalzustand
    constexpr uint16_t C_PICK_ITEM_SEL = 0x2945; ///< Eintrag im gewählten Zustand

    /**
     * @brief Tabelle der Ressort-Werte und ihrer Anzeigetexte.
     *
     * Erste Spalte ist der String, der in AppState landet (leer = kein Filter).
     */
    struct NewsRessortEntry
    {
        const char *value;
        SettingsKey labelKey;
    };

    const NewsRessortEntry NEWS_RESSORTS[NEWS_RESSORT_COUNT] = {
        {"", SettingsKey::SETTINGS_NEWS_RESSORT_ALL},
        {"inland", SettingsKey::SETTINGS_NEWS_RESSORT_INLAND},
        {"ausland", SettingsKey::SETTINGS_NEWS_RESSORT_AUSLAND},
        {"wirtschaft", SettingsKey::SETTINGS_NEWS_RESSORT_WIRTSCHAFT},
        {"sport", SettingsKey::SETTINGS_NEWS_RESSORT_SPORT},
        {"video", SettingsKey::SETTINGS_NEWS_RESSORT_VIDEO},
        {"investigativ", SettingsKey::SETTINGS_NEWS_RESSORT_INVESTIGATIV},
        {"wissen", SettingsKey::SETTINGS_NEWS_RESSORT_WISSEN},
    };

    /**
     * @brief Liefert den Anzeige-Key für eine Bundesland-ID (1..16).
     *
     * Bei ungültiger ID fällt die Funktion auf Brandenburg zurück.
     */
    SettingsKey newsRegionKey(int region)
    {
        switch (region)
        {
        case 1:
            return SettingsKey::SETTINGS_NEWS_BL_BW;
        case 2:
            return SettingsKey::SETTINGS_NEWS_BL_BY;
        case 3:
            return SettingsKey::SETTINGS_NEWS_BL_BE;
        case 4:
            return SettingsKey::SETTINGS_NEWS_BL_BB;
        case 5:
            return SettingsKey::SETTINGS_NEWS_BL_HB;
        case 6:
            return SettingsKey::SETTINGS_NEWS_BL_HH;
        case 7:
            return SettingsKey::SETTINGS_NEWS_BL_HE;
        case 8:
            return SettingsKey::SETTINGS_NEWS_BL_MV;
        case 9:
            return SettingsKey::SETTINGS_NEWS_BL_NI;
        case 10:
            return SettingsKey::SETTINGS_NEWS_BL_NW;
        case 11:
            return SettingsKey::SETTINGS_NEWS_BL_RP;
        case 12:
            return SettingsKey::SETTINGS_NEWS_BL_SL;
        case 13:
            return SettingsKey::SETTINGS_NEWS_BL_SN;
        case 14:
            return SettingsKey::SETTINGS_NEWS_BL_ST;
        case 15:
            return SettingsKey::SETTINGS_NEWS_BL_SH;
        case 16:
            return SettingsKey::SETTINGS_NEWS_BL_TH;
        default:
            return SettingsKey::SETTINGS_NEWS_BL_BB;
        }
    }

    /** @brief Prüft, ob ein Punkt in einem Rechteck liegt. */
    bool pointIn(int px, int py, int x, int y, int w, int h)
    {
        return px >= x && px < x + w && py >= y && py < y + h;
    }
} // namespace

// ===================================================================
// Statische Menüliste
// ===================================================================

// Reihenfolge bestimmt die Anzeige von oben nach unten.
const Settings::MenuEntry Settings::s_menu[] = {
    {EntryType::SECTION_HEADER, Section::CONNECTION, Panel::WIFI, SettingsKey::SETTINGS_SEC_CONNECTION},
    {EntryType::PANEL_ITEM, Section::CONNECTION, Panel::WIFI, SettingsKey::SETTINGS_MENU_WIFI},
    {EntryType::PANEL_ITEM, Section::CONNECTION, Panel::TIME, SettingsKey::SETTINGS_MENU_TIME},
    {EntryType::PANEL_ITEM, Section::CONNECTION, Panel::TIME_WINDOW, SettingsKey::SETTINGS_MENU_TIME_WINDOW},

    {EntryType::SECTION_HEADER, Section::SERVICES, Panel::WEATHER, SettingsKey::SETTINGS_SEC_SERVICES},
    {EntryType::PANEL_ITEM, Section::SERVICES, Panel::WEATHER, SettingsKey::SETTINGS_MENU_WEATHER},
    {EntryType::PANEL_ITEM, Section::SERVICES, Panel::NEWS, SettingsKey::SETTINGS_MENU_NEWS},
    {EntryType::PANEL_ITEM, Section::SERVICES, Panel::CLOUD, SettingsKey::SETTINGS_MENU_CLOUD},

    {EntryType::SECTION_HEADER, Section::SYSTEM, Panel::GENERAL, SettingsKey::SETTINGS_SEC_SYSTEM},
    {EntryType::PANEL_ITEM, Section::SYSTEM, Panel::GENERAL, SettingsKey::SETTINGS_MENU_GENERAL},
    {EntryType::PANEL_ITEM, Section::SYSTEM, Panel::SECURITY, SettingsKey::SETTINGS_MENU_SECURITY},
    {EntryType::PANEL_ITEM, Section::SYSTEM, Panel::AUDIO, SettingsKey::SETTINGS_MENU_AUDIO},
    {EntryType::PANEL_ITEM, Section::SYSTEM, Panel::APPEARANCE, SettingsKey::SETTINGS_MENU_APPEARANCE},
    {EntryType::PANEL_ITEM, Section::SYSTEM, Panel::INFO, SettingsKey::SETTINGS_MENU_INFO},
};

const int Settings::s_menuCount = sizeof(Settings::s_menu) / sizeof(Settings::s_menu[0]);

// ===================================================================
// Lebenszyklus
// ===================================================================

/**
 * @brief Konstruktor, setzt alle Profile auf leer.
 */
Settings::Settings()
{
    for (auto &p : m_profiles)
    {
        p.ssid[0] = '\0';
        p.password[0] = '\0';
        p.enabled = false;
        p.modified = false;
        p.tested_ok = false;
    }
    for (auto &b : m_baseline)
    {
        b.ssid[0] = '\0';
        b.password[0] = '\0';
        b.enabled = false;
    }
    m_newsRessort[0] = '\0';
    m_newsRessortBaseline[0] = '\0';
    m_newsRegion = 4;
    m_newsRegionBaseline = 4;
    m_plzEntry[0] = '\0';
    m_plzBaseline[0] = '\0';
    m_plzLen = 0;
    m_cloudCalendarUrl[0] = '\0';
    m_cloudTodoUrl[0] = '\0';
    m_cloudContactsUrl[0] = '\0';
    m_cloudOpenSkyClientId[0] = '\0';
    m_cloudOpenSkyClientSecret[0] = '\0';
    m_cloudCalendarBaseline[0] = '\0';
    m_cloudTodoBaseline[0] = '\0';
    m_cloudContactsBaseline[0] = '\0';
    m_cloudOpenSkyClientIdBaseline[0] = '\0';
    m_cloudOpenSkyClientSecretBaseline[0] = '\0';
    m_cloudValuesVisible = false;
    m_tzIndex = -1;
    m_tzBaseline = -1;
    m_ntpServer[0] = '\0';
    m_ntpServerBaseline[0] = '\0';
    m_syncIntervalMs = 3600000UL;
    m_syncIntervalBaselineMs = 3600000UL;
    m_manualYear = 2025;
    m_manualMonth = 1;
    m_manualDay = 1;
    m_manualHour = 12;
    m_manualMinute = 0;
    m_manualInit = false;
    for (int day = 0; day < TIME_WINDOW_DAYS; ++day)
    {
        for (int hour = 0; hour < TIME_WINDOW_HOURS; ++hour)
            m_timeWindow[day][hour] = true;
        m_timeWindowBaselineMasks[day] = TIME_WINDOW_FULL_MASK;
    }
}

/**
 * @brief Destruktor, gibt Dialoge und Sprites frei.
 */
Settings::~Settings()
{
    // Beim Verlassen die Soundausgabe stoppen, damit kein inaktives Modul Ton hält
    if (m_callbacks.requestStopPlayback)
        m_callbacks.requestStopPlayback();
    m_previewPlaying = false;
    applySpeakerOutput(APP_STATE.getSpeakersEnabled());

    m_activeMessageBox.reset();
    m_activeProgressBox.reset();
    deleteSprites();
}

/**
 * @brief Initialisiert das Modul, lädt Profile und erstellt die Sprites.
 */
bool Settings::init(LGFX &tft, const SettingsCallbacks &callbacks)
{
    m_tft = &tft;
    m_callbacks = callbacks;

    // Profile aus AppState laden
    for (int i = 0; i < MAX_PROFILES; ++i)
    {
        char ssid[65] = {0};
        char password[65] = {0};
        if (APP_STATE.getWiFiProfile(i, ssid, sizeof(ssid), password, sizeof(password)))
        {
            stringutils::safeCopy(m_profiles[i].ssid, ssid);
            stringutils::safeCopy(m_profiles[i].password, password);
            m_profiles[i].enabled = APP_STATE.isWiFiProfileEnabled(i);
        }
        else
        {
            m_profiles[i].ssid[0] = '\0';
            m_profiles[i].password[0] = '\0';
            m_profiles[i].enabled = false;
        }
        m_profiles[i].modified = false;
        m_profiles[i].tested_ok = false;
    }

    // Geräte-Netzwerkname aus AppState laden, Baseline = aktueller Wert
    stringutils::safeCopy(m_hostname, APP_STATE.getHostname());
    stringutils::safeCopy(m_hostnameBaseline, m_hostname);

    // News-Filter aus AppState laden, Baseline = aktueller Wert
    stringutils::safeCopy(m_newsRessort, APP_STATE.getNewsRessort());
    stringutils::safeCopy(m_newsRessortBaseline, m_newsRessort);
    m_newsRegion = APP_STATE.getNewsRegion();
    if (m_newsRegion < 1 || m_newsRegion > 16)
        m_newsRegion = 4;
    m_newsRegionBaseline = m_newsRegion;

    // Postleitzahl aus AppState laden, Baseline = aktueller Wert
    stringutils::safeCopy(m_plzEntry, APP_STATE.getPlz());
    stringutils::safeCopy(m_plzBaseline, m_plzEntry);
    m_plzLen = static_cast<int>(strlen(m_plzEntry));
    if (m_plzLen > 5)
        m_plzLen = 5;

    // Cloud-Anbindung aus AppState laden, Baselines = aktueller Stand
    stringutils::safeCopy(m_cloudCalendarUrl, APP_STATE.getCalendarScriptUrl());
    stringutils::safeCopy(m_cloudTodoUrl, APP_STATE.getTodoScriptUrl());
    stringutils::safeCopy(m_cloudContactsUrl, APP_STATE.getContactsScriptUrl());
    stringutils::safeCopy(m_cloudOpenSkyClientId, APP_STATE.getOpenSkyClientId());
    stringutils::safeCopy(m_cloudOpenSkyClientSecret, APP_STATE.getOpenSkyClientSecret());
    stringutils::safeCopy(m_cloudCalendarBaseline, m_cloudCalendarUrl);
    stringutils::safeCopy(m_cloudTodoBaseline, m_cloudTodoUrl);
    stringutils::safeCopy(m_cloudContactsBaseline, m_cloudContactsUrl);
    stringutils::safeCopy(m_cloudOpenSkyClientIdBaseline, m_cloudOpenSkyClientId);
    stringutils::safeCopy(m_cloudOpenSkyClientSecretBaseline, m_cloudOpenSkyClientSecret);

    // Zeit-Einstellungen aus AppState übernehmen und Baselines setzen
    m_tzIndex = findTimezoneIndex(APP_STATE.getTimezoneRegion());
    m_tzBaseline = m_tzIndex;
    stringutils::safeCopy(m_ntpServer, APP_STATE.getNtpServer());
    stringutils::safeCopy(m_ntpServerBaseline, m_ntpServer);
    m_syncIntervalMs = APP_STATE.getNtpSyncInterval();
    if (m_syncIntervalMs < 60000UL)
        m_syncIntervalMs = 60000UL;
    m_syncIntervalBaselineMs = m_syncIntervalMs;
    m_manualInit = false;

    // Zeitfenster aus AppState laden, Baseline = aktueller Stand
    loadTimeWindowFromAppState();

    // Klangregelung: Eckfrequenzen aus AppState laden, Baselines = aktueller Stand
    m_eqFreqLow = APP_STATE.getEqFreqLow();
    m_eqFreqPeak = APP_STATE.getEqFreqPeak();
    m_eqFreqHigh = APP_STATE.getEqFreqHigh();
    m_stereoWidth = APP_STATE.getStereoWidth();
    m_loudness = APP_STATE.getLoudness();
    m_speakersEnabled = APP_STATE.getSpeakersEnabled();
    m_eqFreqLowBaseline = m_eqFreqLow;
    m_eqFreqPeakBaseline = m_eqFreqPeak;
    m_eqFreqHighBaseline = m_eqFreqHigh;
    m_stereoWidthBaseline = m_stereoWidth;
    m_loudnessBaseline = m_loudness;
    m_speakersEnabledBaseline = m_speakersEnabled;

    // Anzeige: Stil des magischen Auges aus AppState laden, Baseline = aktueller Stand
    m_magicEyeStyle = APP_STATE.getMagicEyeStyle();
    if (m_magicEyeStyle > APPEARANCE_EYE_MAX)
        m_magicEyeStyle = APPEARANCE_EYE_MIN;
    m_magicEyeStyleBaseline = m_magicEyeStyle;

    // Anzeige: Trägheit des VU-Zeigers aus AppState laden, Baseline = aktueller Stand
    m_vuBallistics = APP_STATE.getVuBallistics();
    if (m_vuBallistics > APPEARANCE_VU_MAX)
        m_vuBallistics = APPEARANCE_VU_MIN;
    m_vuBallisticsBaseline = m_vuBallistics;

    // Anzeige: Empfindlichkeit des VU aus AppState laden, Baseline = aktueller Stand
    m_vuSensitivity = APP_STATE.getVuSensitivity();
    if (m_vuSensitivity > APPEARANCE_SENS_MAX)
        m_vuSensitivity = APPEARANCE_SENS_MIN;
    m_vuSensitivityBaseline = m_vuSensitivity;

    snapshotBaseline();
    recomputeDirtyFlags();

    if (!createSprites())
    {
        LOG_ERROR("Settings: Sprite-Erzeugung fehlgeschlagen");
        return false;
    }

    initButtons();

    m_panel = Panel::WIFI;
    m_selWifi = 0;
    resetPinEntry();

    m_tft->clear(C_BG);
    m_state = State::IDLE;
    m_testState = TestState::NOT_TESTING;

    invalidateAll();

    m_requireTouchRelease = true;
    m_touchBlockUntil = millis() + 150;
    m_touchProcessed = false;

    m_lastObservedWifi = APP_STATE.getWifiConnected();

    m_initialized = true;
    LOG_SUCCESS("Settings-Modul initialisiert");
    return true;
}

/**
 * @brief Gibt den Modultyp zurück.
 */
AppModule Settings::type() const
{
    return AppModule::SETTINGS;
}

/**
 * @brief Erstellt die PSRAM-Sprites für Menü und Arbeitsbereich.
 */
bool Settings::createSprites()
{
    if (!m_tft)
        return false;

    if (!m_tft->safeCreateSprite(m_menuSprite, MENU_W, MENU_SPRITE_H))
    {
        deleteSprites();
        return false;
    }
    if (!m_tft->safeCreateSprite(m_scrollbarSprite, SCROLLBAR_W, MENU_SPRITE_H))
    {
        deleteSprites();
        return false;
    }
    if (!m_tft->safeCreateSprite(m_workSprite, WORK_W, WORK_H))
    {
        deleteSprites();
        return false;
    }
    if (!m_tft->safeCreateSprite(m_clockSprite, CLOCK_W, CLOCK_H))
    {
        deleteSprites();
        return false;
    }
    if (!m_tft->safeCreateSprite(m_audioVolSprite, AUDIO_FT_DISP_W, AUDIO_FT_DISP_H))
        LOG_WARNING("Settings: Lautstärke-Sprite konnte nicht erstellt werden");

    m_menuSprite->clear(C_BG);
    m_scrollbarSprite->clear(C_SCROLLBAR_TRACK);
    m_workSprite->clear(C_BG);
    m_clockSprite->clear(C_BG);
    return true;
}

/**
 * @brief Gibt die Sprites frei.
 */
void Settings::deleteSprites()
{
    if (!m_tft)
        return;

    m_tft->safeDeleteSprite(m_menuSprite);
    m_tft->safeDeleteSprite(m_scrollbarSprite);
    m_tft->safeDeleteSprite(m_workSprite);
    m_tft->safeDeleteSprite(m_clockSprite);
    m_tft->safeDeleteSprite(m_audioVolSprite);
}

/**
 * @brief Initialisiert einen ins Work-Sprite zeichnenden Werkzeug-Button.
 * @param btn Zu initialisierender Button
 * @param spriteRect Geometrie sprite-relativ (Ursprung = Work-Sprite oben links)
 */
void Settings::initToolButton(Button &btn, const Rect &spriteRect)
{
    const int cx = WORK_X + spriteRect.x + spriteRect.w / 2;
    const int cy = WORK_Y + spriteRect.y + spriteRect.h / 2;
    btn.initButton(m_tft, cx, cy, spriteRect.w, spriteRect.h, BTN_R,
                   BTN_OUTLINE, BTN_FILL, BTN_TEXT, "", nullptr);
    btn.setFont(LeagueGothicCond34);
    btn.setDrawTarget(m_workSprite, WORK_X, WORK_Y);
}

/**
 * @brief Initialisiert die Fußzeilen- und Werkzeug-Buttons.
 */
void Settings::initButtons()
{
    m_exitButton.initButton(
        m_tft,
        EXIT_BTN_CX, EXIT_BTN_CY,
        EXIT_BTN_SIZE, EXIT_BTN_SIZE,
        BTN_R,
        BTN_OUTLINE,
        BTN_FILL,
        uint16_t(TFT_DARKGREY),
        Button::HOME_LABEL,
        nullptr);
    m_exitButton.setFont(ComfortaaBold30);

    m_saveButton.initButton(
        m_tft,
        SAVE_BTN_CX, FOOTER_CY,
        SAVE_BTN_W, BTN_H,
        BTN_R,
        BTN_OUTLINE,
        BTN_FILL,
        BTN_TEXT,
        "",
        nullptr);
    m_saveButton.setFont(LeagueGothicCond34);

    initToolButton(m_btnScan, wifiActionRect(0));
    initToolButton(m_btnPassword, wifiActionRect(1));
    initToolButton(m_btnTest, wifiActionRect(2));
    initToolButton(m_btnDelete, wifiActionRect(3));
    initToolButton(m_cloudVisibilityButton, cloudVisibilityButtonRect());
    // Info-Knöpfe liegen im Footer und zeichnen direkt aufs Display.
    {
        const Rect r = footerInfoButtonRect(0);
        m_btnRestart.initButton(m_tft,
                                r.x + r.w / 2, r.y + r.h / 2,
                                r.w, r.h, BTN_R,
                                BTN_OUTLINE, BTN_FILL, BTN_TEXT,
                                "", nullptr);
        m_btnRestart.setFont(LeagueGothicCond34);
    }
    {
        const Rect r = footerInfoButtonRect(1);
        m_btnReset.initButton(m_tft,
                              r.x + r.w / 2, r.y + r.h / 2,
                              r.w, r.h, BTN_R,
                              BTN_OUTLINE, BTN_FILL, BTN_TEXT,
                              "", nullptr);
        m_btnReset.setFont(LeagueGothicCond34);
    }

    // Klang-Footer: Hörprobe-Knopf und Lautstärke-Knöpfe (Icon-Beschriftung)
    m_audioPlayBtn.initButton(m_tft,
                              AUDIO_FT_PLAY_CX, FOOTER_CY,
                              AUDIO_FT_BTN_SIZE, AUDIO_FT_BTN_SIZE, AUDIO_FT_BTN_R,
                              BTN_OUTLINE, BTN_FILL, BTN_TEXT,
                              "^PLAY:32:5C44^", nullptr);
    m_audioPlayBtn.setFont(ComfortaaBold30);

    m_audioVolDownBtn.initButton(m_tft,
                                 AUDIO_FT_VDOWN_CX, FOOTER_CY,
                                 AUDIO_FT_BTN_SIZE, AUDIO_FT_BTN_SIZE, AUDIO_FT_BTN_R,
                                 BTN_OUTLINE, BTN_FILL, BTN_TEXT,
                                 "^MINUS:32:7BEF^", nullptr);
    m_audioVolDownBtn.setFont(ComfortaaBold30);

    m_audioVolUpBtn.initButton(m_tft,
                               AUDIO_FT_VUP_CX, FOOTER_CY,
                               AUDIO_FT_BTN_SIZE, AUDIO_FT_BTN_SIZE, AUDIO_FT_BTN_R,
                               BTN_OUTLINE, BTN_FILL, BTN_TEXT,
                               "^PLUS:32:7BEF^", nullptr);
    m_audioVolUpBtn.setFont(ComfortaaBold30);

    m_audioVolDots.init(AUDIO_FT_DOT_W, AUDIO_FT_DOT_H, AUDIO_FT_DOT_SPACE, AUDIO_FT_CHAR_SPACE);
    m_audioVolDots.setOnColor(0x7BEF, TFT_BLACK);
    m_audioVolDots.setOffColor(0x2104, TFT_BLACK);
    m_audioVolDots.setBackgroundColor(TFT_BLACK);
    m_audioVolDots.setShowOffDots(true);
    m_audioVolDots.setGradientEnabled(false);
    m_audioVolDots.setDotShape(DotMatrix::DotShape::SQUARE);
    m_audioVolDots.reserveText(4);
}

// ===================================================================
// Zeichensteuerung
// ===================================================================

/**
 * @brief Markiert alle Bereiche zum Neuzeichnen.
 */
void Settings::invalidateAll()
{
    m_menuDirty = true;
    m_workDirty = true;
    m_footerDirty = true;
    m_numpadLayoutValid = false;
}

/**
 * @brief Vollredraw nach Sprachwechsel oder Dialog.
 */
void Settings::redrawAll()
{
    if (m_tft)
        m_tft->clear(C_BG);
    invalidateAll();
}

/**
 * @brief Setzt den UI-Zustand nach einem modalen Dialog zurück.
 */
void Settings::afterModalRedraw()
{
    I18n::consumeLanguageChanged();
    redrawAll();
    m_lastDrawnSecond = -1;
    m_requireTouchRelease = true;
    m_touchBlockUntil = millis() + 150;
    m_touchProcessed = false;
}

/**
 * @brief Zyklische Update- und Zeichenfunktion.
 */
void Settings::draw()
{
    if (!m_initialized)
        return;

    if (m_state == State::IDLE && I18n::consumeLanguageChanged())
        redrawAll();

    switch (m_state)
    {
    case State::TESTING:
        updateTestingState();
        break;
    case State::SHOWING_MESSAGE:
        updateMessageState();
        break;
    case State::SAVING:
        updateSavingState();
        break;
    case State::IDLE:
    default:
        break;
    }

    if (handleDeferredActions())
        return; // Modul kann nach Exit/Restart bereits abgebaut sein

    if (m_state == State::IDLE)
    {
        // Wenn der WLAN-Zustand sich ändert, das Wetter-Panel auffrischen (steuert die Sichtbarkeit der dezenten Hinweiszeile)
        const bool wifiNow = APP_STATE.getWifiConnected();
        if (wifiNow != m_lastObservedWifi)
        {
            m_lastObservedWifi = wifiNow;
            if (m_panel == Panel::WEATHER)
                m_workDirty = true;
        }

        // Info-Panel zeigt laufende Werte (Uptime, Heap, Signal, Sync). Alle zwei Sekunden neu zeichnen lassen, solange das Panel sichtbar ist.
        if (m_panel == Panel::INFO)
        {
            const unsigned long now = millis();
            if (now - m_lastInfoRefreshMs >= 2000UL)
            {
                m_lastInfoRefreshMs = now;
                m_workDirty = true;
            }
        }

        if (m_panel == Panel::SECURITY && m_displayedPinLock != APP_STATE.isPinLockEnabled())
        {
            m_confirmPinDisable = false;
            resetPinEntry();
            m_workDirty = true;
        }

        if (m_panel == Panel::TIME && m_displayedSecondHandSweep != APP_STATE.getSecondHandSweep())
            m_workDirty = true;

        if (m_menuDirty)
        {
            drawMenu();
            drawScrollbar();
        }
        if (m_workDirty)
            drawWorkPanel();
        if (m_footerDirty)
            drawFooter();

        // Die Anzeigeseite zeigt den Senderpegel laufend mit; das geht nur nach dem Panel,
        // weil ein Neuzeichnen des Panels die Zahl sonst wieder überdecken würde.
        drawAppearanceLevel();

        handleTouch();
    }

    drawClock();
}

// ===================================================================
// Menü zeichnen
// ===================================================================

/**
 * @brief Liefert die Akzentfarbe einer Sektion.
 */
uint16_t Settings::sectionColor(Section s) const
{
    switch (s)
    {
    case Section::CONNECTION:
        return C_SEC_CONNECTION;
    case Section::SERVICES:
        return C_SEC_SERVICES;
    case Section::SYSTEM:
    default:
        return C_SEC_SYSTEM;
    }
}

/**
 * @brief Y-Position eines Menü-Eintrags (sprite-relativ).
 */
int Settings::menuEntryY(int index) const
{
    int y = 0;
    for (int i = 0; i < index && i < s_menuCount; ++i)
        y += (s_menu[i].type == EntryType::SECTION_HEADER) ? SECTION_ROW_H : ITEM_ROW_H;
    return y;
}

/**
 * @brief Liefert das Panel an einer Menü-Y-Position oder -1.
 */
int Settings::menuEntryAtY(int y) const
{
    const int contentY = y + m_scrollOffset;
    for (int i = 0; i < s_menuCount; ++i)
    {
        const int rowY = menuEntryY(i);
        const int rowH = (s_menu[i].type == EntryType::SECTION_HEADER) ? SECTION_ROW_H : ITEM_ROW_H;
        if (contentY >= rowY && contentY < rowY + rowH)
        {
            if (s_menu[i].type == EntryType::PANEL_ITEM)
                return static_cast<int>(s_menu[i].panel);
            return -1;
        }
    }
    return -1;
}

/**
 * @brief Gesamthöhe der Menüliste in Pixeln.
 */
int Settings::getTotalListHeight() const
{
    int h = 0;
    for (int i = 0; i < s_menuCount; ++i)
        h += (s_menu[i].type == EntryType::SECTION_HEADER) ? SECTION_ROW_H : ITEM_ROW_H;
    return h;
}

/**
 * @brief Zeichnet die gesamte Menüliste und pusht sie.
 */
void Settings::drawMenu()
{
    if (!m_menuSprite)
        return;

    m_menuSprite->clear(C_BG);
    m_menuSprite->loadFont(ComfortaaBold16);

    for (int i = 0; i < s_menuCount; ++i)
    {
        const MenuEntry &e = s_menu[i];
        const int rowH = (e.type == EntryType::SECTION_HEADER) ? SECTION_ROW_H : ITEM_ROW_H;
        const int y = menuEntryY(i) - m_scrollOffset;

        if (y + rowH <= 0 || y >= MENU_SPRITE_H)
            continue;

        const uint16_t catColor = sectionColor(e.section);

        if (e.type == EntryType::SECTION_HEADER)
        {
            const uint16_t tintColor = scaleColor(catColor, 0.45f);
            m_menuSprite->fillRect(0, y, MENU_W, rowH, tintColor);
            m_menuSprite->fillRect(0, y, ITEM_ACCENT_W, rowH, catColor);

            m_menuSprite->setTextDatum(ML_DATUM);
            m_menuSprite->setTextColor(C_SEC_HDR_TXT, tintColor);
            m_menuSprite->drawString(I18n::str(e.label), ITEM_TEXT_X, y + rowH / 2);
        }
        else
        {
            const bool selected = (e.panel == m_panel);
            const uint16_t selBg = scaleColor(catColor, 0.25f);
            if (selected)
                m_menuSprite->fillRect(0, y, MENU_W, rowH, selBg);

            const uint16_t accentCol = selected ? catColor : scaleColor(catColor, 0.45f);
            m_menuSprite->fillRect(0, y, ITEM_ACCENT_W, rowH, accentCol);

            m_menuSprite->setTextDatum(ML_DATUM);
            m_menuSprite->setTextColor(
                selected ? C_TEXT_BRIGHT : C_TEXT,
                selected ? selBg : C_BG);
            m_menuSprite->drawString(I18n::str(e.label), ITEM_TEXT_X, y + rowH / 2);

            m_menuSprite->drawFastHLine(ITEM_ACCENT_W, y + rowH - 1, MENU_W - ITEM_ACCENT_W, C_SEP_LINE);
        }
    }

    m_menuSprite->unloadFont();
    m_menuSprite->pushSprite(MENU_X, 0);
    m_menuDirty = false;
}

/**
 * @brief Zeichnet die Scrollbar und pusht sie.
 *
 * Passt die Inhaltshöhe in die Menühöhe, wird nur der Track gezeichnet. Sobald spätere Panels mehr Einträge bringen, erscheint zusätzlich der Thumb.
 */
void Settings::drawScrollbar()
{
    if (!m_scrollbarSprite)
        return;

    m_scrollbarSprite->clear(C_SCROLLBAR_TRACK);

    const int totalH = getTotalListHeight();
    const int maxScroll = (totalH > MENU_SPRITE_H) ? (totalH - MENU_SPRITE_H) : 0;
    if (maxScroll <= 0)
    {
        m_scrollbarSprite->pushSprite(SCROLLBAR_X, 0);
        return;
    }

    const float viewRatio = static_cast<float>(MENU_SPRITE_H) / static_cast<float>(totalH);
    int thumbH = static_cast<int>(MENU_SPRITE_H * viewRatio);
    if (thumbH < 20)
        thumbH = 20;

    int clamped = m_scrollOffset;
    if (clamped < 0)
        clamped = 0;
    if (clamped > maxScroll)
        clamped = maxScroll;

    const float scrollRatio = static_cast<float>(clamped) / static_cast<float>(maxScroll);
    const int thumbY = static_cast<int>(scrollRatio * (MENU_SPRITE_H - thumbH));

    m_scrollbarSprite->fillRoundRect(0, thumbY, SCROLLBAR_W, thumbH, 2, C_SCROLLBAR_NORMAL);
    m_scrollbarSprite->pushSprite(SCROLLBAR_X, 0);
}

// ===================================================================
// Arbeitsbereich zeichnen
// ===================================================================

/**
 * @brief Liefert den Titel-Schlüssel eines Panels.
 */
SettingsKey Settings::panelTitleKey(Panel p) const
{
    switch (p)
    {
    case Panel::WIFI:
        return SettingsKey::SETTINGS_WIFI_TITLE;
    case Panel::GENERAL:
        return SettingsKey::SETTINGS_GENERAL_TITLE;
    case Panel::SECURITY:
        return SettingsKey::SETTINGS_SEC_TITLE;
    case Panel::INFO:
        return SettingsKey::SETTINGS_INFO_TITLE;
    case Panel::TIME:
        return SettingsKey::SETTINGS_TIME_TITLE;
    case Panel::TIME_WINDOW:
        return SettingsKey::SETTINGS_TIME_WINDOW_TITLE;
    case Panel::WEATHER:
        return SettingsKey::SETTINGS_WEATHER_TITLE;
    case Panel::NEWS:
        return SettingsKey::SETTINGS_NEWS_TITLE;
    case Panel::CLOUD:
        return SettingsKey::SETTINGS_CLOUD_TITLE;
    case Panel::AUDIO:
        return SettingsKey::SETTINGS_AUDIO_TITLE;
    case Panel::APPEARANCE:
        return SettingsKey::SETTINGS_APPEARANCE_TITLE;
    default:
        return SettingsKey::SETTINGS_EMPTY;
    }
}

/**
 * @brief Liefert den Untertitel-Schlüssel eines Panels.
 */
SettingsKey Settings::panelSubtitleKey(Panel p) const
{
    switch (p)
    {
    case Panel::WIFI:
        return SettingsKey::SETTINGS_WIFI_SUBTITLE;
    case Panel::GENERAL:
        return SettingsKey::SETTINGS_GENERAL_SUBTITLE;
    case Panel::SECURITY:
        return SettingsKey::SETTINGS_SEC_SUBTITLE;
    case Panel::INFO:
        return SettingsKey::SETTINGS_INFO_SUBTITLE;
    case Panel::NEWS:
        return SettingsKey::SETTINGS_NEWS_SUBTITLE;
    case Panel::WEATHER:
        return SettingsKey::SETTINGS_WEATHER_SUBTITLE;
    case Panel::CLOUD:
        return SettingsKey::SETTINGS_CLOUD_SUBTITLE;
    case Panel::TIME:
        return SettingsKey::SETTINGS_TIME_SUBTITLE;
    case Panel::TIME_WINDOW:
        return SettingsKey::SETTINGS_TIME_WINDOW_SUBTITLE;
    case Panel::AUDIO:
        return SettingsKey::SETTINGS_AUDIO_SUBTITLE;
    case Panel::APPEARANCE:
        return SettingsKey::SETTINGS_APPEARANCE_SUBTITLE;
    default:
        return SettingsKey::SETTINGS_PLACEHOLDER_TITLE;
    }
}

/**
 * @brief Zeichnet die Titelbox und das gewählte Panel, dann Push.
 */
void Settings::drawWorkPanel()
{
    if (!m_workSprite)
        return;

    m_workSprite->clear(C_BG);
    m_workSprite->fillSmoothRoundRect(0, 0, WORK_W, WORK_H, WORK_R, C_WORK_BG);
    m_workSprite->fillSmoothRoundRect(TITLE_BOX_X, TITLE_BOX_Y, TITLE_BOX_W, TITLE_BOX_H, TITLE_BOX_R, C_TITLE_BG);

    m_workSprite->setTextDatum(TL_DATUM);
    m_workSprite->loadFont(ComfortaaBold30);
    m_workSprite->setTextColor(Theme::ColorGreen);
    m_workSprite->drawString(I18n::str(panelTitleKey(m_panel)), TITLE_TEXT_X, TITLE_TEXT_Y);
    m_workSprite->unloadFont();

    m_workSprite->loadFont(ComfortaaBold16);
    m_workSprite->setTextColor(C_SUB);
    m_workSprite->drawString(I18n::str(panelSubtitleKey(m_panel)), TITLE_TEXT_X, SUB_TEXT_Y);
    m_workSprite->unloadFont();

    switch (m_panel)
    {
    case Panel::WIFI:
        drawPanelWifi(m_workSprite);
        break;
    case Panel::GENERAL:
        drawPanelGeneral(m_workSprite);
        break;
    case Panel::SECURITY:
        drawPanelSecurity(m_workSprite);
        break;
    case Panel::INFO:
        drawPanelInfo(m_workSprite);
        break;
    case Panel::NEWS:
        drawPanelNews(m_workSprite);
        break;
    case Panel::WEATHER:
        drawPanelWeather(m_workSprite);
        break;
    case Panel::CLOUD:
        drawPanelCloud(m_workSprite);
        break;
    case Panel::TIME:
        drawPanelTime(m_workSprite);
        break;
    case Panel::TIME_WINDOW:
        drawPanelTimeWindow(m_workSprite);
        break;
    case Panel::AUDIO:
        drawPanelAudio(m_workSprite);
        break;
    case Panel::APPEARANCE:
        drawPanelAppearance(m_workSprite);
        break;
    default:
        drawPanelPlaceholder(m_workSprite);
        break;
    }

    m_workSprite->pushSprite(WORK_X, WORK_Y);
    m_workDirty = false;
}

/**
 * @brief Zeichnet ein Platzhalter-Panel (Dienste in Vorbereitung).
 */
void Settings::drawPanelPlaceholder(Gfx_Sprite *spr)
{
    spr->loadFont(ComfortaaBold16);
    spr->setTextColor(C_SUB);
    spr->setTextDatum(MC_DATUM);
    spr->drawString(I18n::str(SettingsKey::SETTINGS_PLACEHOLDER_MESSAGE),
                    CONTENT_X + CONTENT_W / 2, CONTENT_Y + CONTENT_H / 2);
    spr->unloadFont();
}

// ===================================================================
// WLAN-Panel
// ===================================================================

/**
 * @brief Geometrie einer Profilzeile (sprite-relativ).
 */
Settings::Rect Settings::wifiRowRect(int idx) const
{
    const int y = CONTENT_Y + idx * (WIFI_ROW_H + WIFI_ROW_GAP);
    return {CONTENT_X, y, CONTENT_W, WIFI_ROW_H};
}

/**
 * @brief Geometrie des Umschalters einer Profilzeile (sprite-relativ).
 */
Settings::Rect Settings::wifiToggleRect(int idx) const
{
    const Rect r = wifiRowRect(idx);
    const int x = r.x + r.w - TOGGLE_W - TOGGLE_MARGIN;
    const int y = r.y + (r.h - TOGGLE_H) / 2;
    return {x, y, TOGGLE_W, TOGGLE_H};
}

/**
 * @brief Geometrie eines Aktionsknopfes (sprite-relativ).
 */
Settings::Rect Settings::wifiActionRect(int slot) const
{
    const int y = CONTENT_Y + MAX_PROFILES * (WIFI_ROW_H + WIFI_ROW_GAP) + 6;
    const int w = (CONTENT_W - 3 * WIFI_ACT_GAP) / 4;
    const int x = CONTENT_X + slot * (w + WIFI_ACT_GAP);
    return {x, y, w, WIFI_ACT_H};
}

/**
 * @brief Geometrie des Netzwerknamen-Feldes am unteren Rand des Arbeitsbereichs (sprite-relativ).
 */
Settings::Rect Settings::hostnameFieldRect() const
{
    const int y = WORK_H - HOSTNAME_BOTTOM_GAP - HOSTNAME_FIELD_H;
    return {CONTENT_X, y, CONTENT_W, HOSTNAME_FIELD_H};
}

/**
 * @brief Liefert den Status-Schlüssel eines Profils.
 */
SettingsKey Settings::wifiStatusKey(int profileIndex) const
{
    if (!isProfileValid(profileIndex))
        return SettingsKey::SETTINGS_WIFI_STATUS_EMPTY;
    if (m_profiles[profileIndex].tested_ok)
        return SettingsKey::SETTINGS_WIFI_STATUS_CONNECTED;
    if (m_profiles[profileIndex].enabled)
        return SettingsKey::SETTINGS_WIFI_STATUS_ACTIVE;
    return SettingsKey::SETTINGS_WIFI_STATUS_INACTIVE;
}

/**
 * @brief Liefert die Statusfarbe eines Profils.
 */
uint16_t Settings::wifiStatusColor(int profileIndex) const
{
    if (!isProfileValid(profileIndex))
        return C_ST_EMPTY;
    if (m_profiles[profileIndex].tested_ok)
        return C_SEC_SYSTEM;
    if (m_profiles[profileIndex].enabled)
        return RetroColors::Olive;
    return C_ST_INACTIVE;
}

/**
 * @brief Zeichnet eine WLAN-Profilzeile inklusive Umschalter.
 */
void Settings::drawWifiRow(Gfx_Sprite *spr, int idx, const Rect &r, bool selected)
{
    const uint16_t rowBg = selected ? C_ROW_SEL_BG : C_ROW_BG;
    spr->fillSmoothRoundRect(r.x, r.y, r.w, r.h, 8, rowBg);
    if (selected)
        spr->fillRect(r.x, r.y + 6, ITEM_ACCENT_W, r.h - 12, C_SEC_CONNECTION);

    // Statuspunkt
    const uint16_t stColor = wifiStatusColor(idx);
    spr->fillSmoothCircle(r.x + 22, r.y + r.h / 2, 6, stColor);

    // Profilname
    char nameBuf[40];
    if (isProfileValid(idx))
    {
        stringutils::safeCopy(nameBuf, m_profiles[idx].ssid);
    }
    else
    {
        STRF(nameBuf, SettingsKey::SETTINGS_WIFI_PROFILE_FMT, idx + 1);
    }

    spr->loadFont(ComfortaaBold16);
    spr->setTextDatum(ML_DATUM);
    spr->setTextColor(isProfileValid(idx) ? C_TEXT_BRIGHT : C_SUB);
    spr->drawString(nameBuf, r.x + 40, r.y + 16);
    spr->unloadFont();

    // Statustext
    spr->loadFont(ComfortaaBold14);
    spr->setTextColor(stColor);
    spr->drawString(I18n::str(wifiStatusKey(idx)), r.x + 40, r.y + r.h - 14);
    spr->unloadFont();

    drawToggle(spr, wifiToggleRect(idx), m_profiles[idx].enabled, rowBg);
}

/**
 * @brief Zeichnet einen Umschalter mit Statusfarbe in den angegebenen Sprite.
 */
void Settings::drawToggle(Gfx_Sprite *spr, const Rect &t, bool on, uint16_t background)
{
    const uint16_t housing = on ? uint16_t(Theme::ColorButtonBorder) : uint16_t(TFT_DARKGREY);
    const uint16_t knobCol = on ? uint16_t(RetroColors::Olive) : uint16_t(Theme::ColorRetroRed);

    spr->fillSmoothRoundRect(t.x, t.y, t.w, t.h, t.h / 2, housing);
    spr->fillSmoothRoundRect(t.x + TOGGLE_INSET, t.y + TOGGLE_INSET,
                             t.w - 2 * TOGGLE_INSET, t.h - 2 * TOGGLE_INSET,
                             (t.h - 2 * TOGGLE_INSET) / 2, background);
    const int knobCx = on ? (t.x + t.w - TOGGLE_INSET - TOGGLE_KNOB_R - 1)
                          : (t.x + TOGGLE_INSET + TOGGLE_KNOB_R + 1);
    spr->fillSmoothCircle(knobCx, t.y + t.h / 2, TOGGLE_KNOB_R, knobCol);
}

/**
 * @brief Zeichnet das gesamte WLAN-Panel.
 */
void Settings::drawPanelWifi(Gfx_Sprite *spr)
{
    for (int i = 0; i < MAX_PROFILES; ++i)
        drawWifiRow(spr, i, wifiRowRect(i), i == m_selWifi);

    // Aktionsleiste für das gewählte Profil
    const bool configured = isProfileValid(m_selWifi);
    Button *abtn[4] = {&m_btnScan, &m_btnPassword, &m_btnTest, &m_btnDelete};
    const SettingsKey labels[4] = {
        SettingsKey::SETTINGS_WIFI_ACT_SCAN,
        SettingsKey::SETTINGS_WIFI_ACT_PASSWORD,
        SettingsKey::SETTINGS_WIFI_ACT_TEST,
        SettingsKey::SETTINGS_WIFI_ACT_DELETE};
    // Scannen ist immer möglich; Passwort/Test/Löschen brauchen eine SSID
    const bool enabled[4] = {true, configured, configured, configured};

    for (int k = 0; k < 4; ++k)
    {
        abtn[k]->setLabelText(reinterpret_cast<const char *>(I18n::str(labels[k])));
        if (enabled[k])
            abtn[k]->enable();
        else
            abtn[k]->disable();
        abtn[k]->drawButton();
    }

    // Geräte-Netzwerkname als tippbares Feld
    const Rect hf = hostnameFieldRect();
    spr->fillSmoothRoundRect(hf.x, hf.y, hf.w, hf.h, 8, BTN_OUTLINE);
    spr->fillSmoothRoundRect(hf.x + 1, hf.y + 1, hf.w - 2, hf.h - 2, 7, C_ROW_BG);

    if (hostnamePending())
        spr->fillRect(hf.x + 1, hf.y + 8, ITEM_ACCENT_W, hf.h - 16, C_SEC_CONNECTION);

    const int editX = hf.x + hf.w - HOSTNAME_PAD_X - HOSTNAME_EDIT_BTN_W;
    const int editY = hf.y + (hf.h - HOSTNAME_EDIT_BTN_H) / 2;

    spr->loadFont(ComfortaaBold16);
    const int lineH = spr->fontHeight();
    const int blockH = lineH * 2 + HOSTNAME_LINE_GAP;
    const int labelY = hf.y + (hf.h - blockH) / 2;
    const int valueY = labelY + lineH + HOSTNAME_LINE_GAP;

    spr->setTextDatum(TL_DATUM);
    spr->setTextColor(C_SUB);
    spr->drawString(I18n::str(SettingsKey::SETTINGS_WIFI_HOSTNAME_LABEL),
                    hf.x + HOSTNAME_PAD_X, labelY);
    spr->setTextColor(C_TEXT_BRIGHT);
    spr->drawString(m_hostname, hf.x + HOSTNAME_PAD_X, valueY);
    spr->unloadFont();

    // ändern-Knopf rechts im Feld als Aufforderung zum Bearbeiten
    spr->fillSmoothRoundRect(editX, editY, HOSTNAME_EDIT_BTN_W, HOSTNAME_EDIT_BTN_H, 6, BTN_OUTLINE);
    spr->fillSmoothRoundRect(editX + 1, editY + 1, HOSTNAME_EDIT_BTN_W - 2, HOSTNAME_EDIT_BTN_H - 2, 5, BTN_FILL);

    spr->loadFont(LeagueGothicCond34);
    spr->setTextDatum(MC_DATUM);
    spr->setTextColor(BTN_TEXT);
    spr->drawString(I18n::str(SettingsKey::SETTINGS_WIFI_HOSTNAME_EDIT),
                    editX + HOSTNAME_EDIT_BTN_W / 2, editY + HOSTNAME_EDIT_BTN_H / 2);
    spr->unloadFont();
}

// ===================================================================
// Allgemein-Panel
// ===================================================================

/**
 * @brief Geometrie einer Sprachzeile (sprite-relativ).
 */
Settings::Rect Settings::langRowRect(int idx) const
{
    const int y = LANG_ROWS_Y + idx * (LANG_ROW_H + LANG_ROW_GAP);
    return {CONTENT_X, y, CONTENT_W, LANG_ROW_H};
}

/**
 * @brief Bestimmt die Lage des Schalters für serielle Logs.
 */
Settings::Rect Settings::serialLogsToggleRect() const
{
    return {CONTENT_X + CONTENT_W - TOGGLE_W, LOGS_HEADING_Y + GENERAL_HEADING_H, TOGGLE_W, TOGGLE_H};
}

/**
 * @brief Zeichnet das Allgemein-Panel mit getrennten Rubriken für Sprache und serielle Logs.
 */
void Settings::drawPanelGeneral(Gfx_Sprite *spr)
{
    const int selectedIdx = (m_pendingLangIndex >= 0) ? m_pendingLangIndex : currentLangIndex();
    const int activeSysIdx = currentLangIndex();
    const SettingsKey names[2] = {SettingsKey::SETTINGS_LANG_NAME_DE, SettingsKey::SETTINGS_LANG_NAME_EN};

    spr->loadFont(ComfortaaBold16);
    spr->setTextDatum(ML_DATUM);
    spr->setTextColor(C_SEC_SYSTEM);
    spr->drawString(I18n::str(SettingsKey::SETTINGS_LANG_SECTION), CONTENT_X, CONTENT_Y + GENERAL_HEADING_H / 2);
    spr->drawString(I18n::str(SettingsKey::SETTINGS_LOGS_SECTION), CONTENT_X, LOGS_HEADING_Y + GENERAL_HEADING_H / 2);
    spr->drawFastHLine(CONTENT_X, LOGS_HEADING_Y - GENERAL_SECTION_GAP / 2, CONTENT_W, C_SEP_LINE);

    for (int i = 0; i < 2; ++i)
    {
        const Rect r = langRowRect(i);
        const bool selected = (i == selectedIdx);
        spr->fillSmoothRoundRect(r.x, r.y, r.w, r.h, 10, selected ? C_ROW_SEL_BG : C_ROW_BG);
        if (selected)
            spr->fillRect(r.x, r.y + 8, ITEM_ACCENT_W, r.h - 16, C_SEC_SYSTEM);

        spr->setTextDatum(ML_DATUM);
        spr->setTextColor(selected ? C_TEXT_BRIGHT : C_TEXT);
        spr->drawString(I18n::str(names[i]), r.x + 24, r.y + r.h / 2);
    }

    const Rect toggle = serialLogsToggleRect();
    drawToggle(spr, toggle, APP_STATE.getSerialLogsEnabled(), C_WORK_BG);
    spr->setTextColor(C_TEXT);
    spr->drawString(I18n::str(SettingsKey::SETTINGS_LOGS_TOGGLE), CONTENT_X, toggle.y + toggle.h / 2);
    spr->unloadFont();

    spr->loadFont(ComfortaaBold14);
    const Rect activeRow = langRowRect(activeSysIdx);
    spr->setTextDatum(MR_DATUM);
    spr->setTextColor(C_SEC_SYSTEM);
    spr->drawString(I18n::str(SettingsKey::SETTINGS_LANG_ACTIVE), activeRow.x + activeRow.w - 20, activeRow.y + activeRow.h / 2);
    spr->unloadFont();
}

// ===================================================================
// Sicherheit-Panel
// ===================================================================

/**
 * @brief Bestimmt die Lage des PIN-Schalters im Arbeitsbereich.
 */
Settings::Rect Settings::pinLockToggleRect() const
{
    return {CONTENT_X + CONTENT_W - TOGGLE_W, CONTENT_Y, TOGGLE_W, TOGGLE_H};
}

/**
 * @brief Zeichnet das Sicherheit-Panel mit Sperrschalter, PIN-Anzeige und Nummernblock.
 */
void Settings::drawPanelSecurity(Gfx_Sprite *spr)
{
    if (!m_numpadLayoutValid)
    {
        m_numpad.computeLayout(CONTENT_W, CONTENT_H - WorkshopNumpad::REQUIRED_H);
        m_numpadLayoutValid = true;
    }

    // Hinweistext je nach Eingabephase
    SettingsKey hintKey = SettingsKey::SETTINGS_SEC_PIN_HINT;
    uint16_t hintColor = C_SUB;
    if (m_confirmPinDisable)
    {
        hintKey = m_pinMismatch ? SettingsKey::SETTINGS_SEC_WRONG_PIN : SettingsKey::SETTINGS_SEC_CONFIRM_OFF;
        if (m_pinMismatch)
            hintColor = uint16_t(Theme::ColorRetroRed);
    }
    else if (m_pinConfirming)
    {
        hintKey = SettingsKey::SETTINGS_SEC_PIN_REPEAT;
    }
    else if (m_pinMismatch)
    {
        hintKey = SettingsKey::SETTINGS_SEC_PIN_MISMATCH;
        hintColor = uint16_t(Theme::ColorRetroRed);
    }
    else if (pinPending() && m_pinLen == 0)
    {
        hintKey = SettingsKey::SETTINGS_SEC_PIN_READY;
        hintColor = C_SEC_SYSTEM;
    }

    m_displayedPinLock = APP_STATE.isPinLockEnabled();
    const Rect toggle = pinLockToggleRect();
    drawToggle(spr, toggle, m_displayedPinLock, C_WORK_BG);
    spr->loadFont(ComfortaaBold16);
    spr->setTextDatum(ML_DATUM);
    spr->setTextColor(C_TEXT);
    spr->drawString(I18n::str(SettingsKey::SETTINGS_SEC_TOGGLE), CONTENT_X, toggle.y + toggle.h / 2);
    spr->setTextDatum(MC_DATUM);
    spr->setTextColor(hintColor);
    spr->drawString(I18n::str(hintKey), CONTENT_X + CONTENT_W / 2, PIN_HINT_Y);
    spr->unloadFont();

    // PIN-Punkte
    const int totalW = 3 * PIN_DOT_GAP;
    const int startX = CONTENT_X + (CONTENT_W - totalW) / 2;
    for (int i = 0; i < 4; ++i)
    {
        const int cx = startX + i * PIN_DOT_GAP;
        if (i < m_pinLen)
            spr->fillSmoothCircle(cx, PIN_DOTS_Y, PIN_DOT_R, C_TEXT);
        else
            spr->fillSmoothCircle(cx, PIN_DOTS_Y, PIN_DOT_R, C_DOT_EMPTY);
    }

    // Nummernblock am unteren Rand
    m_numpad.draw(spr, CONTENT_X, CONTENT_Y, -1);
}

// ===================================================================
// Info-Panel
// ===================================================================

/**
 * @brief Geometrie eines der beiden Info-Knöpfe im Footer.
 */
Settings::Rect Settings::footerInfoButtonRect(int slot) const
{
    int buttonW = footerButtonWidthForLabels(SettingsKey::SETTINGS_INFO_RESTART_BTN, SettingsKey::SETTINGS_INFO_RESET_BTN);
    const int availableW = CLOCK_PUSH_X - FOOTER_ACTION_CLOCK_GAP - FOOTER_ACTION_BTN_X0;
    const int maxButtonW = (availableW - FOOTER_ACTION_BTN_GAP) / 2;
    if (buttonW > maxButtonW)
        buttonW = maxButtonW;

    const int x = FOOTER_ACTION_BTN_X0 + slot * (buttonW + FOOTER_ACTION_BTN_GAP);
    const int y = FOOTER_Y + (FOOTER_H - BTN_H) / 2;
    return {x, y, buttonW, BTN_H};
}

/**
 * @brief Geometrie des Zurücksetzen-Knopfs im Zeitfenster-Footer.
 */
Settings::Rect Settings::footerTimeWindowResetButtonRect() const
{
    const int x = WORK_X + SAVE_BTN_W + FOOTER_ACTION_BTN_GAP;
    const int y = FOOTER_Y + (FOOTER_H - BTN_H) / 2;
    int buttonW = footerButtonWidthForLabel(SettingsKey::SETTINGS_INFO_RESET_BTN);
    const int maxButtonW = CLOCK_PUSH_X - FOOTER_ACTION_CLOCK_GAP - x;
    if (buttonW > maxButtonW)
        buttonW = maxButtonW;

    return {x, y, buttonW, BTN_H};
}

/**
 * @brief Geometrie des Cloud-Löschknopfs im Footer.
 */
Settings::Rect Settings::footerCloudClearButtonRect() const
{
    const int x = WORK_X + SAVE_BTN_W + FOOTER_ACTION_BTN_GAP;
    const int y = FOOTER_Y + (FOOTER_H - BTN_H) / 2;
    int buttonW = footerButtonWidthForLabel(SettingsKey::SETTINGS_CLOUD_CLEAR_BTN);
    const int maxButtonW = CLOCK_PUSH_X - FOOTER_ACTION_CLOCK_GAP - x;
    if (buttonW > maxButtonW)
        buttonW = maxButtonW;

    return {x, y, buttonW, BTN_H};
}

/**
 * @brief Berechnet eine Footer-Buttonbreite aus Labelbreite und Innenabstand.
 */
int Settings::footerButtonWidthForLabel(SettingsKey labelKey) const
{
    if (!m_tft)
        return FOOTER_ACTION_BTN_MIN_W;

    const char *label = reinterpret_cast<const char *>(I18n::str(labelKey));
    m_tft->loadFont(LeagueGothicCond34);
    const int textW = m_tft->textWidth(label ? label : "");
    m_tft->unloadFont();

    const int wantedW = textW + 2 * FOOTER_ACTION_BTN_PAD_X;
    if (wantedW < FOOTER_ACTION_BTN_MIN_W)
        return FOOTER_ACTION_BTN_MIN_W;

    return wantedW;
}

/**
 * @brief Berechnet eine gemeinsame Breite für zwei Footer-Buttons.
 */
int Settings::footerButtonWidthForLabels(SettingsKey firstKey, SettingsKey secondKey) const
{
    const int firstW = footerButtonWidthForLabel(firstKey);
    const int secondW = footerButtonWidthForLabel(secondKey);
    if (firstW > secondW)
        return firstW;

    return secondW;
}

/**
 * @brief Initialisiert einen Textbutton im Footer mit aktueller Geometrie.
 */
void Settings::initFooterTextButton(Button &btn, const Rect &rect, SettingsKey labelKey)
{
    btn.initButton(m_tft,
                   rect.x + rect.w / 2,
                   rect.y + rect.h / 2,
                   rect.w,
                   rect.h,
                   BTN_R,
                   BTN_OUTLINE,
                   BTN_FILL,
                   BTN_TEXT,
                   reinterpret_cast<const char *>(I18n::str(labelKey)),
                   nullptr);
    btn.setFont(LeagueGothicCond34);
}

/**
 * @brief Zeichnet das Info-Panel mit Netzwerk- und System-Werten in zwei Spalten.
 *
 * Linke Spalte zeigt netzwerkbezogene Werte (SSID, Host-Name, IP-Adresse, MAC-Adresse, Kanal, Signal, Zeitserver, Sync), rechte Spalte System-Werte (Version, FW-Belegung, MCU, RAM, UART, Innenklima, Heap, PSRAM, Uptime). Die zwei Aktions-Knöpfe (Neustart, Zurücksetzen) liegen nicht im Panel selbst, sondern in der Fußzeile und werden von `drawFooter()` gezeichnet.
 */
void Settings::drawPanelInfo(Gfx_Sprite *spr)
{
    constexpr int COL_GAP = 14;
    constexpr int COL_W = (CONTENT_W - COL_GAP) / 2;
    constexpr int LEFT_X = CONTENT_X;
    constexpr int RIGHT_X = CONTENT_X + COL_W + COL_GAP;
    constexpr int HDR_H = 26;
    constexpr int HDR_PAD_X = 10;
    constexpr int ROW_H = 28;
    constexpr int ROW_PAD_X = 8;
    constexpr int I2C_LABEL_GAP = 10; ///< Abstand zwischen I2C-Badge und Adressliste
    constexpr int I2C_BOTTOM_GAP = 10; ///< Abstand der I2C-Zeile zum unteren Rand
    constexpr float I2C_BADGE_COLOR_SCALE = 0.35f; ///< Abdunkelung der I2C-Badge-Farbe
    constexpr int SIGNAL_BAR_W = 80;
    constexpr int SIGNAL_BAR_H = 8;

    // Gedämpfte Headerfarben, getrennt von den hellen Akzent- Streifen im Menü, weil eine vollflächige Sättigung dort grell wirkt.
    constexpr uint16_t C_INFO_HDR_NET = 0x60A6; ///< Gedämpftes Burgunder-Pflaume für den Netzwerk-Header
    constexpr uint16_t C_INFO_HDR_SYS = 0x6A82; ///< Warmes Messing für den System-Header

    // Sammeln der Werte einmalig oben, dann einheitlich zeichnen.
    char ssidBuf[40] = {0};
    char hostBuf[40] = {0};
    char ipBuf[24] = {0};
    char gatewayBuf[24] = {0};
    char macBuf[24] = {0};
    char channelBuf[24] = {0};
    char ntpBuf[40] = {0};
    char syncBuf[32] = {0};
    char fwBuf[32] = {0};
    char fwSizeBuf[24] = {0};
    char mcuBuf[40] = {0};
    char hardwareBuf[40] = {0};
    char heapBuf[40] = {0};
    char psramFreeBuf[32] = {0};
    char uptimeBuf[32] = {0};
    char uartBuf[24] = {0};
    char i2cBuf[96] = {0};

    const bool wifiOn = WiFi.status() == WL_CONNECTED;

    if (wifiOn)
    {
        const String ssid = WiFi.SSID();
        stringutils::safeCopy(ssidBuf, ssid.c_str());
        const char *host = WiFi.getHostname();
        if (host && *host)
            stringutils::safeCopy(hostBuf, host);
        else
            stringutils::safeCopy(hostBuf, reinterpret_cast<const char *>(I18n::str(SettingsKey::SETTINGS_INFO_NOT_CONNECTED)));
        const IPAddress ip = WiFi.localIP();
        stringutils::safeFormat(ipBuf, "%u.%u.%u.%u", ip[0], ip[1], ip[2], ip[3]);
        const IPAddress gw = WiFi.gatewayIP();
        stringutils::safeFormat(gatewayBuf, "%u.%u.%u.%u", gw[0], gw[1], gw[2], gw[3]);
        STRF(channelBuf, SettingsKey::SETTINGS_INFO_CHANNEL_FMT,
             static_cast<int>(WiFi.channel()));
    }
    else
    {
        const char *notConn = reinterpret_cast<const char *>(I18n::str(SettingsKey::SETTINGS_INFO_NOT_CONNECTED));
        stringutils::safeCopy(ssidBuf, notConn);
        stringutils::safeCopy(hostBuf, notConn);
        stringutils::safeCopy(ipBuf, notConn);
        stringutils::safeCopy(gatewayBuf, notConn);
        stringutils::safeCopy(channelBuf, notConn);
    }

    // MAC-Adresse liegt im eFuse und ist auch ohne WLAN-Verbindung lesbar.
    {
        uint8_t mac[6] = {0};
        esp_read_mac(mac, ESP_MAC_WIFI_STA);
        stringutils::safeFormat(macBuf, "%02X:%02X:%02X:%02X:%02X:%02X",
                                mac[0], mac[1], mac[2], mac[3], mac[4], mac[5]);
    }

    // Zeitserver-Name aus AppState; falls leer, dezenter Platzhalter
    const char *ntpServer = APP_STATE.getNtpServer();
    if (ntpServer && *ntpServer)
        stringutils::safeCopy(ntpBuf, ntpServer);
    else
        stringutils::safeCopy(ntpBuf, reinterpret_cast<const char *>(I18n::str(SettingsKey::SETTINGS_INFO_NOT_CONNECTED)));

    // Letzter Zeitabgleich kompakt: TT.MM.JJ HH:MM (Nx)
    {
        const char *lastSync = SYSTEM_STATS.getLastSync();
        const unsigned long syncCount = static_cast<unsigned long>(SYSTEM_STATS.getNtpSyncCount());
        const bool hasWebFormat = lastSync && strlen(lastSync) >= 16 &&
                                  isdigit(static_cast<unsigned char>(lastSync[0])) &&
                                  isdigit(static_cast<unsigned char>(lastSync[1])) &&
                                  lastSync[2] == '.' &&
                                  isdigit(static_cast<unsigned char>(lastSync[3])) &&
                                  isdigit(static_cast<unsigned char>(lastSync[4])) &&
                                  lastSync[5] == '.' &&
                                  isdigit(static_cast<unsigned char>(lastSync[8])) &&
                                  isdigit(static_cast<unsigned char>(lastSync[9])) &&
                                  lastSync[10] == ' ' &&
                                  isdigit(static_cast<unsigned char>(lastSync[11])) &&
                                  isdigit(static_cast<unsigned char>(lastSync[12])) &&
                                  lastSync[13] == ':' &&
                                  isdigit(static_cast<unsigned char>(lastSync[14])) &&
                                  isdigit(static_cast<unsigned char>(lastSync[15]));

        if (hasWebFormat)
        {
            stringutils::safeFormat(syncBuf, "%c%c.%c%c.%c%c %c%c:%c%c (%lux)",
                                    lastSync[0], lastSync[1],
                                    lastSync[3], lastSync[4],
                                    lastSync[8], lastSync[9],
                                    lastSync[11], lastSync[12],
                                    lastSync[14], lastSync[15],
                                    syncCount);
        }
        else
        {
            stringutils::safeFormat(syncBuf, "%s (%lux)",
                                    reinterpret_cast<const char *>(I18n::str(SettingsKey::SETTINGS_INFO_NEVER)),
                                    syncCount);
        }
    }

    // Firmware-Kennung kommt aus dem Build-Flag FW_VERSION.
    stringutils::safeCopy(fwBuf, FW_VERSION);

    // Firmware-Belegung: Sketch-Größe in Byte und Auslastung der laufenden Partition.
    {
        const size_t sketchSize = ESP.getSketchSize();
        const esp_partition_t *partition = esp_ota_get_running_partition();
        const size_t partitionSize = partition ? partition->size : 0;
        if (partitionSize > 0)
        {
            const int usedPercent = static_cast<int>((sketchSize * 100UL) / partitionSize);
            stringutils::safeFormat(fwSizeBuf, "%lu Byte (%d%%)",
                                    static_cast<unsigned long>(sketchSize), usedPercent);
        }
        else
        {
            stringutils::safeFormat(fwSizeBuf, "%lu Byte",
                                    static_cast<unsigned long>(sketchSize));
        }
    }

    stringutils::safeFormat(mcuBuf, "%s @ %u MHz",
                            ESP.getChipModel(),
                            static_cast<unsigned>(ESP.getCpuFreqMHz()));

    STRF(hardwareBuf, SettingsKey::SETTINGS_INFO_HARDWARE_FMT,
         static_cast<int>(ESP.getFlashChipSize() / (1024UL * 1024UL)),
         static_cast<int>(ESP.getPsramSize() / (1024UL * 1024UL)));

    // Heap-Fragmentierung: (1 - groesster_freier_Block / freie_gesamt) * 100
    {
        const size_t freeTotal = heap_caps_get_free_size(MALLOC_CAP_INTERNAL);
        const size_t largest = heap_caps_get_largest_free_block(MALLOC_CAP_INTERNAL);
        int frag = 0;
        if (freeTotal > 0 && largest <= freeTotal)
            frag = static_cast<int>(100UL - (largest * 100UL) / freeTotal);
        if (frag < 0)
            frag = 0;
        if (frag > 100)
            frag = 100;

        STRF(heapBuf, SettingsKey::SETTINGS_INFO_HEAP_FMT,
             static_cast<int>(ESP.getFreeHeap() / 1024UL), frag);
    }

    {
        const uint32_t psramFree = ESP.getFreePsram();
        const uint32_t psramTotal = ESP.getPsramSize();
        int psramPercent = 0;
        if (psramTotal > 0)
            psramPercent = static_cast<int>((psramFree * 100UL) / psramTotal);
        STRF(psramFreeBuf, SettingsKey::SETTINGS_INFO_PSRAM_FMT,
             static_cast<int>(psramFree / 1024UL), psramPercent);
    }

    const uint32_t secs = millis() / 1000UL;
    STRF(uptimeBuf, SettingsKey::SETTINGS_INFO_UPTIME_FMT,
         static_cast<int>(secs / 86400UL),
         static_cast<int>((secs % 86400UL) / 3600UL),
         static_cast<int>((secs % 3600UL) / 60UL),
         static_cast<int>(SYSTEM_STATS.getWifiReconnects()));

    stringutils::safeFormat(uartBuf, "%u bit/s", static_cast<unsigned>(Serial.baudRate()));

    if (APP_STATE.wasI2cScanBusBlocked())
        STRF(i2cBuf, SettingsKey::SETTINGS_INFO_I2C_BUS_BLOCKED);
    else if (!APP_STATE.wasI2cScanCompleted())
        STRF(i2cBuf, SettingsKey::SETTINGS_INFO_I2C_NOT_CHECKED);
    else if (APP_STATE.getI2cScanResult()[0] == '\0')
        STRF(i2cBuf, SettingsKey::SETTINGS_INFO_I2C_NONE);
    else
        stringutils::safeCopy(i2cBuf, APP_STATE.getI2cScanResult());

    // Datenstrukturen für Standardzeilen, die Signalzeile wird separat gezeichnet
    struct InfoRow
    {
        SettingsKey labelKey;
        const char *value;
    };

    // Linke Spalte: SSID, Host, IP, Gateway, MAC, [Signal], NTP, Sync
    const InfoRow leftRowsTop[] = {
        {SettingsKey::SETTINGS_INFO_SSID, ssidBuf},
        {SettingsKey::SETTINGS_INFO_HOSTNAME, hostBuf},
        {SettingsKey::SETTINGS_INFO_IP, ipBuf},
        {SettingsKey::SETTINGS_INFO_GATEWAY, gatewayBuf},
        {SettingsKey::SETTINGS_INFO_MAC, macBuf},
        {SettingsKey::SETTINGS_INFO_CHANNEL, channelBuf},
    };
    const InfoRow leftRowsBot[] = {
        {SettingsKey::SETTINGS_INFO_NTP_SERVER, ntpBuf},
        {SettingsKey::SETTINGS_INFO_SYNC_STATUS, syncBuf},
    };

    // Systemdaten in der rechten Spalte
    const InfoRow rightRows[] = {
        {SettingsKey::SETTINGS_INFO_FIRMWARE, fwBuf},
        {SettingsKey::SETTINGS_INFO_FIRMWARE_SIZE, fwSizeBuf},
        {SettingsKey::SETTINGS_INFO_MCU, mcuBuf},
        {SettingsKey::SETTINGS_INFO_HARDWARE, hardwareBuf},
        {SettingsKey::SETTINGS_INFO_UART, uartBuf},
        {SettingsKey::SETTINGS_INFO_HEAP_FREE, heapBuf},
        {SettingsKey::SETTINGS_INFO_PSRAM_FREE, psramFreeBuf},
        {SettingsKey::SETTINGS_INFO_UPTIME, uptimeBuf},
    };

    // Hilfs-Lambda zum Zeichnen einer Standard-Zeile (Label links, Wert rechts).
    auto drawInfoRow = [&](int colX, int colW, int yTop, const InfoRow &row)
    {
        spr->setTextDatum(ML_DATUM);
        spr->setTextColor(C_SUB);
        spr->drawString(I18n::str(row.labelKey), colX + ROW_PAD_X, yTop + ROW_H / 2);
        spr->setTextDatum(MR_DATUM);
        spr->setTextColor(C_TEXT_BRIGHT);
        spr->drawString(row.value, colX + colW - ROW_PAD_X, yTop + ROW_H / 2);
        spr->drawFastHLine(colX + ROW_PAD_X, yTop + ROW_H - 1,
                           colW - 2 * ROW_PAD_X, C_SEP_LINE);
    };

    spr->loadFont(ComfortaaBold16);

    // Gedämpfte Sektionsüberschriften in warmem und kühlem Farbton
    spr->fillSmoothRoundRect(LEFT_X, CONTENT_Y, COL_W, HDR_H, 6, C_INFO_HDR_NET);
    spr->setTextDatum(ML_DATUM);
    spr->setTextColor(C_TEXT_BRIGHT);
    spr->drawString(I18n::str(SettingsKey::SETTINGS_INFO_SECTION_NETWORK),
                    LEFT_X + HDR_PAD_X, CONTENT_Y + HDR_H / 2);

    spr->fillSmoothRoundRect(RIGHT_X, CONTENT_Y, COL_W, HDR_H, 6, C_INFO_HDR_SYS);
    spr->setTextDatum(ML_DATUM);
    spr->setTextColor(C_TEXT_BRIGHT);
    spr->drawString(I18n::str(SettingsKey::SETTINGS_INFO_SECTION_SYSTEM),
                    RIGHT_X + HDR_PAD_X, CONTENT_Y + HDR_H / 2);

    // Linke Spalte: obere Standard-Zeilen
    int leftY = CONTENT_Y + HDR_H + 4;
    for (const InfoRow &row : leftRowsTop)
    {
        drawInfoRow(LEFT_X, COL_W, leftY, row);
        leftY += ROW_H;
    }

    // Signal-Zeile mit Balken
    spr->setTextDatum(ML_DATUM);
    spr->setTextColor(C_SUB);
    spr->drawString(I18n::str(SettingsKey::SETTINGS_INFO_SIGNAL),
                    LEFT_X + ROW_PAD_X, leftY + ROW_H / 2);

    if (wifiOn)
    {
        const int32_t rssi = WiFi.RSSI();
        int percent = 0;
        if (rssi >= -50)
            percent = 100;
        else if (rssi <= -90)
            percent = 0;
        else
            percent = (rssi + 90) * 100 / 40;
        if (percent < 0)
            percent = 0;
        if (percent > 100)
            percent = 100;

        uint16_t barColor;
        if (percent >= 60)
            barColor = C_SEC_SYSTEM;
        else if (percent >= 30)
            barColor = 0xFE60;
        else
            barColor = 0xF800;

        const int textRightX = LEFT_X + COL_W - ROW_PAD_X;
        const int barX = textRightX - SIGNAL_BAR_W;
        const int barY = leftY + ROW_H / 2 - SIGNAL_BAR_H / 2;
        spr->fillRoundRect(barX, barY, SIGNAL_BAR_W, SIGNAL_BAR_H, 2, BTN_OUTLINE);
        const int fillW = SIGNAL_BAR_W * percent / 100;
        if (fillW > 0)
            spr->fillRoundRect(barX, barY, fillW, SIGNAL_BAR_H, 2, barColor);

        char sigText[20];
        stringutils::safeFormat(sigText, "%d dB (%d%%)",
                                static_cast<int>(rssi), percent);
        spr->setTextDatum(MR_DATUM);
        spr->setTextColor(C_TEXT_BRIGHT);
        spr->drawString(sigText, barX - 6, leftY + ROW_H / 2);
    }
    else
    {
        spr->setTextDatum(MR_DATUM);
        spr->setTextColor(C_SUB);
        spr->drawString(I18n::str(SettingsKey::SETTINGS_INFO_NOT_CONNECTED),
                        LEFT_X + COL_W - ROW_PAD_X, leftY + ROW_H / 2);
    }
    spr->drawFastHLine(LEFT_X + ROW_PAD_X, leftY + ROW_H - 1,
                       COL_W - 2 * ROW_PAD_X, C_SEP_LINE);
    leftY += ROW_H;

    // Letzte zwei Zeilen links: NTP-Server und Sync
    for (const InfoRow &row : leftRowsBot)
    {
        drawInfoRow(LEFT_X, COL_W, leftY, row);
        leftY += ROW_H;
    }

    // Rechte Spalte: System-Werte untereinander
    int rightY = CONTENT_Y + HDR_H + 4;
    for (const InfoRow &row : rightRows)
    {
        drawInfoRow(RIGHT_X, COL_W, rightY, row);
        rightY += ROW_H;
    }

    const int i2cY = WORK_H - I2C_BOTTOM_GAP - ROW_H;
    const char *i2cLabel = reinterpret_cast<const char *>(I18n::str(SettingsKey::SETTINGS_INFO_I2C));
    const int i2cLabelW = spr->textWidth(i2cLabel) + 2 * HDR_PAD_X;
    spr->fillSmoothRoundRect(CONTENT_X, i2cY + 1, i2cLabelW, HDR_H, 6, scaleColor(C_SEC_CONNECTION, I2C_BADGE_COLOR_SCALE));
    spr->setTextDatum(ML_DATUM);
    spr->setTextColor(C_TEXT_BRIGHT);
    spr->drawString(i2cLabel, CONTENT_X + HDR_PAD_X, i2cY + 1 + HDR_H / 2);
    spr->drawString(i2cBuf, CONTENT_X + i2cLabelW + I2C_LABEL_GAP, i2cY + ROW_H / 2);
    spr->drawFastHLine(CONTENT_X + ROW_PAD_X, i2cY + ROW_H - 1, CONTENT_W - 2 * ROW_PAD_X, C_SEP_LINE);

    spr->unloadFont();
}

// ===================================================================
// Fußzeile
// ===================================================================

/**
 * @brief Zeichnet die Fußzeile: löscht den Bereich bis zur Uhr, zeichnet Exit
 *        und den Speichern-Knopf nur, wenn es ungespeicherte Änderungen gibt.
 */
void Settings::drawFooter()
{
    if (!m_tft)
        return;

    m_tft->fillRect(DIVIDER_X + 1, FOOTER_Y, CLOCK_PUSH_X - DIVIDER_X - 1, FOOTER_H, C_BG);
    m_exitButton.drawButton();

    if (m_panel == Panel::INFO)
    {
        initFooterTextButton(m_btnRestart, footerInfoButtonRect(0), SettingsKey::SETTINGS_INFO_RESTART_BTN);
        m_btnRestart.enable();
        m_btnRestart.drawButton();

        initFooterTextButton(m_btnReset, footerInfoButtonRect(1), SettingsKey::SETTINGS_INFO_RESET_BTN);
        m_btnReset.enable();
        m_btnReset.drawButton();
    }
    else if (m_panel == Panel::CLOUD)
    {
        if (cloudPending())
        {
            m_saveButton.setLabelText(reinterpret_cast<const char *>(I18n::str(SettingsKey::SETTINGS_FOOTER_SAVE)));
            m_saveButton.enable();
            m_saveButton.setFillColor(BTN_ACTIVE_FILL);
            m_saveButton.setOutlineColor(BTN_ACTIVE_FILL);
            m_saveButton.setTextColor(BTN_ACTIVE_TEXT);
            m_saveButton.drawButton();
        }

        initFooterTextButton(m_btnReset, footerCloudClearButtonRect(), SettingsKey::SETTINGS_CLOUD_CLEAR_BTN);
        m_btnReset.enable();
        m_btnReset.drawButton();
    }
    else if (m_panel == Panel::TIME_WINDOW)
    {
        const bool dirty = timeWindowPending();

        m_saveButton.setLabelText(reinterpret_cast<const char *>(I18n::str(SettingsKey::SETTINGS_FOOTER_SAVE)));
        m_saveButton.setFillColor(BTN_ACTIVE_FILL);
        m_saveButton.setOutlineColor(BTN_ACTIVE_FILL);
        m_saveButton.setTextColor(BTN_ACTIVE_TEXT);
        if (dirty)
            m_saveButton.enable();
        else
            m_saveButton.disable();
        m_saveButton.drawButton();

        initFooterTextButton(m_btnReset, footerTimeWindowResetButtonRect(), SettingsKey::SETTINGS_INFO_RESET_BTN);
        m_btnReset.enable();
        m_btnReset.drawButton();
    }
    else if (panelDirty(m_panel))
    {
        m_saveButton.setLabelText(reinterpret_cast<const char *>(I18n::str(SettingsKey::SETTINGS_FOOTER_SAVE)));
        m_saveButton.enable();
        m_saveButton.setFillColor(BTN_ACTIVE_FILL);
        m_saveButton.setOutlineColor(BTN_ACTIVE_FILL);
        m_saveButton.setTextColor(BTN_ACTIVE_TEXT);
        m_saveButton.drawButton();
    }

    if (m_panel == Panel::AUDIO)
        drawAudioFooterControls();

    m_footerDirty = false;
}

/**
 * @brief Zeichnet Hörprobe-Knopf und Lautstärke-Knöpfe im Footer (nur Klang-Panel).
 */
void Settings::drawAudioFooterControls()
{
    m_audioPlayBtn.setLabelText(m_previewPlaying ? "^STOP:32:A944^" : "^PLAY:32:5C44^");
    m_audioPlayBtn.drawButton(false);
    m_audioVolDownBtn.drawButton(false);
    m_audioVolUpBtn.drawButton(false);

    // Rahmen um die Lautstärke-Zahl
    const int frameY = FOOTER_CY - AUDIO_FT_BTN_SIZE / 2;
    m_tft->fillSmoothRoundRect(AUDIO_FT_FRAME_X, frameY, AUDIO_FT_FRAME_W, AUDIO_FT_BTN_SIZE, AUDIO_FT_BTN_R, BTN_OUTLINE);
    m_tft->fillSmoothRoundRect(AUDIO_FT_FRAME_X + 1, frameY + 1, AUDIO_FT_FRAME_W - 2, AUDIO_FT_BTN_SIZE - 2, AUDIO_FT_BTN_R, TFT_BLACK);

    drawAudioVolumeValue();
}

/**
 * @brief Aktualisiert die Lautstärke-DotMatrix im Footer.
 */
void Settings::drawAudioVolumeValue()
{
    if (!m_audioVolSprite)
        return;

    const uint8_t vol = constrain(APP_STATE.getCurrentVolume(), 0, 99);
    char volStr[4];
    stringutils::safeFormat(volStr, "%2d", vol);
    m_audioVolDots.setText(volStr);

    m_audioVolSprite->clear(TFT_BLACK);
    m_audioVolDots.draw(m_audioVolSprite, 0, 0);

    const int sprY = FOOTER_CY - AUDIO_FT_DISP_H / 2;
    m_audioVolSprite->pushSprite(AUDIO_FT_DISP_X, sprY);
}

/**
 * @brief Zeichnet die Digitaluhr (interner Redraw nur bei Sekundenwechsel).
 */
void Settings::drawClock()
{
    if (!m_clockSprite)
        return;

    DS1307_RTC *rtc = &APP_STATE.getRTC();
    Clocks::drawDigitalClockPlain(m_clockSprite, rtc, m_lastDrawnSecond, CLOCK_PUSH_X, CLOCK_PUSH_Y, false, true);
}

// ===================================================================
// Touch-Verarbeitung
// ===================================================================

/**
 * @brief Verarbeitet Touch-Eingaben und verteilt sie auf die Bereiche.
 */
bool Settings::handleTouch()
{
    int32_t tx, ty;

    if (m_requireTouchRelease)
    {
        bool touching = m_tft->getTouch(&tx, &ty);
        if (!touching && (m_touchBlockUntil == 0 || millis() >= m_touchBlockUntil))
            m_requireTouchRelease = false;
        return false;
    }

    if (m_tft->getTouch(&tx, &ty))
    {
        if (!m_touchProcessed)
        {
            m_touchProcessed = true;

            if (pointIn(tx, ty, MENU_X, 0, MENU_W, MENU_SPRITE_H))
                handleMenuTouch(tx, ty);
            else if (pointIn(tx, ty, WORK_X, WORK_Y, WORK_W, WORK_H))
                handleWorkTouch(tx, ty);
            else if (ty >= FOOTER_Y)
            {
                bool handled = false;

                if (m_panel == Panel::INFO)
                {
                    const Rect restart = footerInfoButtonRect(0);
                    const Rect reset = footerInfoButtonRect(1);
                    if (pointIn(tx, ty, restart.x, restart.y, restart.w, restart.h))
                    {
                        startRestartDialog();
                        handled = true;
                    }
                    else if (pointIn(tx, ty, reset.x, reset.y, reset.w, reset.h))
                    {
                        startResetDialog();
                        handled = true;
                    }
                }
                else if (m_panel == Panel::CLOUD)
                {
                    const Rect clear = footerCloudClearButtonRect();
                    if (cloudPending() && m_saveButton.contains(tx, ty))
                    {
                        startSaving();
                        handled = true;
                    }
                    else if (pointIn(tx, ty, clear.x, clear.y, clear.w, clear.h))
                    {
                        startCloudClearDialog();
                        handled = true;
                    }
                }
                else if (m_panel == Panel::TIME_WINDOW)
                {
                    const Rect reset = footerTimeWindowResetButtonRect();
                    if (m_saveButton.contains(tx, ty))
                    {
                        if (timeWindowPending())
                            startSaving();
                        handled = true;
                    }
                    else if (pointIn(tx, ty, reset.x, reset.y, reset.w, reset.h))
                    {
                        startTimeWindowResetDialog();
                        handled = true;
                    }
                }

                if (m_panel == Panel::AUDIO && !handled)
                {
                    if (m_audioPlayBtn.contains(tx, ty))
                    {
                        if (m_previewPlaying)
                        {
                            if (m_callbacks.requestStopPlayback)
                                m_callbacks.requestStopPlayback();
                            m_previewPlaying = false;
                        }
                        else
                        {
                            if (m_callbacks.requestPlayStation)
                                m_callbacks.requestPlayStation(APP_STATE.getCurrentRetroStation());
                            m_previewPlaying = true;
                        }
                        m_footerDirty = true;
                        handled = true;
                    }
                    else if (m_audioVolUpBtn.contains(tx, ty))
                    {
                        int vol = APP_STATE.getCurrentVolume();
                        vol = (vol + AUDIO_FT_VOL_STEP > 100) ? 100 : vol + AUDIO_FT_VOL_STEP;
                        APP_STATE.setCurrentVolume(static_cast<uint8_t>(vol));
                        if (m_callbacks.onVolumeChanged)
                            m_callbacks.onVolumeChanged(static_cast<uint8_t>(vol));
                        extern void applyAudioTone(uint16_t freqLow, uint16_t freqPeak, uint16_t freqHigh, uint8_t loudness);
                        applyAudioTone(m_eqFreqLow, m_eqFreqPeak, m_eqFreqHigh, static_cast<uint8_t>(m_loudness));
                        drawAudioVolumeValue();
                        handled = true;
                    }
                    else if (m_audioVolDownBtn.contains(tx, ty))
                    {
                        int vol = APP_STATE.getCurrentVolume();
                        vol = (vol < AUDIO_FT_VOL_STEP) ? 0 : vol - AUDIO_FT_VOL_STEP;
                        APP_STATE.setCurrentVolume(static_cast<uint8_t>(vol));
                        if (m_callbacks.onVolumeChanged)
                            m_callbacks.onVolumeChanged(static_cast<uint8_t>(vol));
                        extern void applyAudioTone(uint16_t freqLow, uint16_t freqPeak, uint16_t freqHigh, uint8_t loudness);
                        applyAudioTone(m_eqFreqLow, m_eqFreqPeak, m_eqFreqHigh, static_cast<uint8_t>(m_loudness));
                        drawAudioVolumeValue();
                        handled = true;
                    }
                }

                if (!handled)
                {
                    if (m_saveButton.contains(tx, ty))
                    {
                        if (panelDirty(m_panel))
                            startSaving();
                    }
                    else if (m_exitButton.contains(tx, ty))
                    {
                        m_exitButton.press(true);
                        m_exitButton.drawButton(true);
                    }
                }
            }
            return true;
        }
    }
    else
    {
        if (m_exitButton.isPressed())
        {
            m_exitButton.press(false);
            m_exitButton.drawButton(false);
            startExitDialog();
            m_touchProcessed = false;
            return true;
        }

        m_touchProcessed = false;
    }
    return false;
}

/**
 * @brief Behandelt einen Tap im Menü.
 */
void Settings::handleMenuTouch(int32_t tx, int32_t ty)
{
    (void)tx;
    const int panelIdx = menuEntryAtY(static_cast<int>(ty));
    if (panelIdx < 0)
        return;
    selectPanel(static_cast<Panel>(panelIdx));
}

/**
 * @brief Wechselt das angezeigte Panel.
 */
void Settings::selectPanel(Panel p)
{
    if (p == m_panel)
        return;
    m_panel = p;
    if (p == Panel::SECURITY)
    {
        m_confirmPinDisable = false;
        resetPinEntry();
        m_numpadLayoutValid = false;
    }
    if (p == Panel::CLOUD)
        m_cloudValuesVisible = false;
    m_menuDirty = true;
    m_workDirty = true;
    m_footerDirty = true;
}

/**
 * @brief Verteilt einen Tap im Arbeitsbereich an das aktive Panel.
 */
void Settings::handleWorkTouch(int32_t tx, int32_t ty)
{
    const int sx = static_cast<int>(tx) - WORK_X;
    const int sy = static_cast<int>(ty) - WORK_Y;

    switch (m_panel)
    {
    case Panel::WIFI:
        handleWifiTouch(sx, sy);
        break;
    case Panel::GENERAL:
        handleGeneralTouch(sx, sy);
        break;
    case Panel::SECURITY:
        handleSecurityTouch(sx, sy);
        break;
    case Panel::NEWS:
        handleNewsTouch(sx, sy);
        break;
    case Panel::WEATHER:
        handleWeatherTouch(sx, sy);
        break;
    case Panel::CLOUD:
        handleCloudTouch(sx, sy);
        break;
    case Panel::TIME:
        handleTimeTouch(sx, sy);
        break;
    case Panel::TIME_WINDOW:
        handleTimeWindowTouch(sx, sy);
        break;
    case Panel::AUDIO:
        handleAudioTouch(sx, sy);
        break;
    case Panel::APPEARANCE:
        handleAppearanceTouch(sx, sy);
        break;
    default:
        break;
    }
}

/**
 * @brief Behandelt Taps im WLAN-Panel.
 */
void Settings::handleWifiTouch(int sx, int sy)
{
    for (int i = 0; i < MAX_PROFILES; ++i)
    {
        const Rect t = wifiToggleRect(i);
        if (pointIn(sx, sy, t.x, t.y, t.w, t.h))
        {
            onToggleWifi(i);
            return;
        }
        const Rect r = wifiRowRect(i);
        if (pointIn(sx, sy, r.x, r.y, r.w, r.h))
        {
            if (m_selWifi != i)
            {
                m_selWifi = i;
                m_workDirty = true;
            }
            return;
        }
    }

    const bool configured = isProfileValid(m_selWifi);
    for (int k = 0; k < 4; ++k)
    {
        const Rect a = wifiActionRect(k);
        if (!pointIn(sx, sy, a.x, a.y, a.w, a.h))
            continue;

        if (k != 0 && !configured)
            return; // Passwort/Test/Löschen brauchen eine SSID

        switch (k)
        {
        case 0:
            startScan(m_selWifi);
            break;
        case 1:
            startPasswordInput(m_selWifi);
            break;
        case 2:
            startConnectionTest(m_selWifi);
            break;
        case 3:
            startClearProfileDialog(m_selWifi);
            break;
        default:
            break;
        }
        return;
    }

    const Rect hf = hostnameFieldRect();
    if (pointIn(sx, sy, hf.x, hf.y, hf.w, hf.h))
        startHostnameInput();
}

/**
 * @brief Behandelt Sprachwahl und Log-Schalter im Allgemein-Panel.
 */
void Settings::handleGeneralTouch(int sx, int sy)
{
    const Rect toggle = serialLogsToggleRect();
    if (pointIn(sx, sy, CONTENT_X, toggle.y, CONTENT_W, toggle.h))
    {
        if (!APP_STATE.setSerialLogsEnabled(!APP_STATE.getSerialLogsEnabled()))
            showInfoBox(SettingsKey::SETTINGS_LOGS_SECTION, SettingsKey::SETTINGS_LOGS_WRITE_ERROR);
        m_workDirty = true;
        return;
    }

    for (int i = 0; i < 2; ++i)
    {
        const Rect r = langRowRect(i);
        if (pointIn(sx, sy, r.x, r.y, r.w, r.h))
        {
            applyLanguage(i);
            return;
        }
    }
}

/**
 * @brief Behandelt Taps im Sicherheit-Panel (Nummernblock).
 */
void Settings::handleSecurityTouch(int sx, int sy)
{
    const Rect toggle = pinLockToggleRect();
    if (pointIn(sx, sy, CONTENT_X, toggle.y, CONTENT_W, toggle.h))
    {
        resetPinEntry();
        if (APP_STATE.isPinLockEnabled())
            m_confirmPinDisable = !m_confirmPinDisable;
        else
            changePinLock(true, nullptr);

        m_workDirty = true;
        return;
    }

    const int cx = sx - CONTENT_X;
    const int cy = sy - CONTENT_Y;
    const int key = m_numpad.hitTest(cx, cy);
    if (key < 0)
        return;

    handlePinKey(WorkshopNumpad::keyAction(key));
    if (m_state == State::IDLE)
        m_workDirty = true;
}

// ===================================================================
// Sprache und PIN
// ===================================================================

/**
 * @brief Schaltet die PIN-Sperre um oder zeigt den Grund der Ablehnung.
 */
void Settings::changePinLock(bool enabled, const char *pin)
{
    const auto result = APP_STATE.setPinLockEnabled(enabled, pin);
    resetPinEntry();
    m_pinMismatch = result == AppState::PinLockResult::WrongPin;
    m_confirmPinDisable = m_pinMismatch;
    if (result == AppState::PinLockResult::StorageError)
        showInfoBox(SettingsKey::SETTINGS_SEC_TITLE, SettingsKey::SETTINGS_SEC_WRITE_ERROR);
}

/**
 * @brief Liefert den Index der aktuell aktiven Sprache (0=de, 1=en).
 */
int Settings::currentLangIndex() const
{
    return (I18n::currentLang() == LangIndex::EN) ? 1 : 0;
}

/**
 * @brief Prüft, ob eine abweichende Sprache vorgemerkt ist.
 */
bool Settings::languagePending() const
{
    return m_pendingLangIndex >= 0 && m_pendingLangIndex != currentLangIndex();
}

/**
 * @brief Merkt die gewählte Sprache vor (wird erst beim Speichern angewendet).
 */
void Settings::applyLanguage(int langIndex)
{
    m_pendingLangIndex = (langIndex == currentLangIndex()) ? -1 : langIndex;
    recomputeDirtyFlags();
    m_workDirty = true;
    m_footerDirty = true;
}

/**
 * @brief Setzt die laufende PIN-Eingabe zurück (eine vorgemerkte PIN bleibt erhalten).
 */
void Settings::resetPinEntry()
{
    m_pinLen = 0;
    m_pinEntry[0] = '\0';
    m_pinConfirming = false;
    m_pinFirst[0] = '\0';
    m_pinMismatch = false;
}

/**
 * @brief Verarbeitet eine Nummernblock-Taste für die PIN.
 *
 * Erst werden vier Ziffern eingegeben, dann zur Kontrolle wiederholt. Stimmen beide überein, wird die PIN nur vorgemerkt und der Speichern-Knopf aktiv; bei Abweichung erscheint ein Hinweis und die Eingabe beginnt von vorn.
 */
void Settings::handlePinKey(char action)
{
    if (action >= '0' && action <= '9')
    {
        m_pinMismatch = false;
        if (m_pinLen < 4)
        {
            m_pinEntry[m_pinLen++] = action;
            m_pinEntry[m_pinLen] = '\0';
        }
        if (m_pinLen < 4)
            return;

        if (m_confirmPinDisable)
        {
            changePinLock(false, m_pinEntry);
            return;
        }

        if (!m_pinConfirming)
        {
            stringutils::safeCopy(m_pinFirst, m_pinEntry);
            m_pinConfirming = true;
            m_pinLen = 0;
            m_pinEntry[0] = '\0';
            return;
        }

        if (strcmp(m_pinEntry, m_pinFirst) == 0)
            stringutils::safeCopy(m_pinPending, m_pinEntry);
        else
            m_pinMismatch = true;

        m_pinConfirming = false;
        m_pinFirst[0] = '\0';
        m_pinLen = 0;
        m_pinEntry[0] = '\0';
        recomputeDirtyFlags();
        return;
    }

    if (action == 'B')
    {
        if (m_pinLen > 0)
        {
            m_pinLen--;
            m_pinEntry[m_pinLen] = '\0';
        }
        return;
    }

    if (action == 'C')
        resetPinEntry();
}

/**
 * @brief Setzt eine vorgemerkte PIN tatsächlich als Sperr-PIN.
 * @return true wenn eine PIN vorgemerkt war und gesetzt wurde
 */
bool Settings::applyPendingPin()
{
    if (m_pinPending[0] == '\0')
        return false;

    if (!APP_STATE.setLockPin(m_pinPending))
    {
        m_pinSaveErrorPending = true;
        return false;
    }
    m_pinPending[0] = '\0';
    m_pinMismatch = false;
    LOG_SUCCESS("Neue Sperr-PIN gespeichert");
    return true;
}

/**
 * @brief Prüft, ob eine PIN vorgemerkt, aber noch nicht gespeichert ist.
 */
bool Settings::pinPending() const
{
    return m_pinPending[0] != '\0';
}

// ===================================================================
// State-Machine für Dialoge und Test
// ===================================================================

/**
 * @brief Wechselt den State-Machine-Zustand.
 */
void Settings::changeState(State newState)
{
    m_state = newState;
    m_operationStartTime = millis();
}

/**
 * @brief Aktualisiert den Zustand TESTING.
 */
void Settings::updateTestingState()
{
    if (!m_activeProgressBox)
    {
        char title[40];
        STRF(title, SettingsKey::SETTINGS_WIFI_TEST_BOX_TITLE);
        char msg[64];
        STRF(msg, SettingsKey::SETTINGS_WIFI_TEST_RUNNING);
        m_activeProgressBox.reset(new ProgressBox(*m_tft));
        m_activeProgressBox->setAutoCenter(true);
        m_activeProgressBox->setTitle(title);
        m_activeProgressBox->start(msg, 0);
    }

    const uint32_t elapsed = millis() - m_operationStartTime;
    const int progress = (elapsed >= TEST_TIMEOUT) ? 100 : static_cast<int>((elapsed * 100UL) / TEST_TIMEOUT);
    m_activeProgressBox->updateProgress(progress);

    yield();

    if (checkTestStatus())
    {
        if (m_activeProgressBox)
        {
            m_activeProgressBox->finish();
            m_activeProgressBox.reset();
        }
        showTestResult();
    }
}

/**
 * @brief Aktualisiert den Zustand SHOWING_MESSAGE.
 */
void Settings::updateMessageState()
{
    if (!m_activeMessageBox)
    {
        changeState(State::IDLE);
        afterModalRedraw();
        return;
    }

    m_activeMessageBox->update();

    if (m_activeMessageBox->isBusy())
        m_activeMessageBox->completeConfirmation(true);

    if (!m_activeMessageBox->isActive())
    {
        m_activeMessageBox.reset();
        changeState(State::IDLE);
        afterModalRedraw();
    }
}

/**
 * @brief Aktualisiert den Zustand SAVING.
 */
void Settings::updateSavingState()
{
    if (!m_activeMessageBox)
    {
        changeState(State::IDLE);
        afterModalRedraw();
        return;
    }

    m_activeMessageBox->update();

    if (m_activeMessageBox->isBusy())
        m_activeMessageBox->completeConfirmation(true);

    if (!m_activeMessageBox->isActive())
    {
        m_activeMessageBox.reset();
        changeState(State::IDLE);
        afterModalRedraw();
    }
}

/**
 * @brief Behandelt verzögerte kritische Aktionen (Neustart/Exit).
 * @return true, wenn das Modul danach möglicherweise abgebaut ist
 */
bool Settings::handleDeferredActions()
{
    if (m_pinSaveErrorPending && m_state == State::IDLE)
    {
        m_pinSaveErrorPending = false;
        selectPanel(Panel::SECURITY);
        showInfoBox(SettingsKey::SETTINGS_SEC_TITLE, SettingsKey::SETTINGS_SEC_WRITE_ERROR);
        return true;
    }

    if (m_restartRequested)
    {
        m_restartRequested = false;
        performRestart();
        return true;
    }

    if (m_exitRequested)
    {
        m_exitRequested = false;
        if (m_callbacks.onExitRequested)
        {
            m_callbacks.onExitRequested();
            return true;
        }
    }
    return false;
}

/**
 * @brief Führt einen robusten Neustart aus.
 */
void Settings::performRestart()
{
    LOG_INFO("Neustart wird durchgeführt...");

    if (m_callbacks.onRestartRequested)
        m_callbacks.onRestartRequested();

    WiFi.disconnect(true, true);
    WiFi.mode(WIFI_OFF);

    Serial.flush();
    delay(100);

    // USB Serial/JTAG D+ Pull-up deaktivieren, sonst hängt esp_restart() gelegentlich
    usb_serial_jtag_ll_disable_intr_mask(USB_SERIAL_JTAG_LL_INTR_MASK);
    *(volatile uint32_t *)USB_SERIAL_JTAG_CONF0_REG &= ~(1 << 9);
    delay(100);

    esp_restart();

    while (true)
        delay(1000);
}

// ===================================================================
// WLAN-Aktionen
// ===================================================================

/**
 * @brief Schaltet ein Profil aktiv/inaktiv.
 */
void Settings::onToggleWifi(int profileIndex)
{
    if (profileIndex < 0 || profileIndex >= MAX_PROFILES)
        return;

    if (!m_profiles[profileIndex].enabled && !isProfileValid(profileIndex))
    {
        showInfoBox(SettingsKey::SETTINGS_WIFI_NEED_SSID_TITLE, SettingsKey::SETTINGS_WIFI_NEED_SSID_MSG);
        return;
    }

    m_profiles[profileIndex].enabled = !m_profiles[profileIndex].enabled;
    recomputeDirtyFlags();
    m_workDirty = true;
    m_footerDirty = true;

    LOG_INFO_F("Profil %d: %s", profileIndex + 1, m_profiles[profileIndex].enabled ? "aktiviert" : "deaktiviert");
}

/**
 * @brief Startet den WLAN-Scan (blockierender Modal-Dialog).
 */
void Settings::startScan(int profileIndex)
{
    if (profileIndex < 0 || profileIndex >= MAX_PROFILES)
        return;

    m_currentProfileIndex = profileIndex;

    char label[48];
    STRF(label, SettingsKey::SETTINGS_WIFI_SCAN_TITLE);

    WifiList wifiList(m_tft);
    char selectedSSID[65] = {0};
    wifiList.setPosition(150, 90);
    wifiList.setSize(500, 300);

    if (wifiList.show(label, selectedSSID) && strlen(selectedSSID) > 0)
    {
        stringutils::safeCopy(m_profiles[profileIndex].ssid, selectedSSID);
        m_profiles[profileIndex].tested_ok = false;
        recomputeDirtyFlags();
        LOG_SUCCESS_F("SSID gewählt: %s", selectedSSID);
    }

    afterModalRedraw();
}

/**
 * @brief Startet die Passwort-Eingabe (blockierender Modal-Dialog).
 */
void Settings::startPasswordInput(int profileIndex)
{
    if (profileIndex < 0 || profileIndex >= MAX_PROFILES)
        return;

    if (!isProfileValid(profileIndex))
    {
        showInfoBox(SettingsKey::SETTINGS_WIFI_NEED_SSID_TITLE, SettingsKey::SETTINGS_WIFI_NEED_SSID_MSG);
        return;
    }

    m_currentProfileIndex = profileIndex;

    Keyboard keyboard(m_tft);
    keyboard.setPasswordMode(true);

    char password[65] = {0};
    stringutils::safeCopy(password, m_profiles[profileIndex].password);

    char label[96];
    STRF(label, SettingsKey::SETTINGS_WIFI_PW_TITLE_FMT, m_profiles[profileIndex].ssid);

    if (keyboard.show(label, password, sizeof(password), password))
    {
        char normalized[65] = {0};
        SettingsKey errorKey = SettingsKey::SETTINGS_EMPTY;

        if (!validateAndNormalizePassword(password, normalized, sizeof(normalized), errorKey))
        {
            afterModalRedraw();
            showInfoBox(SettingsKey::SETTINGS_WIFI_PW_BAD_TITLE, errorKey);
            return;
        }

        stringutils::safeCopy(m_profiles[profileIndex].password, normalized);
        m_profiles[profileIndex].tested_ok = false;
        recomputeDirtyFlags();
        LOG_SUCCESS("Passwort aktualisiert");
    }

    afterModalRedraw();
}

/**
 * @brief Startet den Verbindungstest für ein Profil.
 */
void Settings::startConnectionTest(int profileIndex)
{
    if (profileIndex < 0 || profileIndex >= MAX_PROFILES)
        return;

    if (!isProfileConfigured(profileIndex))
    {
        showInfoBox(SettingsKey::SETTINGS_WIFI_NEED_SSID_TITLE, SettingsKey::SETTINGS_WIFI_NEED_SSID_MSG);
        return;
    }

    m_currentProfileIndex = profileIndex;
    m_testState = TestState::CONNECTING;

    char title[40];
    STRF(title, SettingsKey::SETTINGS_WIFI_TEST_BOX_TITLE);
    char prep[64];
    STRF(prep, SettingsKey::SETTINGS_WIFI_TEST_PREPARE);

    m_activeProgressBox.reset(new ProgressBox(*m_tft));
    m_activeProgressBox->setAutoCenter(true);
    m_activeProgressBox->setTitle(title);
    m_activeProgressBox->start(prep, 0);

    delay(50);

    WiFi.disconnect(false);
    delay(250);
    WiFi.mode(WIFI_STA);
    delay(100);
    WiFi.begin(m_profiles[profileIndex].ssid, m_profiles[profileIndex].password);

    if (m_activeProgressBox)
    {
        char run[64];
        STRF(run, SettingsKey::SETTINGS_WIFI_TEST_RUNNING);
        m_activeProgressBox->updateMessage(run);
    }

    changeState(State::TESTING);
}
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
