DIYLAB-DE/RetroRadio/include/SDPlayer.h

#ifndef SD_PLAYER_H
#define SD_PLAYER_H

#include <JPEGDEC.h>

#include <memory>
#include <vector>

#include "AppState.h"
#include "AudioManager.h"
#include "AudioSliderTouch.h"
#include "BaseModule.h"
#include "Button.h"
#include "FileExplorer.h"
#include "Gfx.h"
#include "Logger.h"
#include "MessageBox.h"
#include "SleepTimer.h"
#include "Visualizer.h"

class DS1307_RTC;

/**
 * @brief Audio-Status Struktur für Playback-Information
 *
 * Enthält alle relevanten Informationen über den aktuellen Wiedergabestatus eines Audio-Tracks.
 */
struct AudioStatus
{
    uint32_t fileSize = 0;    ///< Gesamtgröße der Audiodatei in Bytes
    uint32_t filePos = 0;     ///< Aktuelle Position in der Datei in Bytes
    uint32_t duration = 0;    ///< Gesamtdauer des Tracks in Sekunden
    uint32_t currentTime = 0; ///< Aktuelle Wiedergabezeit in Sekunden
    uint8_t progress = 0;     ///< Fortschritt in Prozent (0-100%)
    bool isPlaying = false;   ///< Wiedergabe aktiv
};

/**
 * @brief Callback-Struktur für das SD-Player Modul
 *
 * Enthält alle Callback-Funktionen, die vom SD-Player aufgerufen werden, um mit dem Hauptprogramm zu kommunizieren.
 */
struct SdPlayerCallbacks
{
    void (*onExitRequested)() = nullptr;                     ///< Wird aufgerufen, wenn das Modul verlassen werden soll
    void (*onVolumeChanged)(uint8_t volume) = nullptr;       ///< Wird aufgerufen, wenn die Lautstärke geändert wurde
    void (*onBalanceChanged)(int8_t balance) = nullptr;      ///< Wird aufgerufen, wenn die Balance geändert wurde
    void (*onGainLowPassChanged)(int8_t gain) = nullptr;     ///< Wird aufgerufen, wenn die Tiefen geändert wurden
    void (*onGainBandPassChanged)(int8_t gain) = nullptr;    ///< Wird aufgerufen, wenn die Mitten geändert wurden
    void (*onGainHighPassChanged)(int8_t gain) = nullptr;    ///< Wird aufgerufen, wenn die Höhen geändert wurden
    void (*onVUModeChanged)(VisMode mode) = nullptr;         ///< Wird aufgerufen, wenn der VU-Mode geändert wurde
    void (*onPlayFileRequested)(const char *path) = nullptr; ///< Wird aufgerufen, wenn eine Datei abgespielt werden soll
    void (*onStopRequested)() = nullptr;                     ///< Wird aufgerufen, wenn die Wiedergabe gestoppt werden soll
    void (*onPauseResumeRequested)() = nullptr;              ///< Wird aufgerufen, wenn Pause/Resume getriggert wurde
    void (*onSeekOffsetRequested)(int sec) = nullptr;        ///< Wird aufgerufen, wenn im Titel gespult werden soll, negativ spult zurück
};

/**
 * @brief Struktur für Button-Definitionen
 *
 * Definiert Position, Größe, Farben und Label eines Buttons.
 */
struct SdPlayerButton
{
    int16_t x;             ///< X-Koordinate der linken oberen Ecke
    int16_t y;             ///< Y-Koordinate der linken oberen Ecke
    uint16_t w;            ///< Breite des Buttons in Pixeln
    uint16_t h;            ///< Höhe des Buttons in Pixeln
    uint16_t r;            ///< Radius für abgerundete Ecken
    uint16_t outlinecolor; ///< Umrandungsfarbe (RGB565)
    uint16_t fillcolor;    ///< Füllfarbe (RGB565)
    uint16_t textcolor;    ///< Textfarbe (RGB565)
    const char *label;     ///< Button-Text oder Symbol-Code
};

/**
 * @brief Parametersatz für ein Kassetten-Design auf Farbtabellen-Basis
 *
 * Grundlage ist eine 285x184-Farbtabelle aus einer fotorealistischen Vorlage. Animiert werden nur das Bandfenster (Wickelbögen) und die beiden Naben, über die der in buildWrapSprite() gezeichnete Einheitsdorn rotiert gelegt wird. Alle Koordinaten beziehen sich auf das Kassetten-Sprite.
 */
struct CassetteDesign
{
    const unsigned short *bitmap; ///< 285x184-Farbtabelle (RGB565) der Kassette
    uint16_t labelText;           ///< Schriftfarbe des Interpreten auf dem Beschriftungsstreifen
    int16_t labelX;               ///< Interpreten-Zone, linke Kante
    int16_t labelY;               ///< Interpreten-Zone, obere Kante
    int16_t labelW;               ///< Interpreten-Zone, Breite; 0 = die Vorlage hat keinen freien Streifen
    uint16_t tape;                ///< dunklere Lagenringe im Bandwickel
    uint16_t tapeEdge;            ///< Grundfarbe des Bandwickels
    int16_t winX;                 ///< Bandfenster, linke Kante
    int16_t winY;                 ///< Bandfenster, obere Kante
    int16_t winW;                 ///< Bandfenster, Breite
    int16_t winH;                 ///< Bandfenster, Höhe
    int16_t hubY;                 ///< Höhe der Nabenzentren
    int16_t hubXLeft;             ///< Nabenzentrum links; voll gekachelte Fenster: 82/202 (echter C-Kassetten-Abstand 42,5/100,4 der Breite)
    int16_t hubXRight;            ///< Nabenzentrum rechts; Bullaugen-Designs folgen stattdessen den sichtbaren Vorlagen-Tellern
    int16_t hubCoverR;            ///< Deckradius des Einheitsdorns: groß genug für den Vorlagen-Teller, klein genug für die Nabenöffnung
    int16_t reelRMin;             ///< Wickelradius leer, an die Proportionen der Vorlage angepasst; mindestens 25, damit der Einheitsdorn immer im Band sitzt
    int16_t reelRMax;             ///< Wickelradius voll: 24,5/42,5 des Nabenabstands, wie bei einer echten C90
};

/**
 * @brief Hauptklasse für den SD-Karten Music-Player
 *
 * Diese Klasse implementiert einen vollständigen Music-Player mit folgenden Features:
 * - Playlist-Verwaltung mit Scroll-Funktion, ein Tipp auf einen Titel spielt ihn direkt
 * - Metadaten-Anzeige (Artist, Title, Bitrate)
 * - Cover-Image-Anzeige (JPEG/PNG)
 * - Animierte Kassetten-Ansicht mit wechselbaren Designs (Tipp auf die Kassette)
 * - Lautstärkeregler und 3-Band-Equalizer
 * - Player-Controls (Play, Pause, Stop, Previous, Next), Halten der Sprungtasten spult
 * - Fortschrittsanzeige mit Zeitangabe, Tippen springt, Ziehen scrubbt
 * - Sleep-Timer mit Uhr-Anzeige
 * - Integration mit AudioManager für Echtzeit-Audiodaten
 * - FileExplorer-Integration für Dateiauswahl
 */
class SdPlayer : public BaseModule
{
public:
    /**
     * @brief Konstruktor
     * @param tft Referenz auf das LGFX Display-Objekt
     * @param audio Referenz auf die Audio-Instanz für Playback-Steuerung
     *
     * Übernimmt die Referenzen auf Display und Audio-Instanz; sämtliche Allokationen (Sprites, Puffer) erfolgen erst in init() bzw. bei Bedarf.
     */
    explicit SdPlayer(LGFX &tft, Audio &audio);

    /**
     * @brief Destruktor
     */
    ~SdPlayer();

    /**
     * @brief Initialisiert das SD-Player Modul
     * @param rtc Referenz auf die Echtzeituhr
     * @param callbacks Struktur mit allen Callback-Funktionen
     * @return true bei erfolgreicher Initialisierung, false bei Fehler
     *
     * Erstellt alle UI-Elemente, initialisiert Sprites, zeichnet den initialen Zustand und bereitet das Modul für die Verwendung vor.
     */
    bool init(DS1307_RTC &rtc, const SdPlayerCallbacks &callbacks);

    /**
     * @brief Hauptzeichnungsschleife - muss zyklisch aufgerufen werden
     *
     * Verarbeitet:
     * - Touch-Input für alle interaktiven Elemente
     * - AudioManager-Events (EOF, ID3-Tags, Bitrate, Cover-Images)
     * - UI-Updates (Playlist, Metadaten, Fortschritt, Cover)
     * - Scroll-Physik für Playlist
     * - Button-Zustände und -Feedback
     * - Dialoge (Datei-Explorer, Meldungsbox, Sleep-Timer); Titelenden werden auch bei offenem Dialog verarbeitet
     */
    void draw() override;

    /**
     * @brief Gibt den Modul-Typ zurück
     * @return AppModule::SD_PLAYER
     *
     * Wird vom Modul-System verwendet, um den Typ zu identifizieren.
     */
    AppModule type() const override;

    /**
     * @brief Aktualisiert die Kassetten-Anzeige
     * @param force Erzwingt das Neuzeichnen von Wickeln und Zahnkränzen, etwa nach einem Designwechsel
     *
     * - Bandwickel: Radien r_L / r_R aus Flächenkonstanz (r^2 linear mit Bandlänge), neu gezeichnet nur bei sichtbarer Radiusänderung
     * - Zahnkränze: ω skaliert mit 1/r (über Referenzradius), transparent über die Wickel gelegt
     */
    void updateCassette(bool force = false);

    /**
     * @brief Kürzt Text UTF-8-sicher auf maxWidth (px) und hängt "..." an, gemessen mit der geladenen Schrift des Sprites
     * @param spr Sprite, dessen Schriftmetrik für die Breitenmessung gilt
     * @param in Eingabetext
     * @param out Zielpuffer für den gekürzten Text
     * @param outSize Größe des Zielpuffers in Bytes
     * @param maxWidth Maximale Textbreite in Pixeln
     */
    static void truncateWithEllipsis(Gfx_Sprite *spr, const char *in, char *out, int outSize, int maxWidth);

    /**
     * @brief Zeichnet den Interpreten zentriert auf den Beschriftungsstreifen des aktiven Designs (ComfortaaBold14)
     * @param force Erzwingt das Neuzeichnen auch bei unverändertem Text
     *
     * Designs ohne Beschriftungsstreifen (labelW = 0) bleiben unbeschriftet; gezeichnet wird nur, wenn sich der sichtbare gekürzte Text geändert hat oder force gesetzt ist.
     */
    void drawCassetteLabel(bool force = false);

    /**
     * @brief Callback für ein reguläres Track-Ende
     *
     * Wird vom AudioManager aufgerufen, wenn ein Track sauber beendet ist. Markiert den Track als abgespielt und startet den nächsten Track.
     */
    void onAudioTrackFinished();

    /**
     * @brief Aktualisiert Metadaten aus der Audio-Bibliothek
     * @param artist Interpret/Künstler (oder "" für keine Änderung)
     * @param title Titel des Songs (oder "" für keine Änderung)
     * @param bitrate Bitrate als String (oder "" für keine Änderung)
     *
     * Triggert ein UI-Update wenn sich Metadaten ändern.
     */
    void updateMetadata(const char *artist, const char *title, const char *bitrate);

private:
    /**
     * @brief Touch-Status für den Lautstärke-Regler
     */
    enum class KnobTouchState
    {
        IDLE,    ///< Kein Touch aktiv
        MUTE,    ///< Touch im Mute-Bereich (Mitte)
        ROTATING ///< Touch im Rotations-Bereich (außen)
    };

    // ===================================================================
    // private Hilfsfunktionen
    // ===================================================================

    /**
     * @brief Art der Track-Beendigung
     */
    enum class TrackFinishType
    {
        COMPLETED, ///< Track wurde regulär bis zum Ende abgespielt
        ABORTED    ///< Track wurde abgebrochen oder Start ist fehlgeschlagen
    };

    /**
     * @brief Fordert das Backend zum Stoppen der Wiedergabe auf
     */
    void requestBackendStop();

    /**
     * @brief Bricht wartende Start-/Cover-Zustände ab
     */
    void cancelPendingPlaybackWaits();

    /**
     * @brief Setzt laufzeitbezogene Playback-Daten zurück
     */
    void resetRuntimePlaybackState();

    /**
     * @brief Leert die angezeigten Metadaten
     * @param clearCurrentFile Wenn true, wird auch der aktuelle Dateipfad gelöscht
     */
    void clearDisplayedMetadata(bool clearCurrentFile = false);

    /**
     * @brief Behandelt einen regulär beendeten oder abgebrochenen Track konsistent
     * @param finishType Art der Beendigung
     * @param advanceToNext Wenn true, wird anschließend der nächste Track gestartet
     */
    void finalizeCurrentTrack(TrackFinishType finishType, bool advanceToNext);

    /**
     * @brief Rundet eine Bitrate auf die nächste Standard-MP3-Bitrate
     */
    uint32_t snapToStandardBitrate(uint32_t bitrate);

    /**
     * @brief Aktualisiert den Audio-Status durch Polling der Audio-Instanz
     *
     * Diese Methode wird periodisch (alle 1 Sekunde) aus draw() aufgerufen und aktualisiert alle relevanten Playback-Informationen:
     * - Wiedergabestatus (läuft/gestoppt); der Pausenzustand wird über m_playbackState geführt
     * - Zeitinformationen (currentTime/duration)
     * - Fortschritt in Prozent
     * - Dateigröße und Position
     */
    void updateAudioStatus();

    /**
     * @brief Entfernt Track-Nummerierungen vom Anfang des Dateinamens
     * @param filename Der Dateiname (ohne Pfad, mit Extension)
     * @param output Buffer für den bereinigten Namen
     * @param maxLen Maximale Länge des Output-Buffers
     *
     * Erkennt und entfernt verschiedene Nummerierungsmuster:
     * - "01 - Titel.mp3" -> "Titel"
     * - "01 Titel.mp3" -> "Titel"
     * - "2-01 Titel.mp3" -> "Titel"
     * - "01. Titel.mp3" -> "Titel"
     * - "Track 01 - Titel.mp3" -> "Titel"
     * - etc.
     *
     * Die Funktion ist flexibel und erkennt:
     * - 1-3 stellige Zahlen
     * - Optional: Disc-Nummer (z.B. "2-01")
     * - Verschiedene Trennzeichen: Leerzeichen, Minus, Punkt, Unterstrich
     * - Optional: "Track" oder "CD" Präfixe
     */
    void cleanupFilename(const char *filename, char *output, size_t maxLen);

    // ===================================================================
    // Cover-Image-Verwaltung
    // ===================================================================

    /**
     * @brief Zeigt das Ordnerbild, das eingebettete Cover oder einen Platzhalter in der vorhandenen Cover-Fläche
     * @return true bei angezeigtem Cover, false bei Platzhalter
     *
     * Ein Ordnerbild namens folder.jpg im Titelordner hat unabhängig von Groß- und Kleinschreibung Vorrang. Fehlt das Bild oder kann es nicht geladen werden, wird das eingebettete Cover versucht. Bereits angezeigte Ordnerbilder bleiben bei weiteren Titeln desselben Ordners erhalten.
     */
    bool loadAndDrawCover();

    /**
     * @brief Lädt und zeichnet ein JPEG-/PNG-Cover aus einer Bild- oder Audiodatei
     * @param filePath Pfad der zu lesenden Datei auf der SD-Karte
     * @param embedded true für den Cover-Block aus m_coverOffsets, false für die vollständige Bilddatei
     * @return true bei Erfolg, false bei ungültigen Daten, Lese- oder Dekodierfehlern
     *
     * Verwendet den wiederverwendbaren PSRAM-Puffer und skaliert ohne Verzerrung auf COVER_W x COVER_H; Überstände werden mittig beschnitten. JPEG wird bei Bedarf im Decoder verkleinert, PNG bleibt auf 500 x 500 Pixel begrenzt. Die Dateigröße beziehungsweise der Cover-Block darf höchstens 1 MB betragen. Erst das fertige Bild wird auf das Display übertragen.
     */
    bool loadCoverImage(const char *filePath, bool embedded);

    /**
     * @brief Setzt das Cover zurück (Platzhalter)
     */
    void resetCover();

    /**
     * @brief Zeichnet einen dynamischen Platzhalter in die Cover-Fläche, wenn kein Cover angezeigt werden kann. Nutzt Dateiname/Metadaten zur Akzentfarbe, Initialen und Unterzeile.
     * @param preferredText Optionaler Titel/Name; wenn leer, wird der Dateiname bereinigt.
     */
    void drawCoverFallback(const char *preferredText = nullptr);

    /**
     * @brief Details unter dem Cover zeichnen (Album, Format, Bitrate, Track xx/xx etc.); ohne geladenen Titel zeigt die Box SD-Kapazität und Playlist-Kurzfassung
     */
    void drawDetails(bool init);

    /**
     * @brief Infobox ohne geladenen Titel: SD-Kapazität oben, darunter Playlist-Kurzfassung oder Hinweis auf die Durchsuchen-Taste
     */
    void drawIdleDetails();

    // ===================================================================
    // Interne Strukturen
    // ===================================================================

    /**
     * @brief Scroll-State für die Playlist
     */
    struct ScrollState
    {
        int scrollOffset = 0;            ///< Aktueller Scroll-Offset in Pixeln
        int contentHeight = 0;           ///< Gesamthöhe des Playlist-Inhalts
        int viewportHeight = 0;          ///< Sichtbare Höhe des Viewports
        int maxScroll = 0;               ///< Maximaler Scroll-Offset
        float scrollVelocity = 0;        ///< Scroll-Geschwindigkeit für Trägheit
        float inertiaRemainder = 0;      ///< gesammelte Bruchteil-Bildpunkte der Trägheitsschritte; die Ganzzahl-Position schluckte sie sonst
        bool isDragging = false;         ///< Nutzer zieht gerade
        int dragStartX = 0;              ///< X-Position beim Start des Drags, entlarvt seitliche Wischgesten
        int dragStartY = 0;              ///< Y-Position beim Start des Drags
        int dragStartOffset = 0;         ///< Scroll-Offset beim Start des Drags
        unsigned long lastTouchTime = 0; ///< Zeitpunkt des letzten Touch-Events
        int lastTouchY = 0;              ///< Y-Position des letzten Touch-Events
        bool tapCandidate = false;       ///< Geste begann in ruhender Liste und kann noch ein Tipp werden
        unsigned long touchStartMs = 0;  ///< Zeitpunkt des Touch-Beginns für die Tipp-Haltezeit
        bool startedInPlaylist = false;  ///< aktuelle Geste begann im Playlist-Bereich; nur dann sind die Drag-Anker gültig
    };

    /**
     * @brief Playback-Status für Button-Visualisierung
     */
    enum class PlaybackState
    {
        STOPPED, ///< Keine Wiedergabe
        PLAYING, ///< Aktive Wiedergabe
        PAUSED   ///< Pausiert
    };

    /**
     * @brief Wiederholungsverhalten am natürlichen Titelende
     */
    enum class RepeatMode
    {
        OFF,     ///< Wiedergabeliste einmal bis zum Ende abspielen
        TRACK,   ///< Aktuellen Titel wiederholen
        PLAYLIST ///< Wiedergabeliste nach dem letzten Titel neu beginnen
    };

    // ===================================================================
    // Layout-Konstanten
    // ===================================================================
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
