DIYLAB-DE/RetroRadio/(commit log)

2026-10-29 RetroRadio mit Aufbau- und Bedienungsanleitung
    ESP32-S3-Firmware für 8 und 16 MB Flash, deutsche Dokumentation mit Geräte- und Webaufnahmen, Aufbaufotos, Schaltplan, CAD-/Druckprojekten sowie Google-Scripten als eigenständigen Projektstand aufnehmen.
    [H2C_PETG_Base_Plate.3mf, H2C_PETG_Base_Plate.step, H2C_PETG_Case.3mf, H2C_PETG_Case.step, H2C_PETG_Speaker_Grille.3mf, H2C_PETG_Speaker_Grille.step, H2C_PETG_Speaker_Mounting_Insert_BF37.3mf, H2C_PETG_Speaker_Mounting_Insert_BF37.step]
2026-10-29 Erstinstallationsanleitung als PDF ergänzen
    Den deutschen Ablauf für Windows, Linux und macOS mit echten Anschluss- und Einstellbildern als achtseitige PDF-Fassung bereitstellen. Den aktuellen Prüfstand und die PDF-Schriftlizenz ergänzen. Interne Ablagen zusätzlich von Git ausschließen.
2026-10-29 PDF-Anleitung kompakter binär speichern
    Die acht visuell geprüften Seiten bleiben pixelgleich. Binäre Bilddaten verkleinern die PDF-Datei und vermeiden eine irreführende Behandlung als Textdatei durch Git.
2026-10-29 Frank für die CAD-Lautsprechergitter danken
    Den Beitrag von Frank alias Tubefan aus dem Radio-Bastler-Forum im Einstieg und bei den Hardwaredownloads nennen.
2026-10-29 Herkunft des Helix-Decoders mit Fundstellen belegen
    Den frühen MP3-Import, die spätere GPLv3-Ergänzung und die öffentliche Bestätigung des Herkunftsprojekts verlinken. Die belegte Herkunft und die weiterhin offene Zuordnung der ursprünglichen Lizenzbedingungen getrennt beschreiben.
2026-10-29 Dokumentation sprachlich glätten und Navigation ergänzen
    Direkte Aufbauanweisungen statt Erzählertexten verwenden und Semikolons im Fließtext ersetzen. Alle Anleitungsseiten oben und unten mit Navigation zur Startseite, Dokumentation und zum jeweiligen Bereich versehen. Die Erstinstallations-PDF sprachlich angleichen.
2026-10-29 Platz für Bilder vor dem Laden reservieren
    Bildmaße für das Startfoto und die Werkzeugvorschauen angeben, damit nachladende Bilder die Sprünge zur Dokumentation und zu Werkzeugkategorien nicht verschieben.
2026-10-29 CAD- und Druckdateien nichtkommerziell lizenzieren
    Die zwölf 3MF- und STEP-Dateien erhalten CC BY-NC-SA 4.0 mit Urheberangaben und vollständigem Lizenztext. Die Software bleibt unter GPLv3, die Modellgeometrien bleiben unverändert.
2026-11-02 WLAN-Anzeige und Release v26.11.2 übernehmen
    Das magische Auge zeigt die WLAN-Signalstärke, die Versionsnummer bleibt beim späteren Eigenbau fest und die Goniometer-Figur behält ihre grüne Farbe. Aufbau- und Bedienungsunterlagen einschließlich Displayauswahl, Audiooptionen und Grafiken aktualisiert.
    Beide Firmwaregrößen aus dieser Veröffentlichungskopie erfolgreich gebaut und 1116 lokale Verweise geprüft.
2026-11-02 Augenskala und Release v26.11.2.1 übernehmen
    Das magische Auge bildet -85 bis -55 dBm auf seinen vollständigen Anzeigebereich ab, bei -70 dBm liegt der Ausschlag bei 50 Prozent. Die feste Revision unterscheidet diese Überarbeitung vom vorherigen Release desselben Tages.
    Bedienung und Versionsschema dokumentiert. Beide Firmwaregrößen aus diesem Stand erfolgreich gebaut, geänderte Augenskala mit der privaten 8-MB-Testfassung am Radio geprüft.
2026-11-05 Release v26.11.5 mit Audio- und Bedienverbesserungen vorbereiten
    Audioverarbeitung und Visualisierungen entlasten, Senderlisten sichern und wiederherstellen, einzelne Klangregler per Langdruck zurücksetzen und die PIN-Sperre optional abschalten. Unnötige Verbindungsstarts beim Senderwechsel und Radioschließen verhindern.
    Displayzucken ausdrücklich als offenen Fehler dokumentieren. Empfehlungen und erprobte 32-GB-SD-Karten nennen. LGFX 1.2.36, dauerhaft 13 MHz und feste Versionskennung v26.11.5 übernehmen. Beide Firmwaregrößen erfolgreich gebaut.
2026-11-06 Release v26.11.6 mit Ordnercovern und aktualisierten Anzeigen veröffentlichen
    Die abgenommenen Änderungen ergänzen Ordnercover, Codec-Anzeige und schaltbare serielle Logs sowie Korrekturen für Lautstärke null, Stereo-Erkennung und VU-Farben.
    52 echte Bildschirm- und Browseraufnahmen mit Vorschaubildern, Bedienungsanleitungen und die Erstinstallations-PDF bilden den aktuellen Gerätestand ab. Beide Flashvarianten wurden ohne Warnungen gebaut; die reguläre 8-MB-Firmware wurde am Gerät gestartet.
2026-11-06 Semikolons aus der Radio-Anleitung entfernen
    Die vier Prosa-Semikolons werden gemäß der bestehenden Schreibvorgabe durch Kommas ersetzt. Firmware und Release-Tag bleiben unverändert.
2026-11-06 Covergröße verständlich als 1 MB angeben
    Die bisherige Angabe 1.000.000 Bytes wird auf Wunsch durch die gleichwertige und leichter lesbare Angabe 1 MB ersetzt.
2026-11-07 Release v26.11.7 mit Sender-Sortierung und SD-Wiederholung veröffentlichen
    Der SD-Player erhält Titel- und Listenwiederholung sowie Bandwickel für den Listenfortschritt. Die Beschriftungen am Gerät und die Projektlinks sind korrigiert.
    Das Webportal ermöglicht die Sortierung aller 70 Senderplätze. Aktionsmenü, mobile Darstellung, Bedienelemente, Statusangaben und Ressort-Abwahl sind korrigiert.
    Die Bedienungsdokumentation, zehn Webaufnahmen im Darkmode und die Erstinstallations-PDF entsprechen dem Release. Die 8-MB- und 16-MB-Builds sind ohne Warnungen geprüft, die reguläre 8-MB-Firmware wurde auf dem Heimradio gestartet.
    [Button.cpp, Button.h, Off.cpp, RetroRadio.cpp, Routes.cpp, SDPlayer.cpp, SDPlayer.h, StationPicker.cpp]
2026-11-12 Release v26.11.12 mit schleichendem Sekundenzeiger veröffentlichen
    Die Gangart der Hauptmenü-Uhr kann am Gerät und im Browser gewählt werden und bleibt gespeichert. EM34, Zeitfensteranzeige und SD-Statusmeldungen sind korrigiert, der Webtitel ist gekürzt.
    Anleitungen, zehn Bildschirmaufnahmen samt Vorschaubildern und die Erstinstallations-PDF aktualisieren. Beide Flashgrößen sind ohne Compilerwarnungen gebaut, die reguläre 8-MB-Firmware ist auf zwei Geräten übertragen.
    [AppState.cpp, AppState.h, Gfx.cpp, MainScreen.cpp, MainScreen.h, Routes.cpp, Routes.h, SDPlayer.cpp]
